DeepSpace00/Awohali/README.md

# ᎠᏬᎭᎵ (Awohali)

Pronounced (Ah-wo-ha-lee)

This project is archived. Current development has migrated to [Codeberg](https://codeberg.org/Fiducial-Systems/Awohali)

An open source hardware GNSS receiver station for measuring tropospheric precipitable water vapor.

A master's thesis project within Embry-Riddle Aeronautical University's Physical Science Department.

⚠️ WARNING This project is currently under development ⚠️

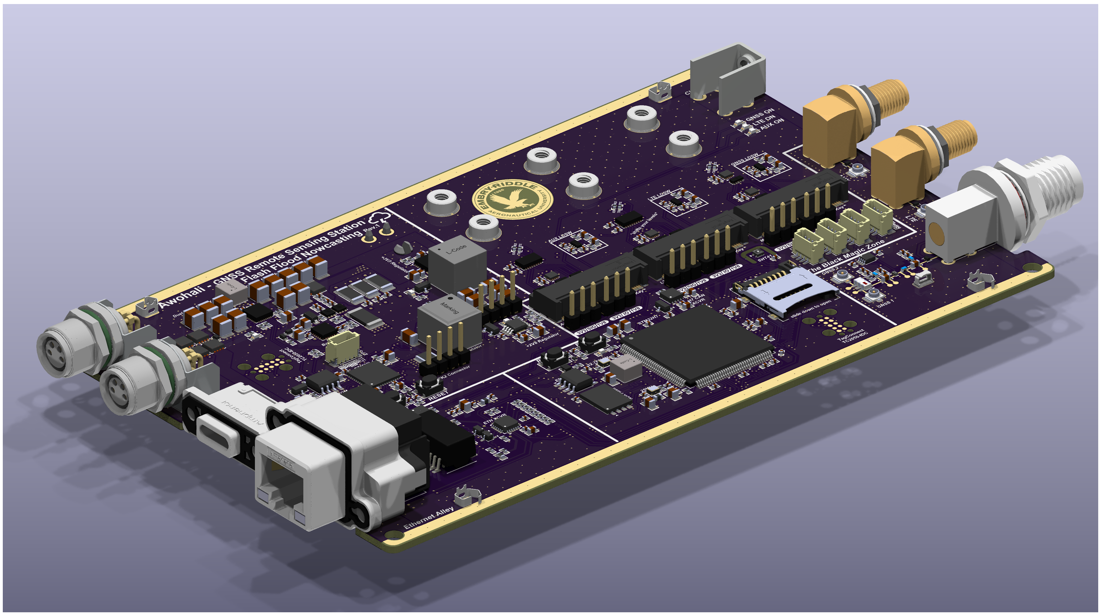
[picture p1: docs/assets/mainBoard_top_iso.png]


## Docs

https://deepspace00.github.io/Awohali/

## Hardware 

Preview with [KiCanvas](https://kicanvas.org/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)

## Licenses

Documentation, firmware, hardware, and software are individually licensed. Terms and conditions apply within their respective folders.

**Documentation -** [Apache License 2.0](docs/LICENSE)

**Firmware/Software -** [The MIT License](firmware/LICENSE)

**Hardware -** [CERN-OHL-P v2 or later](hardware/LICENSE)
