DeepSpace00/Awohali/hardware/mechanical/cables/power-cable/ALTW M Series M8 Product Specification.pdf

# Sensor M8 A/B/D Code

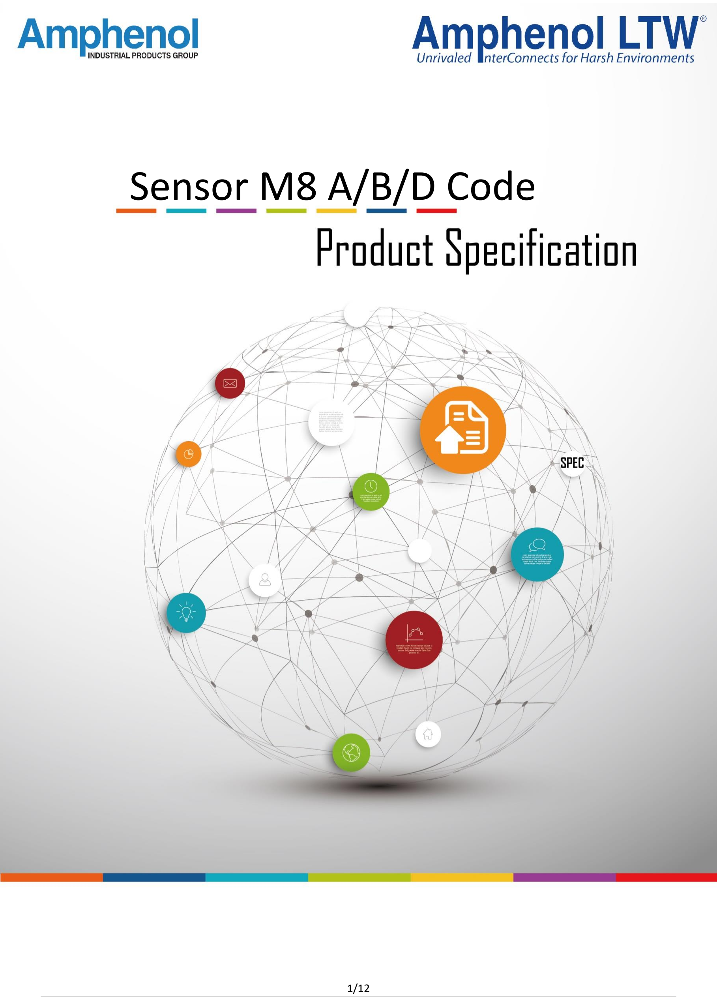
[picture p2: page 1]

### 1. Scope / 概論

A leading professional solutions provider of waterproof connectors (overmolded with cable, receptacle, field installable) in

the industry, Amphenol LTW always fulfills any requirements with high functionality and reliability products; even it is a

very special requirement. And it is highly recommended to be applied to harsh environment.

### Amphenol LTW（ALTW）是防水連接器計設及生產的領導者,主要包含線端,板端及現場組裝式連接器以滿足各種使用

### 求及特殊要求,產品具有高效能及高可靠性,非常適合在各種惡劣的環境條件下提供安裝及使用。

This product specification sheet describes the product application in the markets such as Renewable Energy, Industrial

Automation, LED Lighting, Marine, Broadband Wireless Access, Smart Grid, Heavy Equipment, Medical, Electrical

Vehicle….etc.

### 本規範主要描述了 Amphenol LTW(ALTW)產品的應用要求。 本產品廣泛應用於可再生能源，工業自動化，LED，船舶，

寬帶無線接入，智能電網，建築機械/重型車輛，醫療設備等，電動車行業....

### 2. Applicable Documents / 參考文件

### 2.1 Industry Document / 業界標準

Amphenol LTW（ALTW）設計及生產的產品符合各項世界標準,包括 IEC, EIA, MIL, NMEA….

### 3. Specification / 規格

### 3.1 Material / 材質

Parts / 零件 | Material / 材質
Connector / 連接器 | Thermoplastic / 熱塑性塑膠
Pin / 端子 | Copper Alloy / 銅合金
Nut / 螺帽 | Thermoplastic / 熱塑性塑膠, Metal / 金屬
Clamp Ring / 夾環 | Thermoplastic / 熱塑性塑膠
O-Ring / O 型環 Gasket / 墊圈 Seal / 密封圈 | Rubber / 橡膠
Shield/Shell / 屏蔽 | Metal / 金屬

### 3.2 Rating / 操作評級

Voltage 電壓 | Rated voltage – Rated impulse voltage
Name | CODE | Pin No. | Voltage
M8 | A | 3 | 50V AC / 60V DC
| A | 4 | 50V AC / 60V DC
| D | 4 | 50V AC / 63V DC
| B | 5 | 30V AC/DC
| A | 6 | 30V AC/DC
| A | 8 | 30V AC/DC

Current 電流

Name | CODE | Pin No. | Current Rating
M8 | A | 3 | 3A & 4A
| A | 4 | 3A & 4A
| D | 4 | 3A & 4A
| B | 5 | 3A
| A | 6 | 1.5A
| A | 8 | 1.5A
Operating Temperature 操作溫度 | Overmolded With Cable / Receptacle With Wires : -25°C~85°C (攝氏-25 度~85 度) Receptacle / Field Installable : -40°C~105°C (攝氏-40 度~105 度)
IP 防水等級 | Overmolded With Cable : IP67 (Mated, 1M /30min) / IP68 (Mated, 1M / 24h) Receptacle / Receptacle With Wires : IP67 (Unmated, 1M /30min)/ IP68 (Unmated, 1M /24h) / IP69K (Mated) Field Installable : IP67 (Mated, 1M /30min) / IP68 (Mated, 1M / 24h)

### 4. Test Requirement/測試要求

### 4.1 Appearance/外觀

Item / 項目 | Test Condition / 測試條件 | Requirement / 條件需求
Examination of product 外觀檢查 | IEC 60512, Test 1a Visual inspection No physical damage 檢查外觀是否有損壞 | No defect would impair normal operation 沒有缺陷會影響正常操作

### 4.2 Electrical/電氣

Item / 項目 | Test Condition / 測試條件 | Requirement / 條件需求
Dielectric Withstanding Voltage 耐電壓試驗 | IEC 60512, Test 4a, Method A Standard atmospheric conditions, Mated connectors 標準大氣條件,對接連接器 | See table A-1
Contact Resistance 接觸阻抗 | IEC 60512, Test 2a Standard atmospheric conditions connecting points 標準大氣壓力下測試接觸點 | •10 mΩ max. •10 mΩ 最大
Insulation Resistance 絕緣阻抗 | IEC 60512, Test 3a, Method A Standard atmospheric conditions Test voltage 500 V ± 15 V d.c. 標準大氣壓力下使用 500 V ± 15 V d.c.測試 | •10⁸mΩ min. •10⁸ mΩ 最小
Temperature Rise 溫升試驗 | UL1977 section 16.1, Mated connector carry the maximum rated current (table) continuously for 4 hour and measure the temperature rise of contact.UL1977 第 16.1 節，配合連接器連續輸入最大額定電流（附件）4 小時，測量接觸 溫升。 | •Temperature rise △t is no more than Relative Thermal Index of the insulating material •溫升△t 不大於絕緣材料的相對熱指數
| UL 2238 section 25, Mated connector carry the maximum rated current (table) continuously for 4 hour and measure the temperature rise of contact. 連接器對接後，額定電流(附件)持續輸入 4 小時，測量接觸點溫升。 | •UL : The temperature do not exceed the RTI of insulating material. •CUL : Temperature rise ∆t is no more than 30 ℃ , also for CUL ( CSA C22.2 No. 182.3,Clause 6.5 ) •UL: 溫度不超過絕緣材料的 RTI •CUL: 溫度升高Δt 不超過 30℃

### Table A-1

Voltage proof | kV r.m.s.
No. of ways | Between contacts | Between contacts and metal-housing
Fixed connectors | Free connectors | Fixed connectors | Free connectors
A | 3 | 1.0 | 1.0 | 0.85 | 0.85
A | 4 | 1.0 | 1.0 | 0.85 | 0.85
A | 6 | 0.65 | 0.65 | 0.65 | 0.65
A | 8 | 0.65 | 0.65 | 0.65 | 0.65
B | 5 | 0.65 | 0.65 | 0,65 | 0.65
D | 4 | 0.84 | 0.84 | 0.84 | 0.84

### 4.3 Mechanical/機械

Item / 項目 | Test Condition / 測試條件 | Requirement / 條件需求
Durability 耐久性 | IEC 60512, Test 9a Standard atmospheric conditions, Max. speed of operations = 10 mm/s, Rest:30s,unmated 最大插拔速率10mm/s, 分離狀態下停留30s | • No physical damage • 100 cycles for gold plating • 50 cycles for silver plating • 20 cycles for tin plating • 無物理損害 • 鍍金需至少滿足 100 次插拔 • 鍍銀需至少滿足 50 次插拔 • 鍍錫需至少滿足 20 次插拔
Insertion Force and Withdrawal force Test 插拔力 | IEC 60512, Test 13b Standard atmospheric conditions, Max. speed of operations = 10 mm/s, 標準大氣壓下測試, 最大插拔速度為10mm/s | 成品對插，無對鎖動作 • Total insertion force 3~8Pin: 30N maximum • Total withdrawal force 3~8Pin: 23N maximum • 插入力: 3~8Pin: 30N 最大 • 拔出力: 3~8Pin: 23N 最大
Vibration 震動試驗 | IEC 60512, Test 6d 10~500Hz, and 0.35mm or 50m/s2, sweep cycle: 10 cycle on each of the 3 axes 頻率 : 10~500Hz, 掃描周期: 每軸向做 10 個循環測試，3 個軸向均需測 | • No physical damages • No electrical discontinuity more than 1μ second. • 無物理損害 • 電氣訊斷不超過 1μ second
Mechanical Shock 物理沖擊 | IEC 60512-6-3, test 6c acceleration 500 m/s2 加速度 500m/s2 | •No physical damages •No electrical discontinuity more than 1μ second. •無物理損害 •電氣訊斷不超過 1μ second

### 4.4 Environmental/環境

Item / 項目 | Test Condition / 測試條件 | Requirement / 條件需求

Waterproof Test

防水測試

IEC 60529, IPX5

Test nozzle ∅6.3 mm, Water flow rate 12.5L/min, distance 2.5 m to 3 m,duration

3 minutes.

噴嘴∅6.3mm，水流速 12.5L / min，距離 2.5m 至 3m，持續時間 3 分鐘。

IEC 60529,IPX6

Test nozzle ∅12.5mm, Water flow rate 100L/min, distance 2.5 m to 3 m,duration

3 minutes.

噴嘴∅12.5mm，水流速 100L / min，距離 2.5 m 至 3 m，持續時間 3 分鐘。

IEC 60529, IPX7

Should be immersed in water at depth of at least 1 m for 30 mintues.

浸入深度至少 1 米的水中 30 分鐘。

IEC 60529, IPX8

should be immersed in water at depth of at least 1 m for 24 hours.

浸入深度至少 1 米的水中 24 小時。

IEC 60529, IPX9

Protected against high pressure and temperature water jets

防止高壓高溫的水柱噴射

DIN 40050-9, IPX9K

protection against high pressure/steam jet cleaning

防止高壓/蒸汽噴射清潔

•No physical damages

•Visual inspection inside no water

•Insulation resistance: >100MΩ

•無物理損壞

•目視內部無水侵入

•絕緣電阻：>100MΩ

Rapid change of temperature 溫度變化 | IEC 60512-11d –25 °C to 85 °C, t = 30 min, 5 cycles –25 °C to 85 °C, 時間 30 min, 5 個循環 | •No physical damages •無物理損壞
Salt Spray 鹽水噴霧試驗 | IEC 60068-2-60 5% salt solution for 48 hours 5%鹽水溶液持續 48 小時 | No physical damages and meets sequenced tests. 無物理損壞

### 5. Product Qualification Test Sequence/測試群組及順序

Test or Examination | Test Group
A | B | C | D | E | F | G
Examination of product | Visual Examination | 1,9 | 1,9 | 1,7 | 1,7 | 1,3 | 1,9 | 1,3
Electrical 電氣 | Contact Resistance | 2,6 | 2,6 | | 2,6
| insulation Resistance | 3,7 | 3,7 | 2,6 | | | 3,7
| Dielectric Withstanding Voltage | 4,8 | 4,8 | 3,5 | | | 2,8
| Temperature Rise Test | | | | | 2
Mechanical 機械 | Insertion Force and Withdrawal force Test | | | | 3,5
| Durability | | | | 4
| Vibration Test | 5
| Mechanical Shock | | 5
Environmental 環境 | Rapid change of temperature | | | 4 | | | 5
| Salt Spray | | | | | | | 2
| Waterproof Test | | | | | | 4,6

### 6. Others/其他

### 6.1 Torque/扭力

Panel Nut / 鎖板 (板端) | 5~8 kgf.cm
Mating Nut (Overmolded With Cable/Field Installable) / 對插 (線端/組裝式) | 4~6 kgf.cm
Clamp Ring / 接管 (組裝式) | 3~4 kgf.cm
Sealing Nut / 尾蓋 (組裝式) | 6~8 kgf.cm
Screw of the Screw-in type / 鎖芯線螺絲 (組裝式) | 0.61~0.84 kgf.cm

6.2 Reflow recommended profile for SMT product.

IPC_JEDEC J-STD-020C

Recommended Soldering Profiles

Classification of Reflow Profiles

Profile Feature | Sn – Pb Eutectic Assembly | Lead (Pb)-Free Assembly (e.g. SnAgCu)
Average ramp-up rate (T(Smax.) to TP) | 3 °C/s maximum
Preheat • Temperature minimum (TS(min.)) • Temperature maximum (TS(max.)) • Time (TS(min.) to TS(max.)) (tS) | 100°C 150°C 60 s to 120 s | 150°C 200°C 60 s to 180 s
Time maintained above • Temperature minimum (TL) • Time (TL) | 183°C 60 s to 150 s | 217 60 s to 150 s
Minimum peak temperature (TP(min.)) | 215°C | 235°C
Recommended peak temperature (TP) | 235°C | 250°C
Maximum peak temperature (TP(max.)) | 260°C | 260°C
Time within 5°C of actual peak temperature (tP) | 10 s to 40 s | 20 s to 40 s
Ramp-down rate | 6°C/s maximum | 6°C/s maximum
Time 25°C to peak temperature | 6 min maximum | 8 min maximum

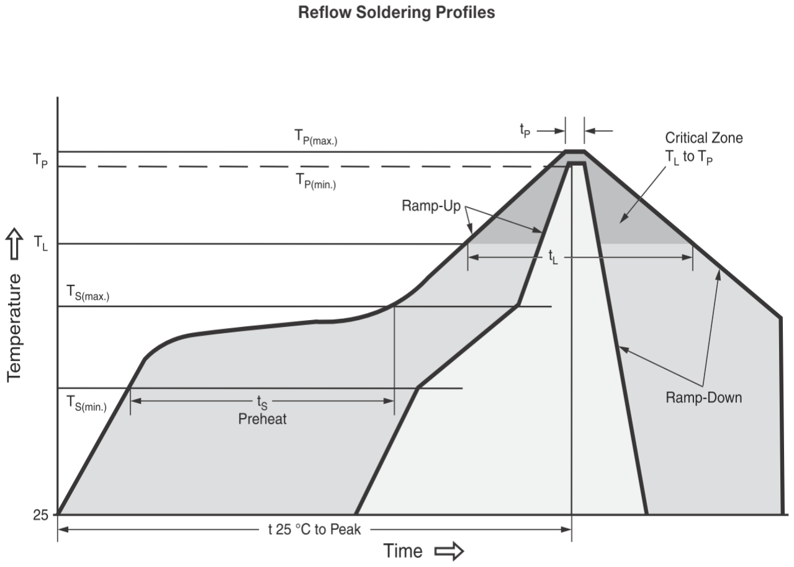
[picture p3: figure]

### 7. Quality Assurance Provisions/品質保證

Unless otherwise specified, in the contract or purchase order, we will be responsible for the quality of the part as it is

delivered to client. We will be responsible for having controlled processes to ensure product is in total compliance with this

specification. Failing lots shall be subject to return or other corrective action.

### 除非在合同或採購訂單中另有規定者外，我們將對交付給客戶的部件質量負責。 我們將負責控制流程，以確保產品

### 完全符合規格。 未通過的批次應退回或採取其他糾正措施。

### Re-qualification Testing : 重新資格測試

If changes significantly affecting form, fit or function are made to the product or manufacturing process, product assurance

shall coordinate requalification testing, consisting of all or part of the original testing sequence as determined by

development/product, quality and reliability engineering.

### 如果對產品或製造過程產生顯著影響的形狀，配合或功能的變化，產品保證應協調重新認證測試，包括由開發/產品，

### 質量和可靠性工程確定的全部或部分的原始測試順序。

Our products perform per the specification and criteria described in this document; any usage outside and/or deviating

from the specification and criteria described in this document, and/or any alteration, modification, transformation, and

application not mentioned in this document must be checked and agreed with ALTW in prior. Failure to check and get our

agreement, ALTW will bear no responsibility for any consequence that might arise. It is strongly advised to always check

with ALTW for any product application not mentioned in this document and/or applications that need clarifications.

### 本公司產品之規格及標準，皆依本說明書之說明。對於任何超出或背離本說明書規格範圍之產品使用，或對說明書

### 為提及的任何修改、變更，變造，應用，皆應取得 ALTW 事前的認可，否則 ALTW 對之不負擔任何責任。若對於本

### 說明書說明規格未有規定的事項，或使用上有疑義者，強烈建議先取得 ALTW 之確認及說明。

### 8. Revision/版本

Document Name | Sensor-M8
Revision | ECN NO. | Description | Date | Sign
A | | Initial Release | 2021/05/14 | Neo Tsai 蔡於潤
B | | Screw of the Screw-in type / 鎖芯線螺絲 (組裝式) change force | 2022/07/21 | Neo Tsai 蔡於潤
C | | Updated IP rate | 2023/03/16 | Yunchen Lai 賴昀辰
D | | Delete Voltage M8 A code 12Pin | 2023/05/24 | Jiahe Lin 林珈禾

### WI0814-05-表單 03A1
