DeepSpace00/Awohali/docs/assets/mainBoard_bottom.png

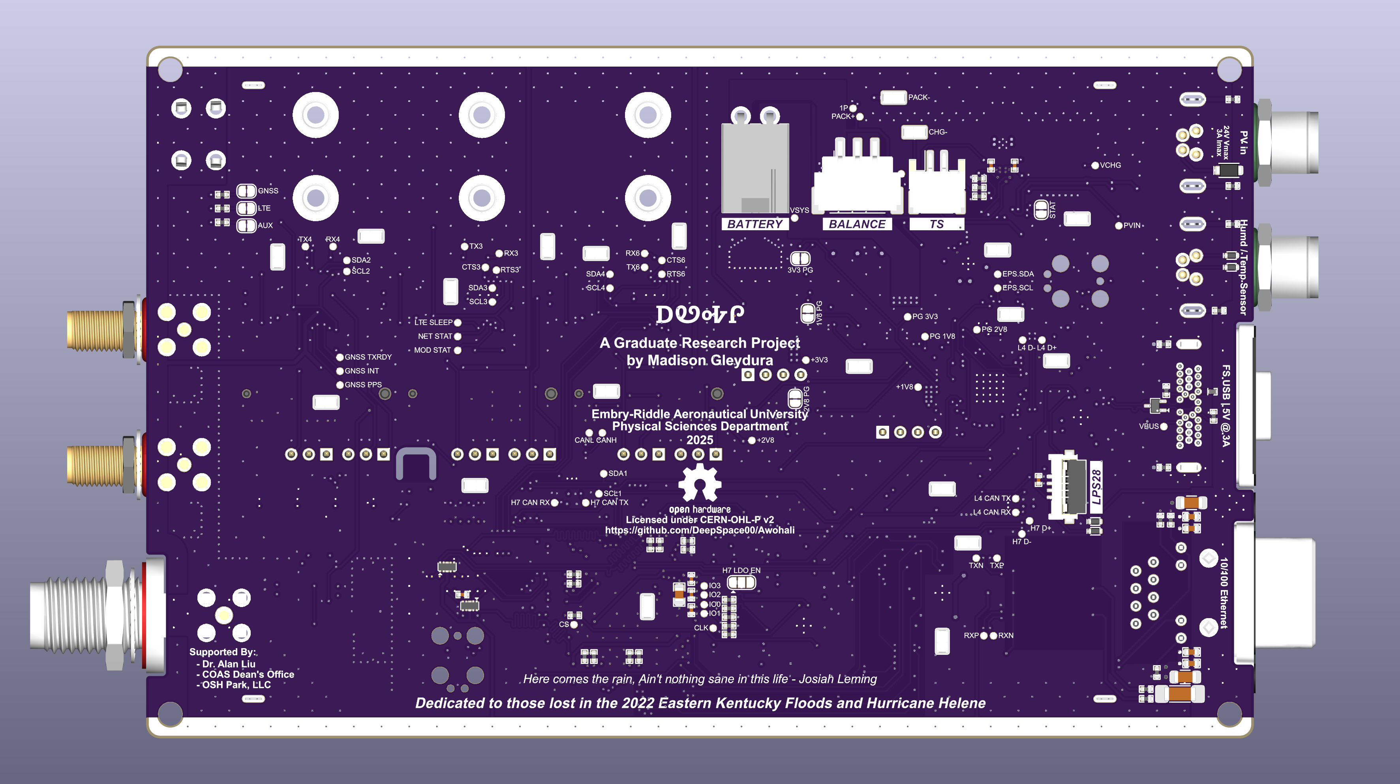
docs/assets/mainBoard_bottom.png
