DeepSpace00/Awohali/docs/assets/mainBoard_bottom_iso.png

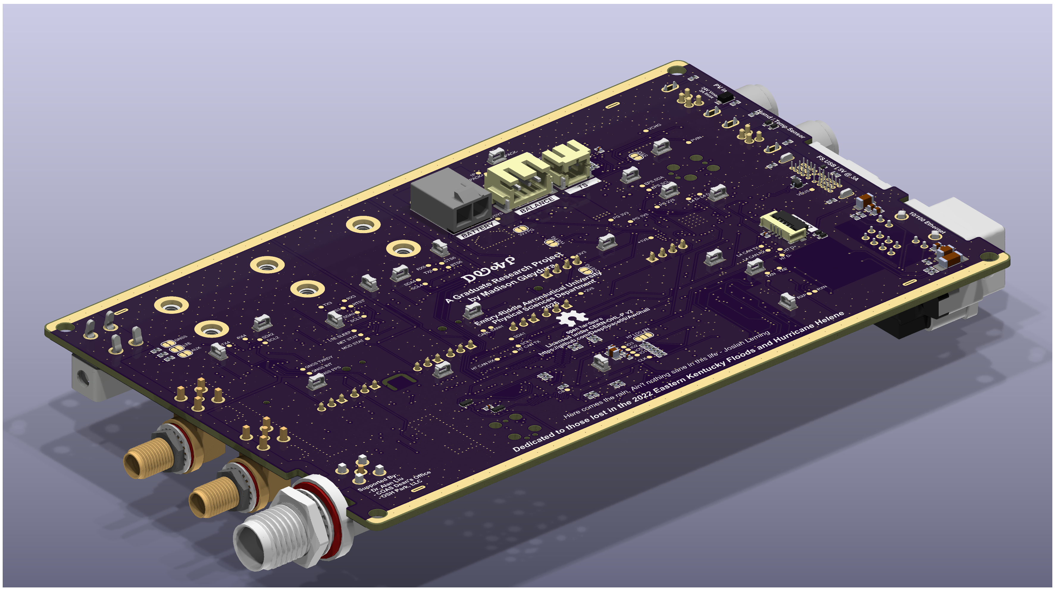
docs/assets/mainBoard_bottom_iso.png
