DeepSpace00/Awohali/docs/assets/mainBoard_top.png

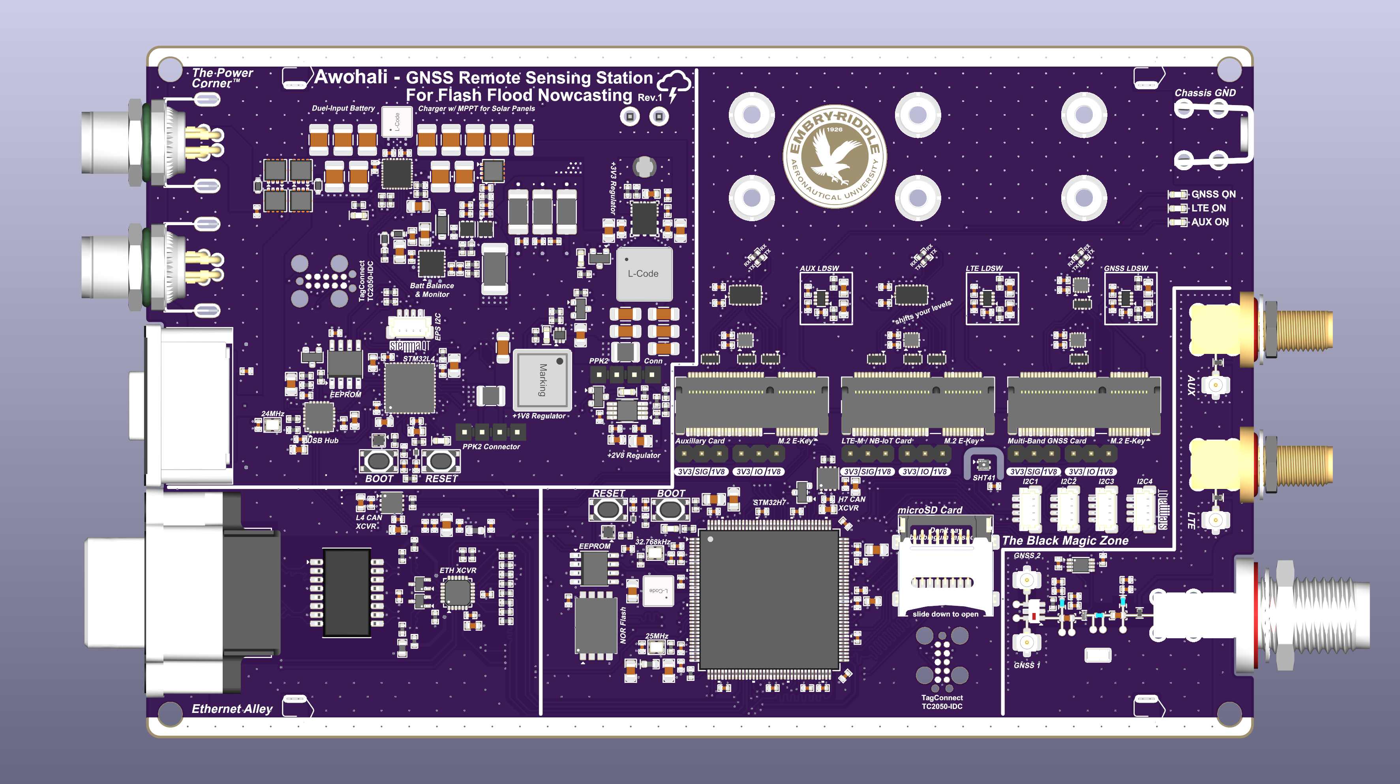
docs/assets/mainBoard_top.png
