DeepSpace00/Awohali/hardware/electronics/mainBoard/manufacturing/assembly/Awohali_Mainboard_BOM_DigiKey.xlsx

Index | Manufacturer Part Number | Manufacturer Name | Attrition % | Requested Quantity 1 | Pack Quantity 1 | Pack Type 1 | Digi-Key Part Number 1 | Unit Price 1 | Extended Price 1 | Minimum Order Quantity 1 | Product Notes
1 | RFPC-TNC01-FN-A | GCT (Gradconn) |  | 1 | 1 | Tray | 2072-RFPC-TNC01-FN-A-ND | 11.53000 | $11.53 | 1
2 | RFPC-SMA14-FN-A | GCT (Gradconn) |  | 2 | 2 | Tray | 2072-RFPC-SMA14-FN-A-ND | 16.10000 | $32.20 | 1
3 | GRT155R71H104KE01D | Murata Electronics |  | 89 | 89 | Cut Tape (CT) | 490-GRT155R71H104KE01DCT-ND | 0.02700 | $2.40 | 1
4 | GRT21BR71C475KE13L | Murata Electronics |  | 4 | 4 | Cut Tape (CT) | 490-GRT21BR71C475KE13LCT-ND | 0.22000 | $0.88 | 1
5 | GCM21BR71A106KE22L | Murata Electronics |  | 7 | 7 | Cut Tape (CT) | 490-10674-1-ND | 0.41000 | $2.87 | 1
6 | GRT188R71E105KE13D | Murata Electronics |  | 22 | 22 | Cut Tape (CT) | 490-GRT188R71E105KE13DCT-ND | 0.06600 | $1.45 | 1
7 | GRT155R71H221KE01D | Murata Electronics |  | 1 | 1 | Cut Tape (CT) | 490-GRT155R71H221KE01DCT-ND | 0.10000 | $0.10 | 1
8 | GRT21BR71E225KE13L | Murata Electronics |  | 6 | 6 | Cut Tape (CT) | 490-GRT21BR71E225KE13LCT-ND | 0.21000 | $1.26 | 1
9 | GRT1555C2A330JA02D | Murata Electronics |  | 2 | 2 | Cut Tape (CT) | 490-GRT1555C2A330JA02DCT-ND | 0.10000 | $0.20 | 1
10 | GRM31CZ72A475KE11L | Murata Electronics |  | 2 | 2 | Cut Tape (CT) | 490-GRM31CZ72A475KE11LCT-ND | 0.75000 | $1.50 | 1
11 | GCJ188R72A104KA01D | Murata Electronics |  | 4 | 4 | Cut Tape (CT) | 490-13420-1-ND | 0.16000 | $0.64 | 1
12 | GRT155R71H223KE01D | Murata Electronics |  | 1 | 1 | Cut Tape (CT) | 490-GRT155R71H223KE01DCT-ND | 0.10000 | $0.10 | 1
13 | GR442QR73D102KW01L | Murata Electronics |  | 1 | 1 | Cut Tape (CT) | 490-8145-1-ND | 0.81000 | $0.81 | 1
14 | GRT155R71H471KE01D | Murata Electronics |  | 1 | 1 | Cut Tape (CT) | 490-GRT155R71H471KE01DCT-ND | 0.10000 | $0.10 | 1
15 | GCM1555C1H101FA16D | Murata Electronics |  | 4 | 4 | Cut Tape (CT) | 490-14349-1-ND | 0.10000 | $0.40 | 1
16 | GCM1555C1H680FA16D | Murata Electronics |  | 1 | 1 | Cut Tape (CT) | 490-16440-1-ND | 0.10000 | $0.10 | 1
17 | GQM1875C2E101GB12D | Murata Electronics |  | 2 | 2 | Cut Tape (CT) | 490-7172-1-ND | 0.57000 | $1.14 | 1
18 | GCM32ER71E106KA57L | Murata Electronics |  | 12 | 12 | Cut Tape (CT) | 490-4798-1-ND | 0.39700 | $4.76 | 1
19 | GRT155R71E473KE01D | Murata Electronics |  | 3 | 3 | Cut Tape (CT) | 490-GRT155R71E473KE01DCT-ND | 0.10000 | $0.30 | 1
20 | GRT155R71C224KE01D | Murata Electronics |  | 3 | 3 | Cut Tape (CT) | 490-GRT155R71C224KE01DCT-ND | 0.10000 | $0.30 | 1
21 | GCM31CR71A226ME02L | Murata Electronics |  | 6 | 6 | Cut Tape (CT) | 490-16383-1-ND | 0.79000 | $4.74 | 1
22 | SZESD9R3.3ST5G | onsemi |  | 2 | 2 | Cut Tape (CT) | SZESD9R3.3ST5GOSCT-ND | 0.62000 | $1.24 | 1
23 | IN-PI15TAT5R5G5B | Inolux |  | 2 | 2 | Cut Tape (CT) | 1830-IN-PI15TAT5R5G5BCT-ND | 0.51000 | $1.02 | 1
24 | LTST-C191KRKT | Lite-On Inc. |  | 5 | 5 | Cut Tape (CT) | 160-1447-1-ND | 0.15000 | $0.75 | 1
25 | D3V3F4U10LP-7 | Diodes Incorporated |  | 2 | 2 | Cut Tape (CT) | D3V3F4U10LP-7DICT-ND | 0.24000 | $0.48 | 1
26 | TPD1E05U06QDPYRQ1 | Texas Instruments |  | 1 | 1 | Cut Tape (CT) | 296-47863-1-ND | 0.33000 | $0.33 | 1
27 | TPD2E2U06QDCKRQ1 | Texas Instruments |  | 3 | 3 | Cut Tape (CT) | 296-44302-1-ND | 0.44000 | $1.32 | 1
28 | LTST-C191KGKT | Lite-On Inc. |  | 4 | 4 | Cut Tape (CT) | 160-1446-1-ND | 0.15000 | $0.60 | 1
29 | PESD4USB3U-TTSX | Nexperia USA Inc. |  | 8 | 8 | Cut Tape (CT) | 1727-PESD4USB3U-TTSXCT-ND | 0.51000 | $4.08 | 1
30 | PTVS4V5D1BLYL | Nexperia USA Inc. |  | 3 | 3 | Cut Tape (CT) | 1727-7415-1-ND | 0.15000 | $0.45 | 1
31 | ESD321DYAR | Texas Instruments |  | 4 | 4 | Cut Tape (CT) | 296-ESD321DYARCT-ND | 0.22000 | $0.88 | 1
32 | PTVS13VS1UR,115 | Nexperia USA Inc. |  | 1 | 1 | Cut Tape (CT) | 1727-5347-1-ND | 0.34000 | $0.34 | 1
33 | BZT52C12T-7 | Diodes Incorporated |  | 2 | 2 | Cut Tape (CT) | BZT52C12T-7DICT-ND | 0.11000 | $0.22 | 1
34 | SDM20U40Q-7 | Diodes Incorporated |  | 2 | 2 | Cut Tape (CT) | 31-SDM20U40Q-7CT-ND | 0.15000 | $0.30 | 1
35 | MMSZ5246B-7-F | Diodes Incorporated |  | 1 | 1 | Cut Tape (CT) | MMSZ5246B-FDICT-ND | 0.11000 | $0.11 | 1
36 | 7793 | Keystone Electronics |  | 1 | 1 | Bulk | 36-7793-ND | 0.66000 | $0.66 | 1
37 | S1761-46R | Harwin Inc. |  | 4 | 4 | Cut Tape (CT) | 952-2152-1-ND | 0.40000 | $1.60 | 1
38 | BM04B-SRSS-TB | JST Sales America Inc. |  | 5 | 5 | Cut Tape (CT) | 455-BM04B-SRSS-TBCT-ND | 0.52000 | $2.60 | 1
39 | MEM2067-02-180-00-A | GCT |  | 1 | 1 | Cut Tape (CT) | 2073-MEM2067-02-180-00-ACT-ND | 1.06000 | $1.06 | 1
40 | MRJ5381M1 | Amphenol ICC (Commercial Products) |  | 1 | 1 | Box | MRJ5381M1-ND | 14.91000 | $14.91 | 1
41 | PRPC003SAAN-RC | Sullins Connector Solutions |  | 6 | 6 | Bag | S1011EC-03-ND | 0.32000 | $1.92 | 1
42 | MDT420E01001 | Amphenol ICC (FCI) |  | 3 | 3 | Cut Tape (CT) | MDT420E01001CT-ND | 2.09000 | $6.27 | 1
43 | 123A-NUT-42 | ATTEND Technology |  | 6 | 6 | Cut Tape (CT) | 4827-123A-NUT-42CT-ND | 0.51000 | $3.06 | 1
44 | CONMHF1-SMD-T | TE Connectivity Linx |  | 4 | 4 | Cut Tape (CT) | 343-CONMHF1-SMD-TCT-ND | 0.23000 | $0.92 | 1
45 | M8S-04PFFR-SF8001 | Amphenol LTW |  | 2 | 2 | Bulk | 1754-1451-ND | 15.28000 | $30.56 | 1
46 | 2005280040 | Molex |  | 1 | 1 | Cut Tape (CT) | WM20760CT-ND | 0.49000 | $0.49 | 1
47 | S2B-PH-SM4-TB | JST Sales America Inc. |  | 1 | 1 | Cut Tape (CT) | 455-S2B-PH-SM4-TBCT-ND | 0.48000 | $0.48 | 1
48 | S3B-XH-SM4-TB | JST Sales America Inc. |  | 1 | 1 | Cut Tape (CT) | 455-S3B-XH-SM4-TBCT-ND | 0.61000 | $0.61 | 1
49 | 1726480102 | Molex |  | 1 | 1 | Tray | 1726480102-ND | 0.76000 | $0.76 | 1
50 | PHT-104-01-L-S | Samtec Inc. |  | 2 | 2 | Bulk | PHT-104-01-L-S-ND | 1.29000 | $2.58 | 1
51 | MFBA3V1608K-601-R | Eaton - Electronics Division |  | 2 | 2 | Cut Tape (CT) | 283-MFBA3V1608K-601-RCT-ND | 0.10000 | $0.20 | 1
52 | 74439324022 | Würth Elektronik |  | 2 | 2 | Cut Tape (CT) | 732-74439324022CT-ND | 1.62000 | $3.24 | 1
53 | LQW15AN82NG0ZD | Murata Electronics |  | 2 | 2 | Cut Tape (CT) | 490-LQW15AN82NG0ZDCT-ND | 0.19000 | $0.38 | 1
54 | LQW15AN11NG0ZD | Murata Electronics |  | 1 | 1 | Cut Tape (CT) | 490-LQW15AN11NG0ZDCT-ND | 0.19000 | $0.19 | 1
55 | 74439387100 | Würth Elektronik |  | 1 | 1 | Cut Tape (CT) | 732-74439387100CT-ND | 2.34000 | $2.34 | 1
56 | 74439358010 | Würth Elektronik |  | 1 | 1 | Cut Tape (CT) | 732-7273-1-ND | 4.22000 | $4.22 | 1
57 | BSS138-7-F | Diodes Incorporated |  | 5 | 5 | Cut Tape (CT) | BSS138-FDICT-ND | 0.16000 | $0.80 | 1
58 | CSD17581Q3A | Texas Instruments |  | 5 | 5 | Cut Tape (CT) | 296-47754-1-ND | 0.95000 | $4.75 | 1
59 | BUK6D72-30EX | Nexperia USA Inc. |  | 2 | 2 | Cut Tape (CT) | 1727-8677-1-ND | 0.45000 | $0.90 | 1
60 | CRCW04024K70FKED | Vishay Dale |  | 10 | 10 | Cut Tape (CT) | 541-4.70KLCT-ND | 0.03000 | $0.30 | 1
61 | CRCW040210K0FKED | Vishay Dale |  | 19 | 19 | Cut Tape (CT) | 541-10.0KLCT-ND | 0.03000 | $0.57 | 1
62 | CRCW04020000Z0ED | Vishay Dale |  | 16 | 16 | Cut Tape (CT) | 541-0.0JCT-ND | 0.01600 | $0.26 | 1
63 | CRCW0402100RJNED | Vishay Dale |  | 7 | 7 | Cut Tape (CT) | 541-100JCT-ND | 0.10000 | $0.70 | 1
64 | CRCW0402412RFKED | Vishay Dale |  | 1 | 1 | Cut Tape (CT) | 541-412LCT-ND | 0.10000 | $0.10 | 1
65 | CRCW040247R0FKED | Vishay Dale |  | 1 | 1 | Cut Tape (CT) | 541-47.0LCT-ND | 0.10000 | $0.10 | 1
66 | CRCW040222R0FKED | Vishay Dale |  | 3 | 3 | Cut Tape (CT) | 541-22.0LCT-ND | 0.10000 | $0.30 | 1
67 | CRCW0402100KFKED | Vishay Dale |  | 7 | 7 | Cut Tape (CT) | 541-100KLCT-ND | 0.10000 | $0.70 | 1
68 | CRCW04025K10FKED | Vishay Dale |  | 5 | 5 | Cut Tape (CT) | 541-5.10KLCT-ND | 0.10000 | $0.50 | 1
69 | CRCW040212K0FKED | Vishay Dale |  | 1 | 1 | Cut Tape (CT) | 541-12.0KLCT-ND | 0.10000 | $0.10 | 1
70 | CRCW040249R9FKED | Vishay Dale |  | 4 | 4 | Cut Tape (CT) | 541-49.9LCT-ND | 0.10000 | $0.40 | 1
71 | CRCW060310R0FKEA | Vishay Dale |  | 1 | 1 | Cut Tape (CT) | 541-10.0HCT-ND | 0.10000 | $0.10 | 1
72 | CRCW040275R0FKED | Vishay Dale |  | 2 | 2 | Cut Tape (CT) | 541-75.0LCT-ND | 0.10000 | $0.20 | 1
73 | CRCW040233R0FKED | Vishay Dale |  | 4 | 4 | Cut Tape (CT) | 541-33.0LCT-ND | 0.10000 | $0.40 | 1
74 | CRCW040212K1FKED | Vishay Dale |  | 1 | 1 | Cut Tape (CT) | 541-12.1KLCT-ND | 0.10000 | $0.10 | 1
75 | CRCW0402270RFKED | Vishay Dale |  | 2 | 2 | Cut Tape (CT) | 541-270LCT-ND | 0.10000 | $0.20 | 1
76 | CRCW0402120RFKED | Vishay Dale |  | 2 | 2 | Cut Tape (CT) | 541-120LCT-ND | 0.10000 | $0.20 | 1
77 | CRCW0402150RFKED | Vishay Dale |  | 6 | 6 | Cut Tape (CT) | 541-150LCT-ND | 0.10000 | $0.60 | 1
78 | FC0402E50R0BST1 | Vishay Dale Thin Film |  | 1 | 1 | Cut Tape (CT) | FC0402-50BWCT-ND | 1.89000 | $1.89 | 1
79 | CRCW0402294RFKED | Vishay Dale |  | 1 | 1 | Cut Tape (CT) | 541-294LCT-ND | 0.10000 | $0.10 | 1
80 | CRCW04028K20FKED | Vishay Dale |  | 1 | 1 | Cut Tape (CT) | 541-8.20KLCT-ND | 0.10000 | $0.10 | 1
81 | CRCW04026K04FKED | Vishay Dale |  | 1 | 1 | Cut Tape (CT) | 541-6.04KLCT-ND | 0.10000 | $0.10 | 1
82 | CRCW040247K0FKED | Vishay Dale |  | 1 | 1 | Cut Tape (CT) | 541-47.0KLCT-ND | 0.10000 | $0.10 | 1
83 | CRCW040229K4FKED | Vishay Dale |  | 1 | 1 | Cut Tape (CT) | 541-29.4KLCT-ND | 0.10000 | $0.10 | 1
84 | CRCW04022K20FKED | Vishay Dale |  | 1 | 1 | Cut Tape (CT) | 541-2.20KLCT-ND | 0.10000 | $0.10 | 1
85 | CRCW201010R0FKEF | Vishay Dale |  | 3 | 3 | Cut Tape (CT) | 541-10.0ACCT-ND | 0.23000 | $0.69 | 1
86 | WSL2512R0400FEA18 | Vishay Dale |  | 1 | 1 | Cut Tape (CT) | WSLH-.04CT-ND | 1.69000 | $1.69 | 1
87 | CRCW040210M0FKED | Vishay Dale |  | 1 | 1 | Cut Tape (CT) | 541-10.0MLCT-ND | 0.10000 | $0.10 | 1
88 | CRCW12100000Z0EA | Vishay Dale |  | 2 | 2 | Cut Tape (CT) | 541-0.0VCT-ND | 0.13000 | $0.26 | 1
89 | CRCW040251K1FKED | Vishay Dale |  | 1 | 1 | Cut Tape (CT) | 541-51.1KLCT-ND | 0.10000 | $0.10 | 1
90 | CRCW0402200KFKED | Vishay Dale |  | 1 | 1 | Cut Tape (CT) | 541-200KLCT-ND | 0.10000 | $0.10 | 1
91 | CRCW0402499KFKED | Vishay Dale |  | 1 | 1 | Cut Tape (CT) | 541-499KLCT-ND | 0.10000 | $0.10 | 1
92 | CRCW0402220KFKED | Vishay Dale |  | 1 | 1 | Cut Tape (CT) | 541-220KLCT-ND | 0.10000 | $0.10 | 1
93 | CRCW040230K0FKED | Vishay Dale |  | 2 | 2 | Cut Tape (CT) | 541-30.0KLCT-ND | 0.10000 | $0.20 | 1
94 | PTS810SJM250SMTR LFS | C&K |  | 4 | 4 | Cut Tape (CT) | CKN10502CT-ND | 0.51000 | $2.04 | 1
95 | RCWCTE | KOA Speer Electronics, Inc. |  | 22 | 22 | Cut Tape (CT) | 2019-RCWCTECT-ND | 0.10900 | $2.40 | 1
96 | STM32H745ZIT3 | STMicroelectronics |  | 1 | 1 | Tray | 497-STM32H745ZIT3-ND | 19.91000 | $19.91 | 1
97 | M24512-DRMN8TP/K | STMicroelectronics |  | 2 | 2 | Cut Tape (CT) | 497-15341-1-ND | 0.79000 | $1.58 | 1
98 | W25N512GVEIG | Winbond Electronics |  | 1 | 1 | Tube | 256-W25N512GVEIG-ND | 2.29000 | $2.29 | 1
99 | USB2422-I/MJ | Microchip Technology |  | 1 | 1 | Tray | USB2422-I/MJ-ND | 1.84000 | $1.84 | 1
100 | PT61018PEL | Bourns Inc. |  | 1 | 1 | Cut Tape (CT) | PT61018PELCT-ND | 1.26000 | $1.26 | 1
101 | LAN8742AI-CZ-TR | Microchip Technology |  | 1 | 1 | Cut Tape (CT) | LAN8742AI-CZ-CT-ND | 1.89000 | $1.89 | 1
102 | TPS22996HQDYCRQ1 | Texas Instruments |  | 3 | 3 | Cut Tape (CT) | 296-TPS22996HQDYCRQ1CT-ND | 0.49000 | $1.47 | 1
103 | TXS0104VQRUTRQ1 | Texas Instruments |  | 4 | 4 | Cut Tape (CT) | 296-TXS0104VQRUTRQ1CT-ND | 0.96000 | $3.84 | 1
104 | TXS0108EQWRKSRQ1 | Texas Instruments |  | 2 | 2 | Cut Tape (CT) | 296-TXS0108EQWRKSRQ1CT-ND | 1.52000 | $3.04 | 1
105 | BGA525N6E6327XTSA1 | Infineon Technologies |  | 1 | 1 | Cut Tape (CT) | 448-BGA525N6E6327XTSA1CT-ND | 0.53000 | $0.53 | 1
106 | QCN-19D+ | Mini-Circuits |  | 1 | 1 | Cut Tape (CT) | 3157-QCN-19D+CT-ND | 7.95000 | $7.95 | 1
107 | TXS0102QDCURQ1 | Texas Instruments |  | 1 | 1 | Cut Tape (CT) | 296-37938-1-ND | 0.89000 | $0.89 | 1
108 | SHT41A-AD1B-R3 | Sensirion AG |  | 1 | 1 | Cut Tape (CT) | 1649-SHT41A-AD1B-R3CT-ND | 3.13000 | $3.13 | 1
109 | STM32L433CCU6 | STMicroelectronics |  | 1 | 1 | Tray | 497-16580-ND | 4.26000 | $4.26 | 1
110 | BQ25798RQMR | Texas Instruments |  | 1 | 1 | Cut Tape (CT) | 296-BQ25798RQMRCT-ND | 5.02000 | $5.02 | 1
111 | BQ76905RGRR | Texas Instruments |  | 1 | 1 | Cut Tape (CT) | 296-BQ76905RGRRCT-ND | 1.72000 | $1.72 | 1
112 | LM61480Q3RPHRQ1 | Texas Instruments |  | 1 | 1 | Cut Tape (CT) | 296-LM61480Q3RPHRQ1CT-ND | 5.89000 | $5.89 | 1
113 | TPS62A01DRLR | Texas Instruments |  | 1 | 1 | Cut Tape (CT) | 296-TPS62A01DRLRCT-ND | 0.16000 | $0.16 | 1
114 | TPS7A1601AQDGNRQ1 | Texas Instruments |  | 1 | 1 | Cut Tape (CT) | 296-TPS7A1601AQDGNRQ1CT-ND | 3.25000 | $3.25 | 1
115 | ECS-2016MVQ-250-CN-TR | ECS Inc. |  | 1 | 1 | Cut Tape (CT) | 50-ECS-2016MVQ-250-CN-CT-ND | 1.67000 | $1.67 | 1
116 | ECS-327ATQ2016MV-BS-TR | ECS Inc. |  | 1 | 1 | Cut Tape (CT) | 50-ECS-327ATQ2016MV-BS-TRCT-ND | 1.47000 | $1.47 | 1
117 | ECS-2016MVQ-240-BS-TR | ECS Inc. |  | 1 | 1 | Cut Tape (CT) | 50-ECS-2016MVQ-240-BS-TRCT-ND | 1.69000 | $1.69 | 1
118 | T9602-3-D-1 | Amphenol Advanced Sensors (Telaire) |  | 1 | 1 | Bulk | 235-1377-ND | 48.25000 | $48.25 | 1
