DeepSpace00/Awohali/hardware/mechanical/cables/power-cable/8AP-02AMMM-SL7AXX-STP.stp

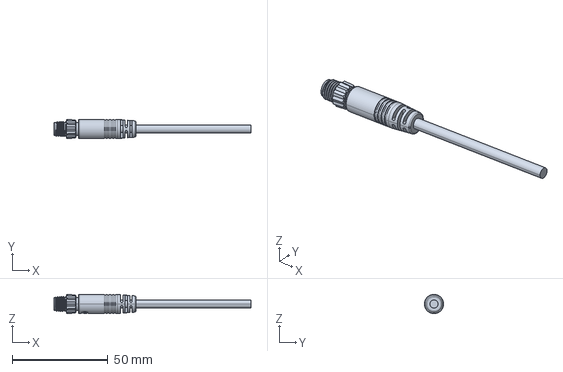
[picture p7: CAD file, 2025-02-05]
hardware/mechanical/cables/power-cable/8AP-02AMMM-SL7AXX-STP.stp
102.7 x 10.0 x 10.0 mm
