DeepSpace00/Awohali/hardware/mechanical/cables/sensor-cable/8P-04AMMM-SL7AXX-STP.stp

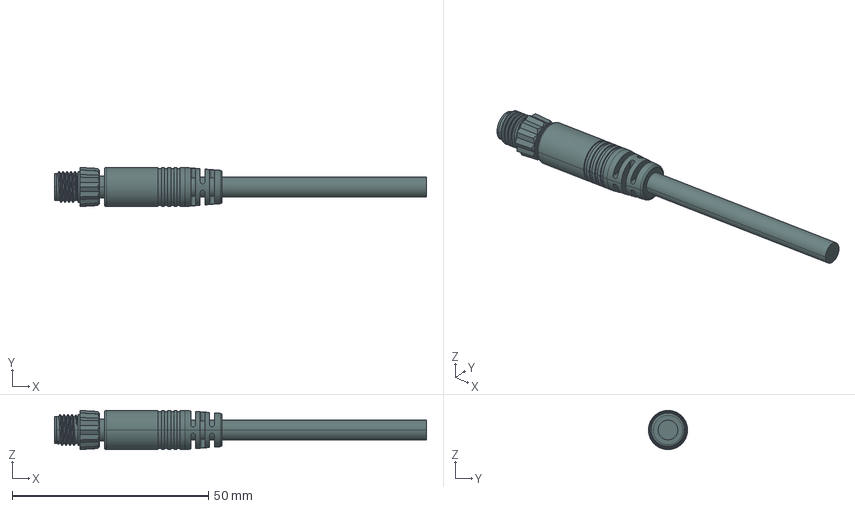
[picture p8: CAD file, 2025-02-05]
hardware/mechanical/cables/sensor-cable/8P-04AMMM-SL7AXX-STP.stp
94.7 x 10.0 x 10.0 mm
MSBR-8
MSBR-7
MSBR-6
MSBR-5
MSBR-4
MSBR-3
MSBR-2
MSBR-1
