DeepSpace00/Awohali/hardware/mechanical/enclosure/endCapHoodClamp-Body.3mf

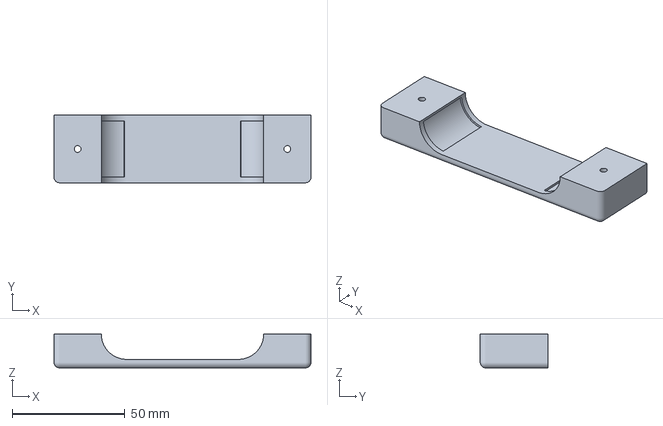
[picture p9: CAD file, 2025-11-13]
hardware/mechanical/enclosure/endCapHoodClamp-Body.3mf
114.0 x 30.0 x 15.0 mm
