DeepSpace00/Awohali/hardware/mechanical/full_integration/backPanel.step

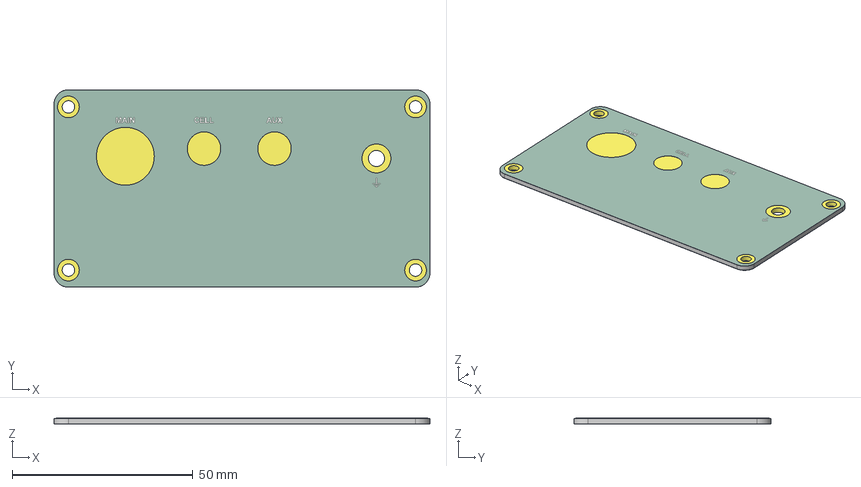
[picture p10: CAD file, 2025-11-13]
hardware/mechanical/full_integration/backPanel.step
104.0 x 54.6 x 1.64 mm
backPanel_copper
backPanel_silkscreen
backPanel_soldermask
backPanel_PCB
