DeepSpace00/Awohali/hardware/mechanical/lps28Mount/LPS28_breakoutBoard_Mount.FCStd

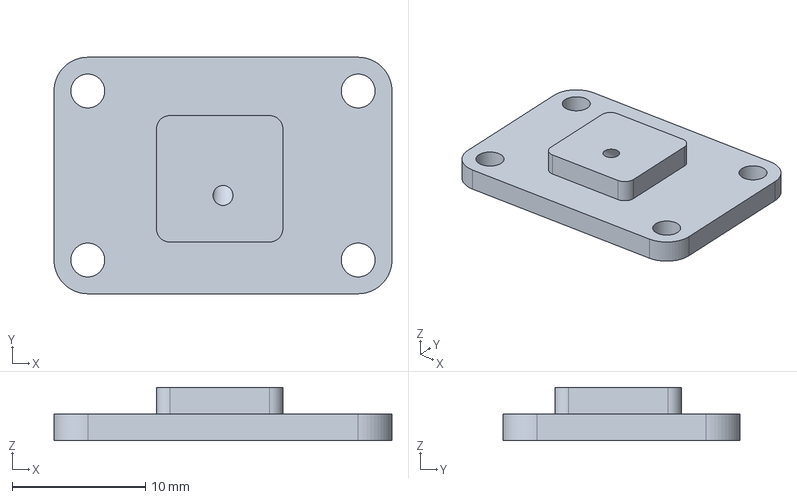
[picture p11: CAD file, 2025-11-21]
hardware/mechanical/lps28Mount/LPS28_breakoutBoard_Mount.FCStd
25.4 x 17.8 x 4.00 mm
