DeepSpace00/Awohali/hardware/mechanical/tripod/post_bushing.FCStd

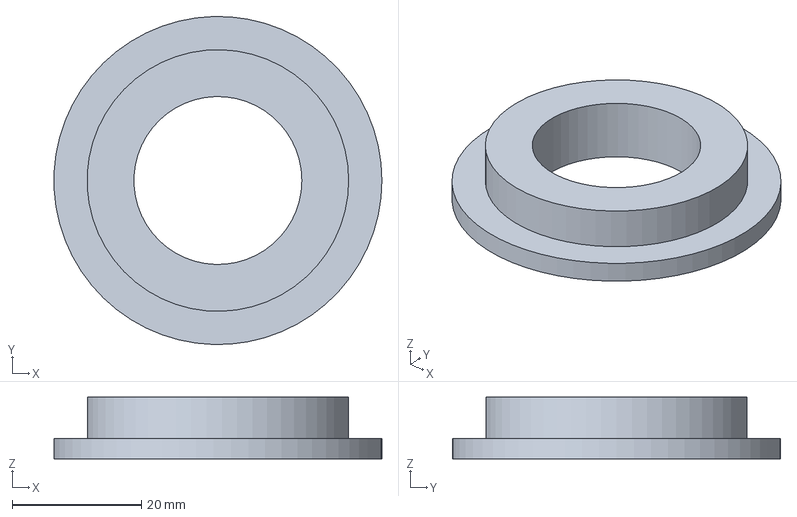
[picture p12: CAD file, 2025-11-13]
hardware/mechanical/tripod/post_bushing.FCStd
50.8 x 50.8 x 9.53 mm
