DeepSpace00/Awohali/hardware/mechanical/battery/battery.FCStd

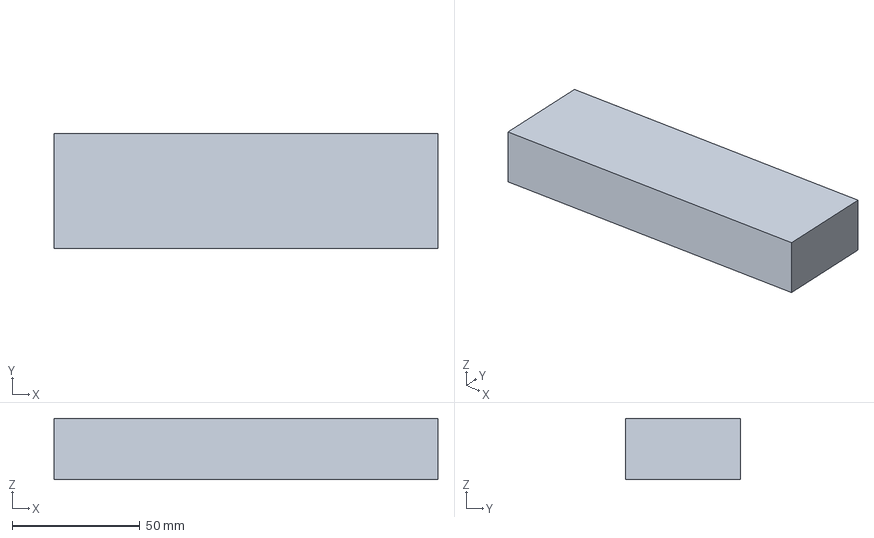
[picture p13: CAD file, 2025-04-21]
hardware/mechanical/battery/battery.FCStd
150.0 x 45.0 x 24.0 mm
