DeepSpace00/Awohali/hardware/mechanical/enclosure/lteAntennaMount.FCStd

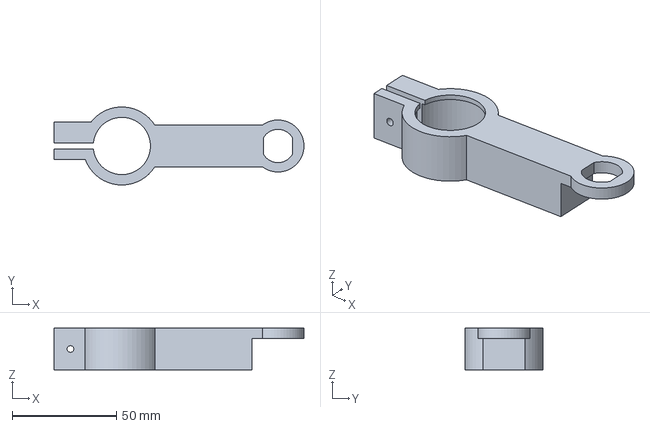
[picture p14: CAD file, 2025-11-13]
hardware/mechanical/enclosure/lteAntennaMount.FCStd
120.1 x 37.5 x 20.0 mm
