DeepSpace00/Awohali/hardware/mechanical/full_integration/frontPanel.step

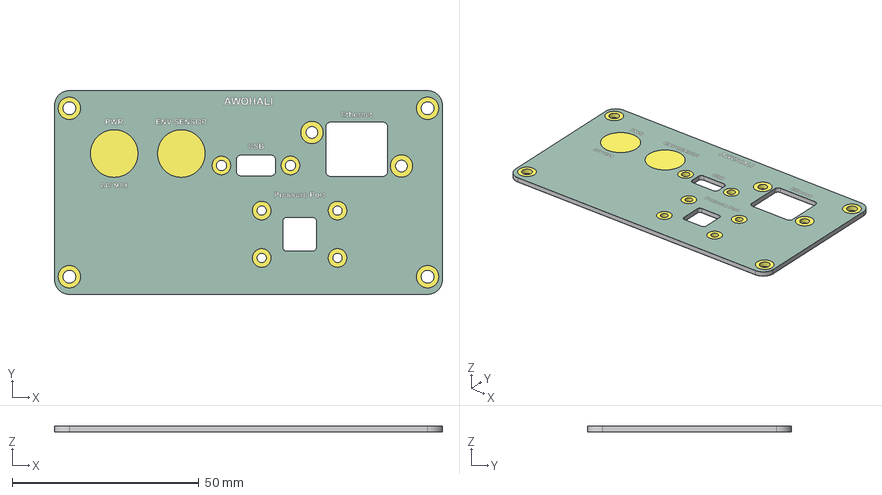
[picture p15: CAD file, 2025-11-13]
hardware/mechanical/full_integration/frontPanel.step
104.0 x 54.6 x 1.64 mm
frontPanel_copper
frontPanel_silkscreen
frontPanel_soldermask
frontPanel_PCB
