DeepSpace00/Awohali/hardware/mechanical/enclosure/Awohali_End_Caps.3mf

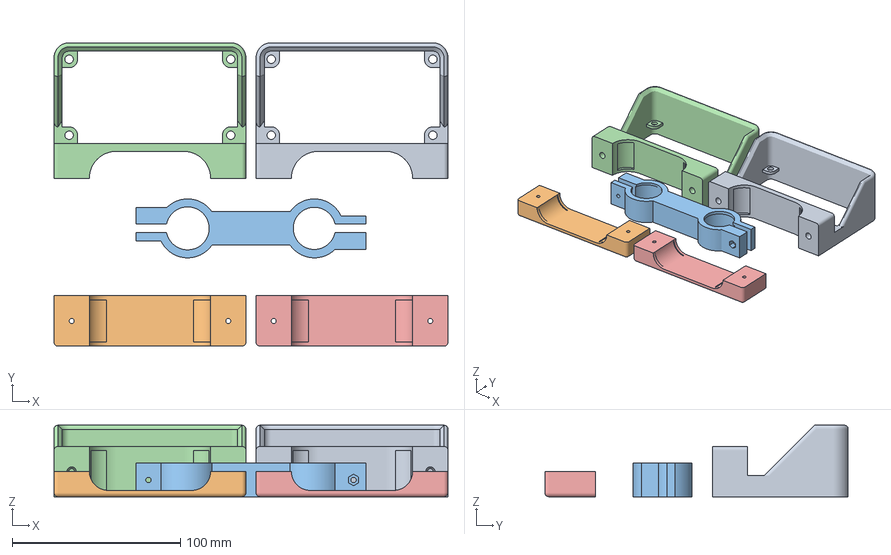
[picture p16: CAD file, 2025-11-13]
hardware/mechanical/enclosure/Awohali_End_Caps.3mf
234.0 x 180.2 x 42.5 mm
endCapHood-Body x 2
endCapHoodClamp-Body x 2
lteAntennaMount-Body
