DeepSpace00/Awohali/hardware/mechanical/full_integration/lps28dfwBreakoutBoard.step

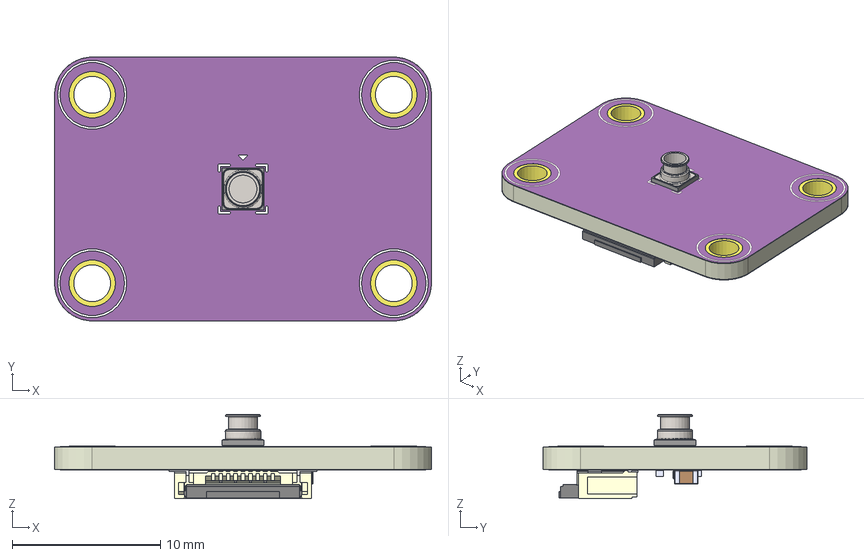
[picture p17: CAD file, 2025-11-13]
hardware/mechanical/full_integration/lps28dfwBreakoutBoard.step
25.4 x 17.8 x 5.67 mm
LPS28DFW
CRCW0402 x 3
GRT188R71E105KE13D
GRT155R71H104KE01D
lps28dfwBreakoutBoard_copper
lps28dfwBreakoutBoard_silkscreen
lps28dfwBreakoutBoard_soldermask
lps28dfwBreakoutBoard_PCB
