DeepSpace00/Awohali/hardware/mechanical/lps28Mount/lps28_breakoutBoard.FCStd

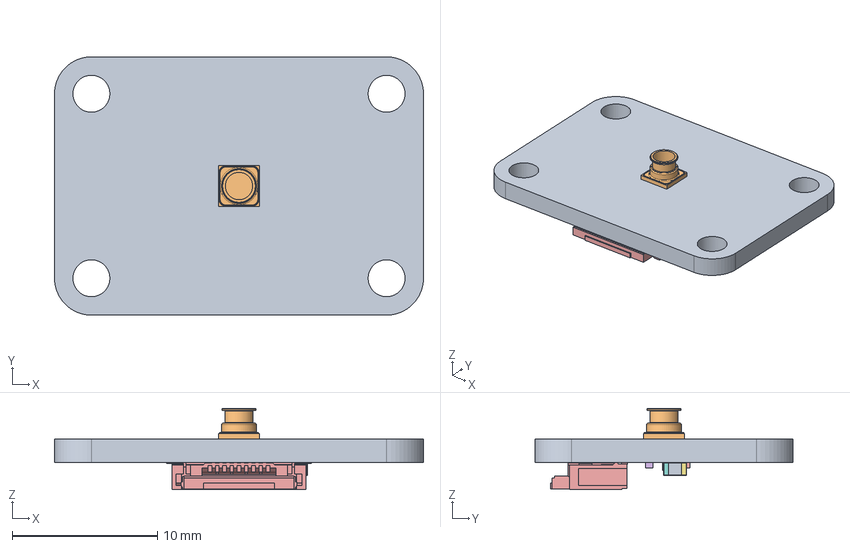
[picture p18: CAD file, 2025-05-14]
hardware/mechanical/lps28Mount/lps28_breakoutBoard.FCStd
25.4 x 17.8 x 5.60 mm
Pcb_1557
U1_LPS28DFW_293fee886f45
CRCW04020000Z0ED x 3
CRCW04020000Z0ED001 x 3
CRCW04020000Z0ED002 x 3
CRCW04020000Z0ED003 x 3
GRM_Auto_Q3_1.6_0.8_0.9_0.35
GRM_Auto_Q3_1.6_0.8_0.9_0.036
GRM_Auto_Q3_1.6_0.8_0.9_0.037
UVK105CH0R9BW-F
UVK105CH0R9BW-F001
UVK105CH0R9BW-F002
J1_2005280040_f94c95c36937
