DeepSpace00/Awohali/hardware/mechanical/enclosure/endCapHood-Body.3mf

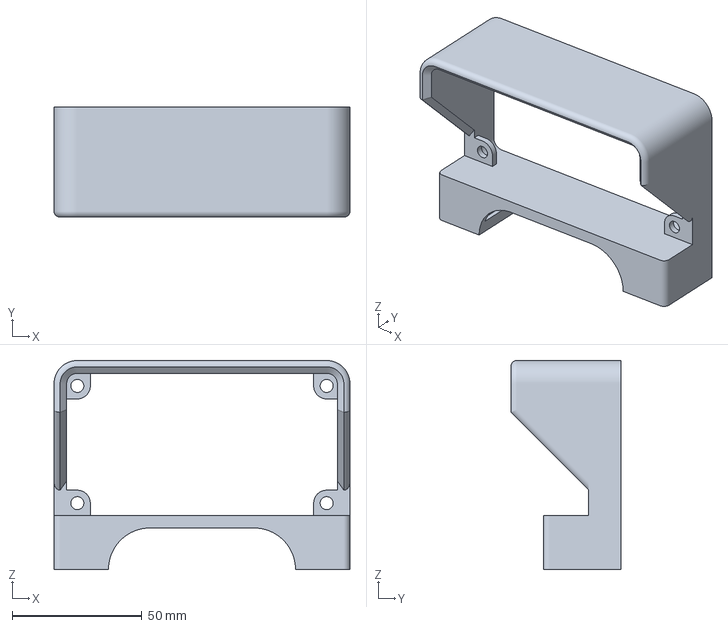
[picture p19: CAD file, 2025-11-13]
hardware/mechanical/enclosure/endCapHood-Body.3mf
114.0 x 42.5 x 80.5 mm
