DeepSpace00/Awohali/hardware/mechanical/full_integration/enclosure.FCStd

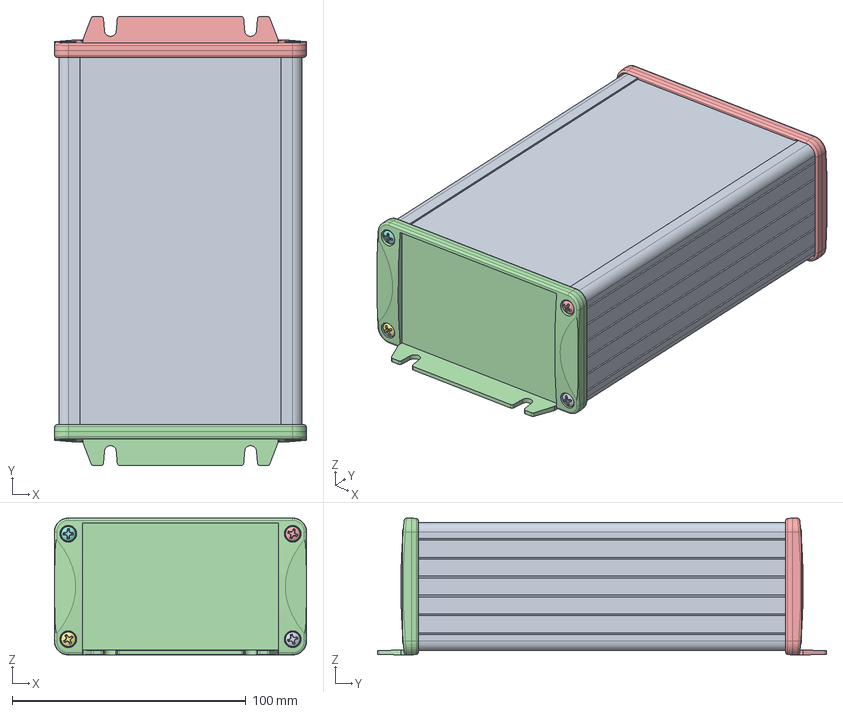
[picture p20: CAD file, 2025-05-14]
hardware/mechanical/full_integration/enclosure.FCStd
108.0 x 192.1 x 58.6 mm
160mm N Extrusion
Gasket
Gasket001
N End PNLFL
N End PNLFL001
O-ring
O-ring001
O-ring002
O-ring003
O-ring004
O-ring005
O-ring006
O-ring007
6-32 PH x .5 Screw
6-32 PH x .5 Screw001
6-32 PH x .5 Screw002
6-32 PH x .5 Screw003
6-32 PH x .5 Screw004
6-32 PH x .5 Screw005
6-32 PH x .5 Screw006
6-32 PH x .5 Screw007
