DeepSpace00/Awohali/hardware/mechanical/enclosure/endCapHood.FCStd

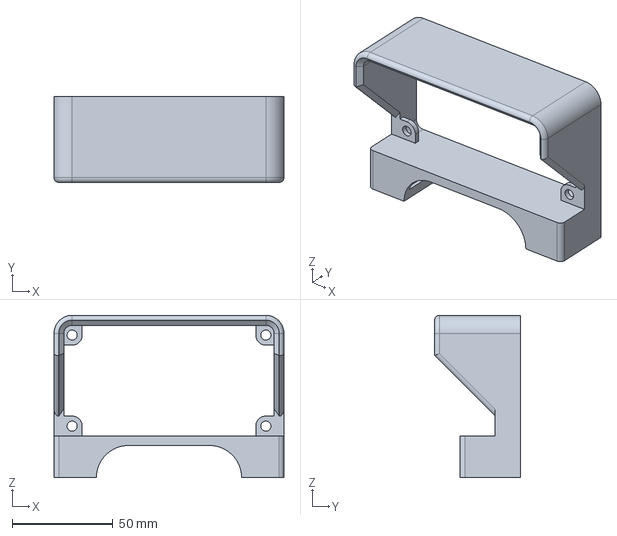
[picture p21: CAD file, 2025-07-21]
hardware/mechanical/enclosure/endCapHood.FCStd
114.0 x 42.5 x 80.5 mm
