DeepSpace00/Awohali/hardware/mechanical/enclosure/tripodFootCover.FCStd

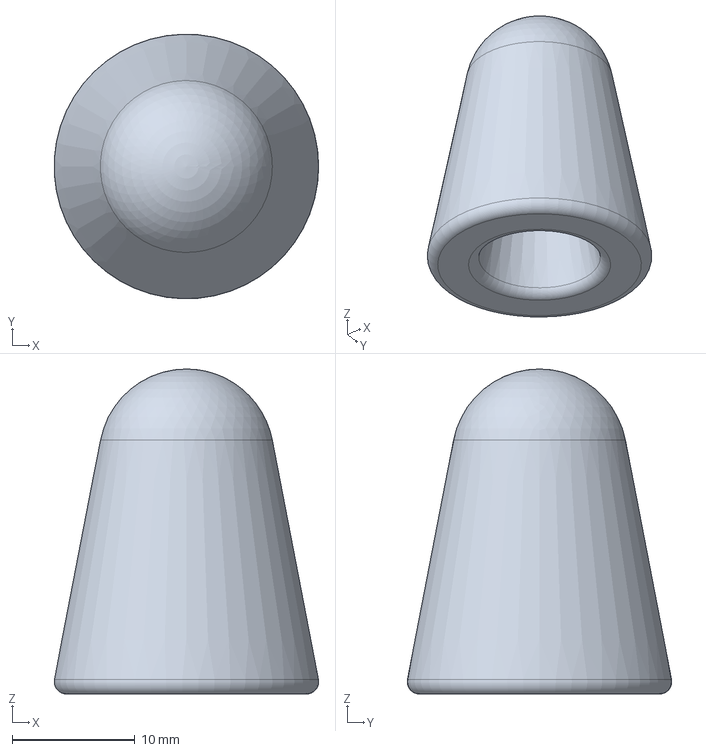
[picture p22: CAD file, 2025-05-31]
hardware/mechanical/enclosure/tripodFootCover.FCStd
21.6 x 21.6 x 26.5 mm
