DeepSpace00/Awohali/hardware/mechanical/enclosure/7793.STEP

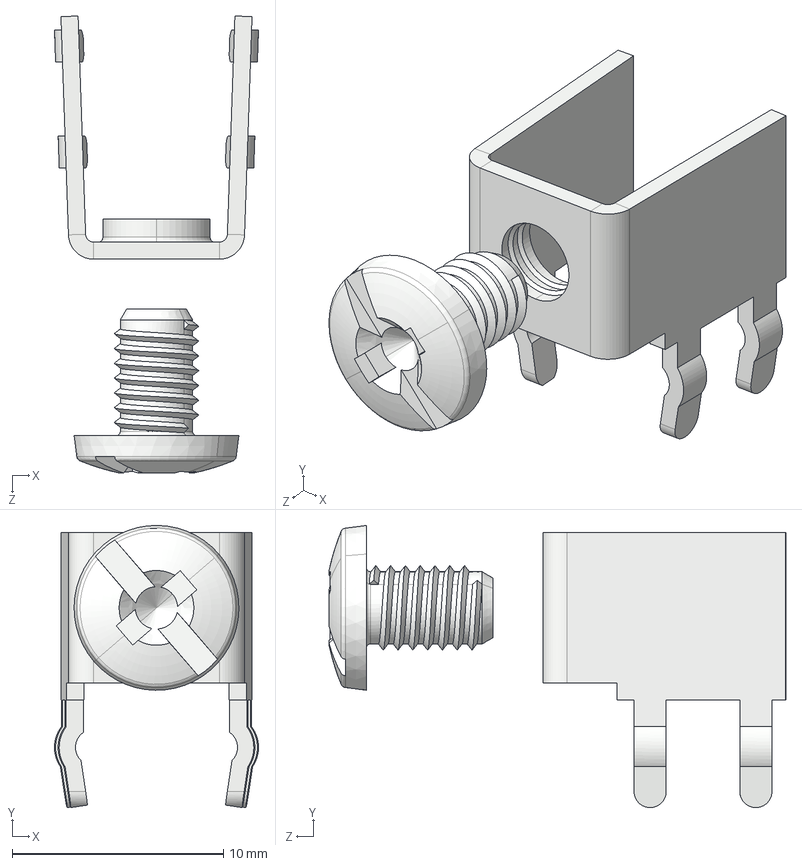
[picture p23: CAD file, 2025-05-14]
hardware/mechanical/enclosure/7793.STEP
9.66 x 13.3 x 21.6 mm
