DeepSpace00/Awohali/(list of files, cad)

Other CAD files:
hardware/mechanical/lps28Mount/LPS28_assembly.FCStd
hardware/mechanical/enclosure/endCapHoodClamp.FCStd
hardware/mechanical/enclosure/1457N1602.STEP
hardware/mechanical/enclosure/endCapHood.3mf
hardware/mechanical/enclosure/endCapHoodClamp.3mf
hardware/mechanical/enclosure/lteAntennaMount.3mf
hardware/mechanical/enclosure/tripodFootCover.3mf
hardware/mechanical/full_integration/backPanel.FCStd
hardware/mechanical/full_integration/frontPanel.FCStd
hardware/mechanical/lps28Mount/LPS28_breakoutBoard_Mount.3mf
hardware/mechanical/lps28Mount/LPS28_breakoutBoard_Mount.stl
hardware/mechanical/tripod/post_bushing.3mf
hardware/mechanical/tripod/post_bushing.stl
