DeepSpace00/Awohali/docs/firmware/firmware_setup.rst

.. _firmware_setup:

Firmware Setup

- Open the venv

- cd firmware 

- west build -b arduino_portenta_h7/stm32h747xx/m7 zephyr/samples/hello_world/

- west flash
