DeepSpace00/Awohali/firmware/tests/stm32l433/CLion_note.md

Copy ```-DCMAKE_TOOLCHAIN_FILE=./cmake/gcc-arm-none-eabi.cmake``` to CMake profile options field.
