DeepSpace00/Awohali/(threads)

Thread 12 (2025-09-22):

GNSS receiver sleep states

DeepSpace00, 2025-09-22:
Modify GNSS datalogging code to allow the receiver to go into hot or cold standby states to save power when not recording data. Make sure GNSS re-fixes before recording new data (via PPS pin).

Thread 4 (2025-09-22):

Compare EVM schematics to Awohali schematics to see why the BQ25798 won't charge

DeepSpace00, 2025-09-22:
The BQ25798 on the mainboard thinks it is charging the battery, but no current is flowing. Compare schematics to see if anything is different. Also, V_SYS bypass from VIN does not have any current, so the voltage tanks. Initial testing with the EVM indicates that VIN should be able to bypass the battery and support V_SYS. If can get working, testing will become much easier and will not require tethering to bench power supply.
