DeepSpace00/Awohali/hardware/mechanical/enclosure/Hammond-Manufacturing-1457N1602.pdf

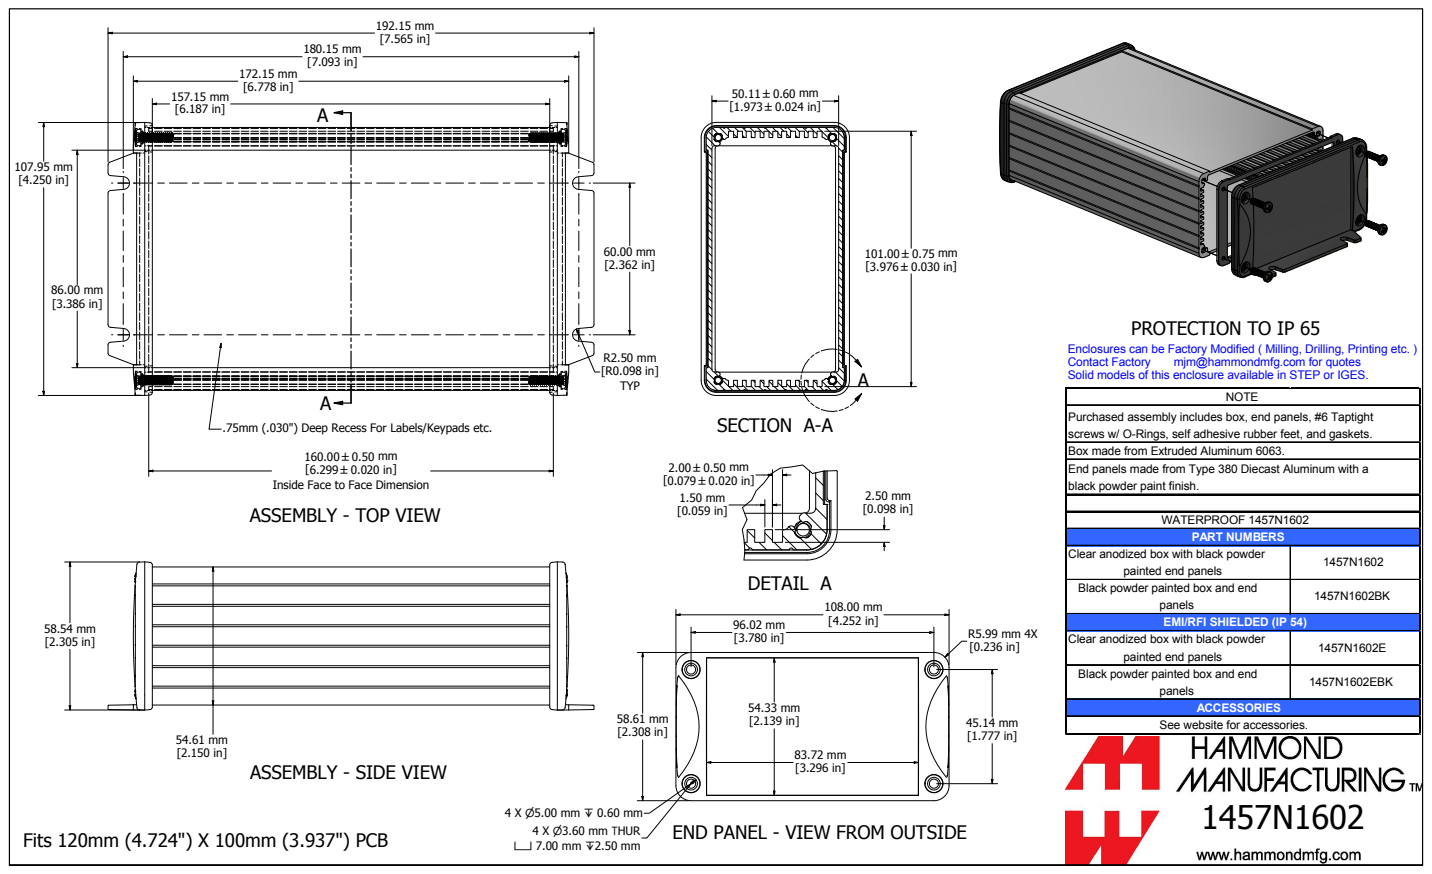
[picture p24: page 1]
WATERPROOF 1457N1602; PART NUMBERS; SECTION A-A; DETAIL A; Contact Factory; mjm@hammondmfg.com for quotes; Fits 120mm (4.724") X 100mm (3.937") PCB

PROTECTION TO IP 65

Enclosures can be Factory Modified ( Milling, Drilling, Printing etc. )
Solid models of this enclosure available in STEP or IGES.

Purchased assembly includes box, end panels, #6 Taptight
screws w/ O-Rings, self adhesive rubber feet, and gaskets.
Box made from Extruded Aluminum 6063.
End panels made from Type 380 Diecast Aluminum with a
black powder paint finish.

.75mm (.030") Deep Recess For Labels/Keypads etc.

Inside Face to Face Dimension
ASSEMBLY - TOP VIEW

Clear anodized box with black powder painted end panels | 1457N1602

Black powder painted box and end panels | 1457N1602BK

EMI/RFI SHIELDED (IP 54)

Clear anodized box with black powder painted end panels | 1457N1602E

Black powder painted box and end panels | 1457N1602EBK

See website for accessories.

ASSEMBLY - SIDE VIEW

END PANEL - VIEW FROM OUTSIDE
