DeepSpace00/Awohali/hardware/mechanical/cables/lte-cable/Amphenol-095-902-505-XXX.pdf

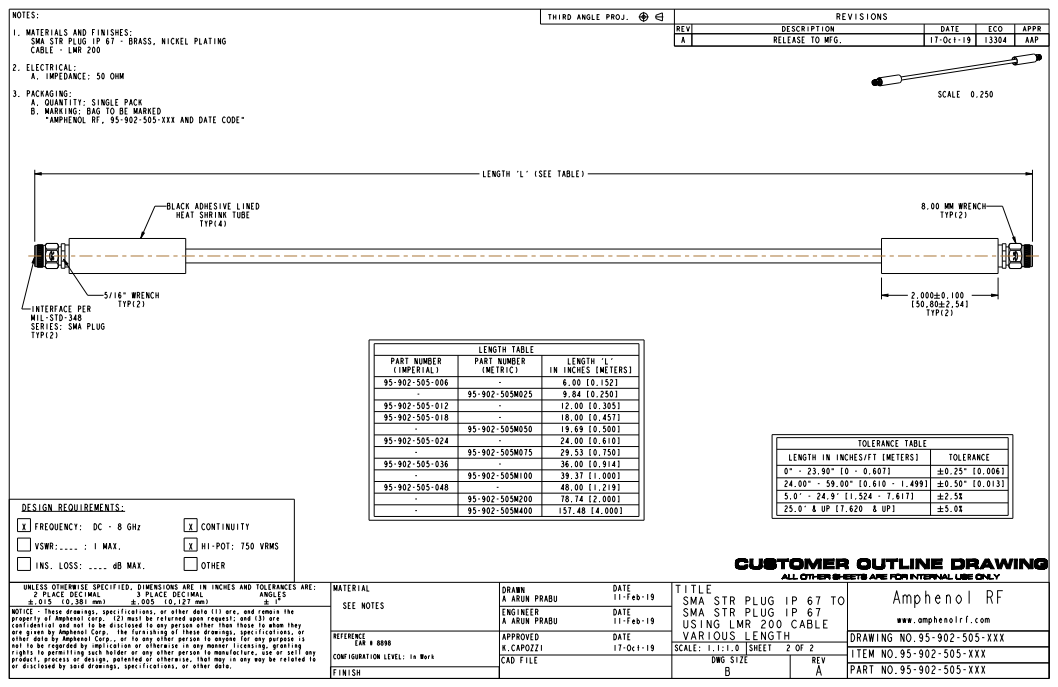
[picture p26: page 1]
REV; DESCRIPTION; DATE; REVISIONS; ECO; APPR; CAD FILE; DWG SIZE; UNLESS OTHERWISE SPECIFIED, DIMENSIO NS ARE IN; INCHES AND TOLERANCES ARE:; 2 PLACE DECIMAL; 3 PLACE DECIMAL; ANGLES; LENGTH; 'L' (SEE TABLE); TYP(2); INS. LOSS: ____ dB MAX.; OTHER; VSWR:____ : 1; MAX.; X HI-POT: 750 VRMS; X FREQUENCY: DC - 8 GHz; X CONTINUITY; DESIGN REQUIREMENTS:; RELEASE TO MFG.; 17-Oct-19 13304; AAP; NOTICE; - These drawings, specifications, or other data; are, and remain the; property of Amphenol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

NOTES:
1. MATERIALS AND FINISHES:
SMA STR PLUG IP 67 - BRASS, NICKEL PLATING
CABLE - LMR 200
2. ELECTRICAL:
A. IMPEDANCE: 50 OHM
3. PACKAGING:
A. QUANTITY: SINGLE PACK
B. MARKING: BAG TO BE MARKED
"AMPHENOL RF, 95-902-505-XXX AND DATE CODE"

THIRD ANGLE PROJ.

BLACK ADHESIVE LINED
HEAT SHRINK TUBE
TYP(4)

INTERFACE PER
MIL-STD-348
SERIES: SMA PLUG
TYP(2)

LENGTH 'L'
IN INCHES [METERS]

CUSTOMER OUTLINE DRAWING

ALL OTHER SHEETS ARE FOR INTERNAL USE ONLY

TITLE
SMA STR PLUG IP 67 TO
SMA STR PLUG IP 67
USING LMR 200 CABLE

www.amphenolrf.com
DRAWING NO. 95-902-505-XXX
ITEM NO.95-902-505-XXX
PART NO.95-902-505-XXX

REFERENCE
EAR # 8898
CONFIGURATION LEVEL: In Work
FINISH
