DeepSpace00/Awohali/hardware/mechanical/cables/power-cable/Amphenol-8AP-02AMMM-SL7A01.pdf

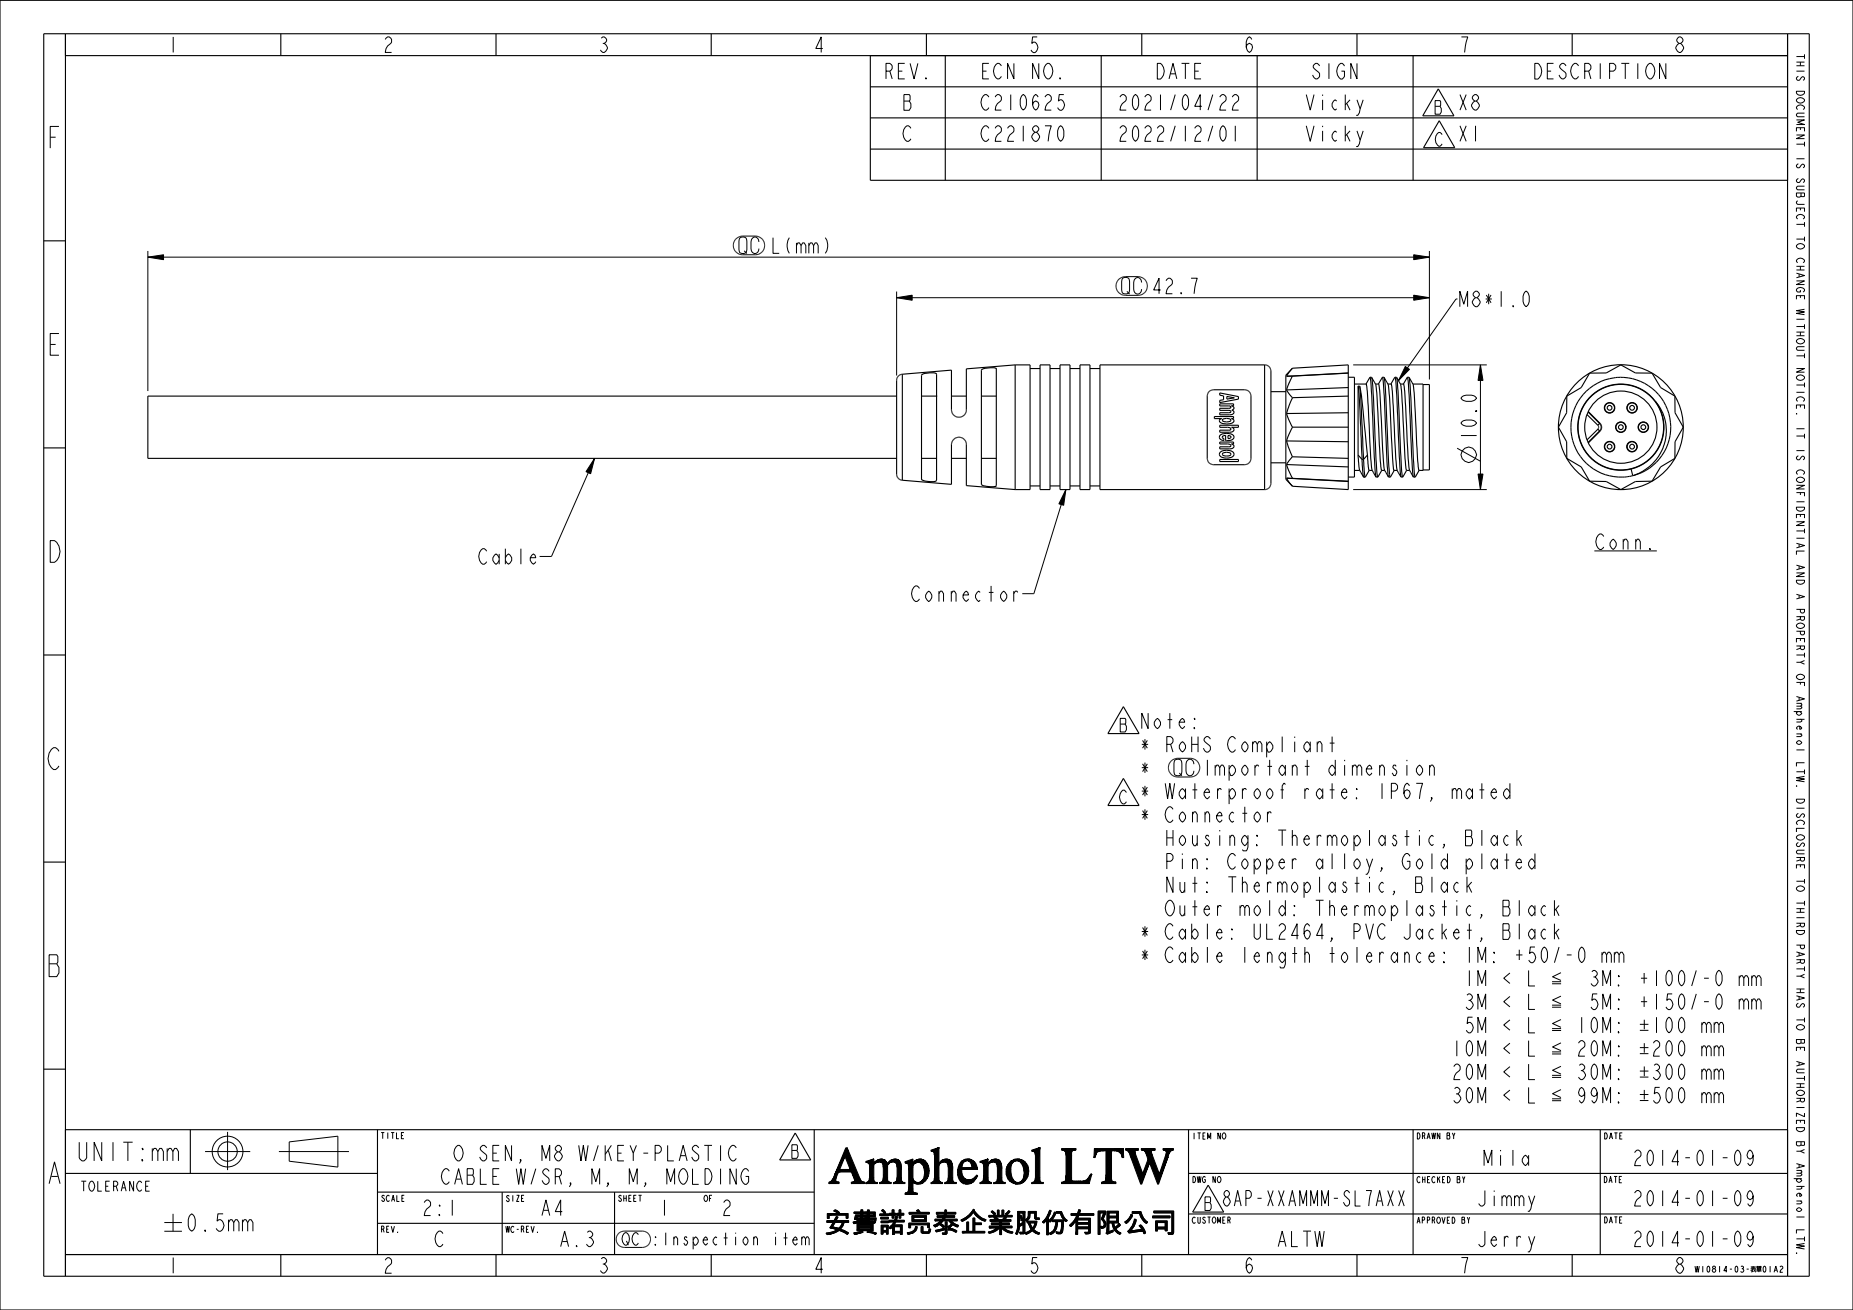
[picture p27: page 1]

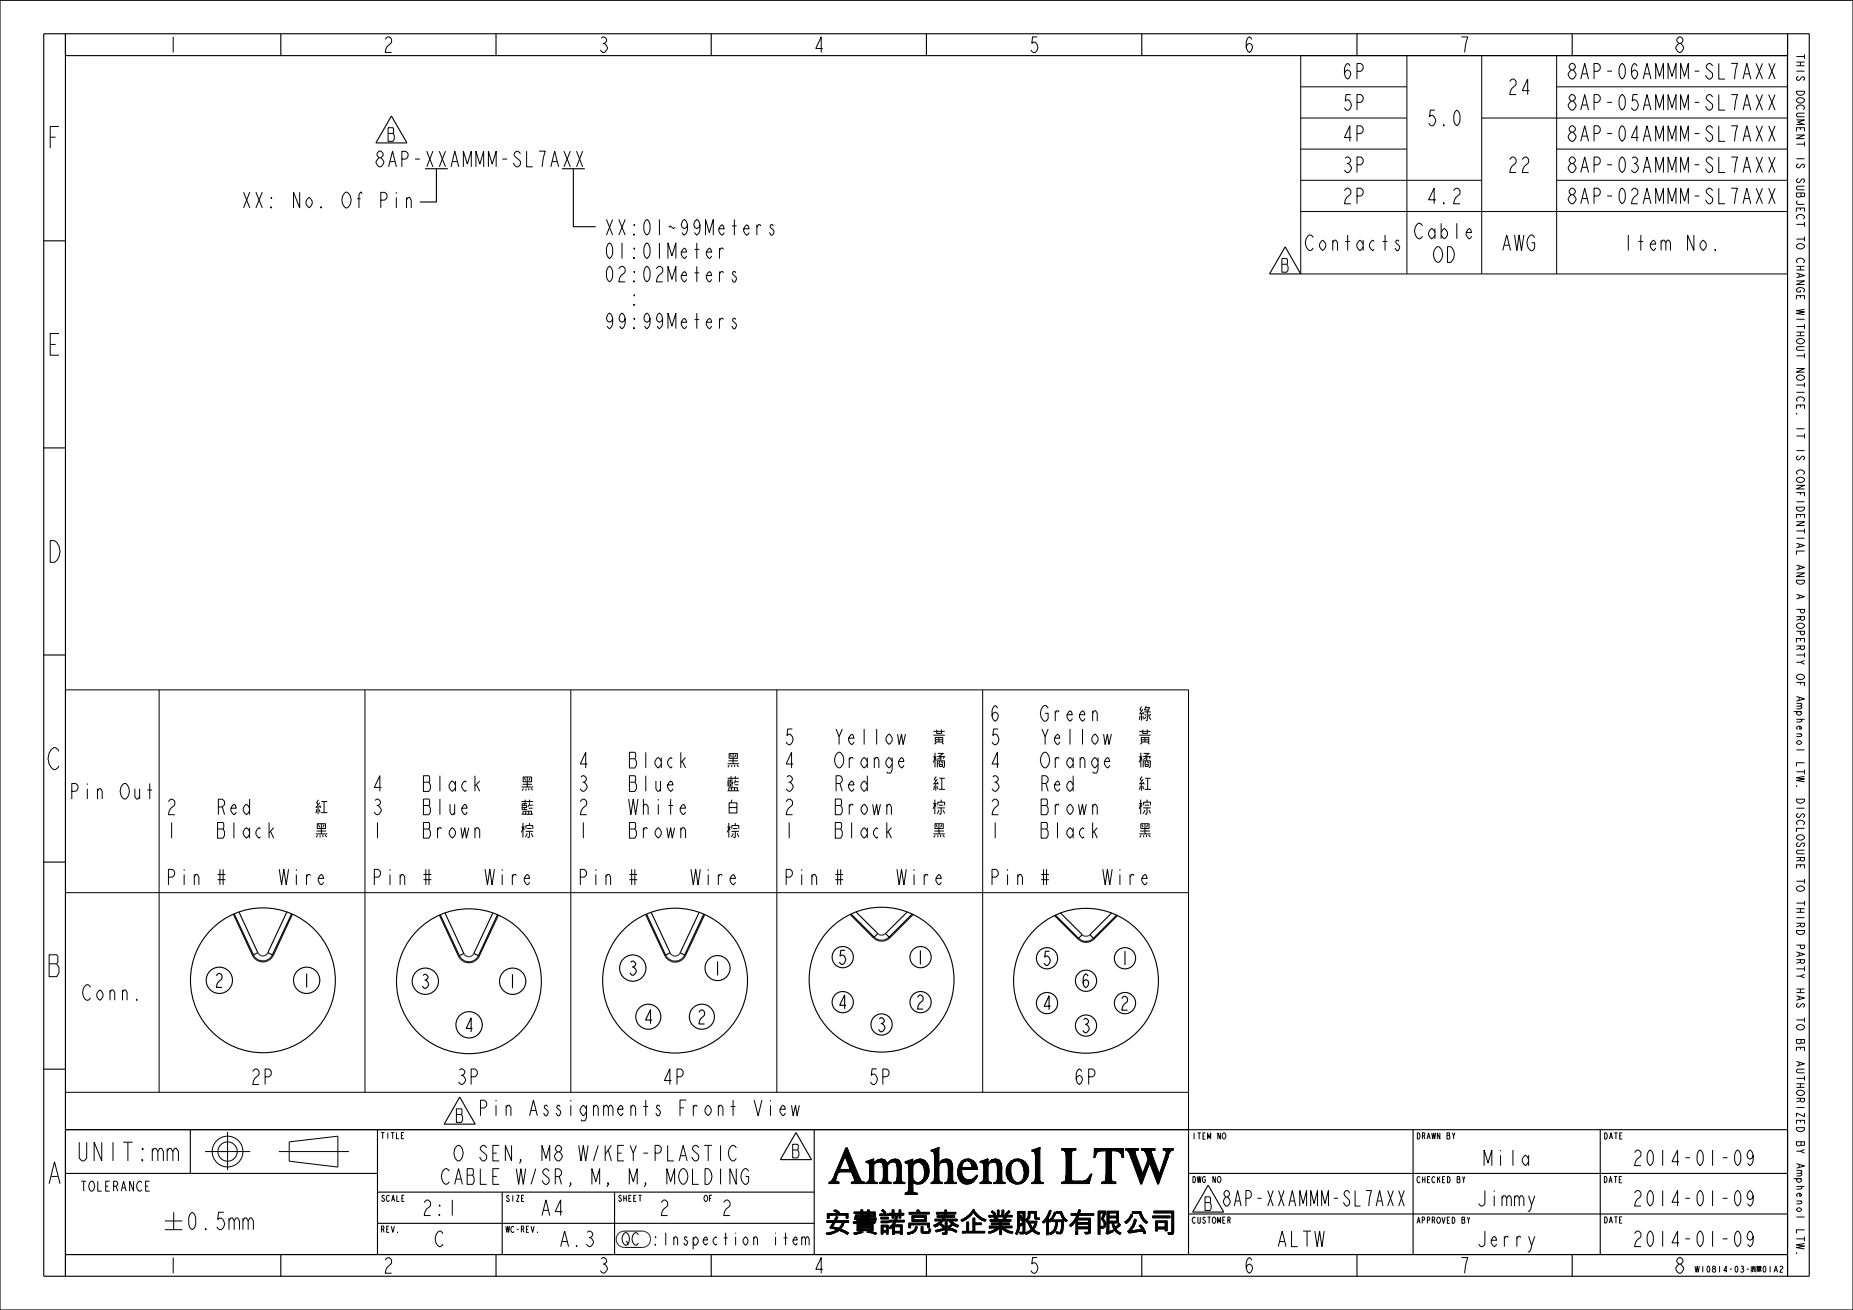
[picture p28: page 2]
