DeepSpace00/Awohali/hardware/mechanical/cables/sensor-cable/Amphenol-8P-04AMMM-SL7A01.pdf

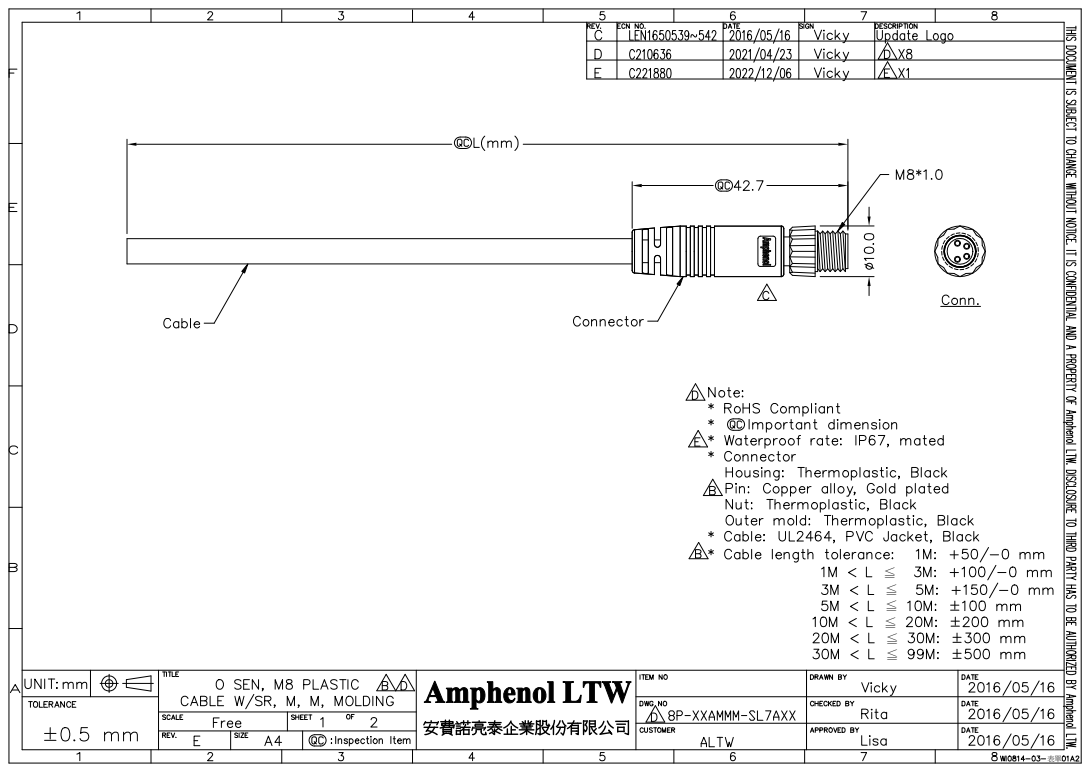
[picture p29: page 1]

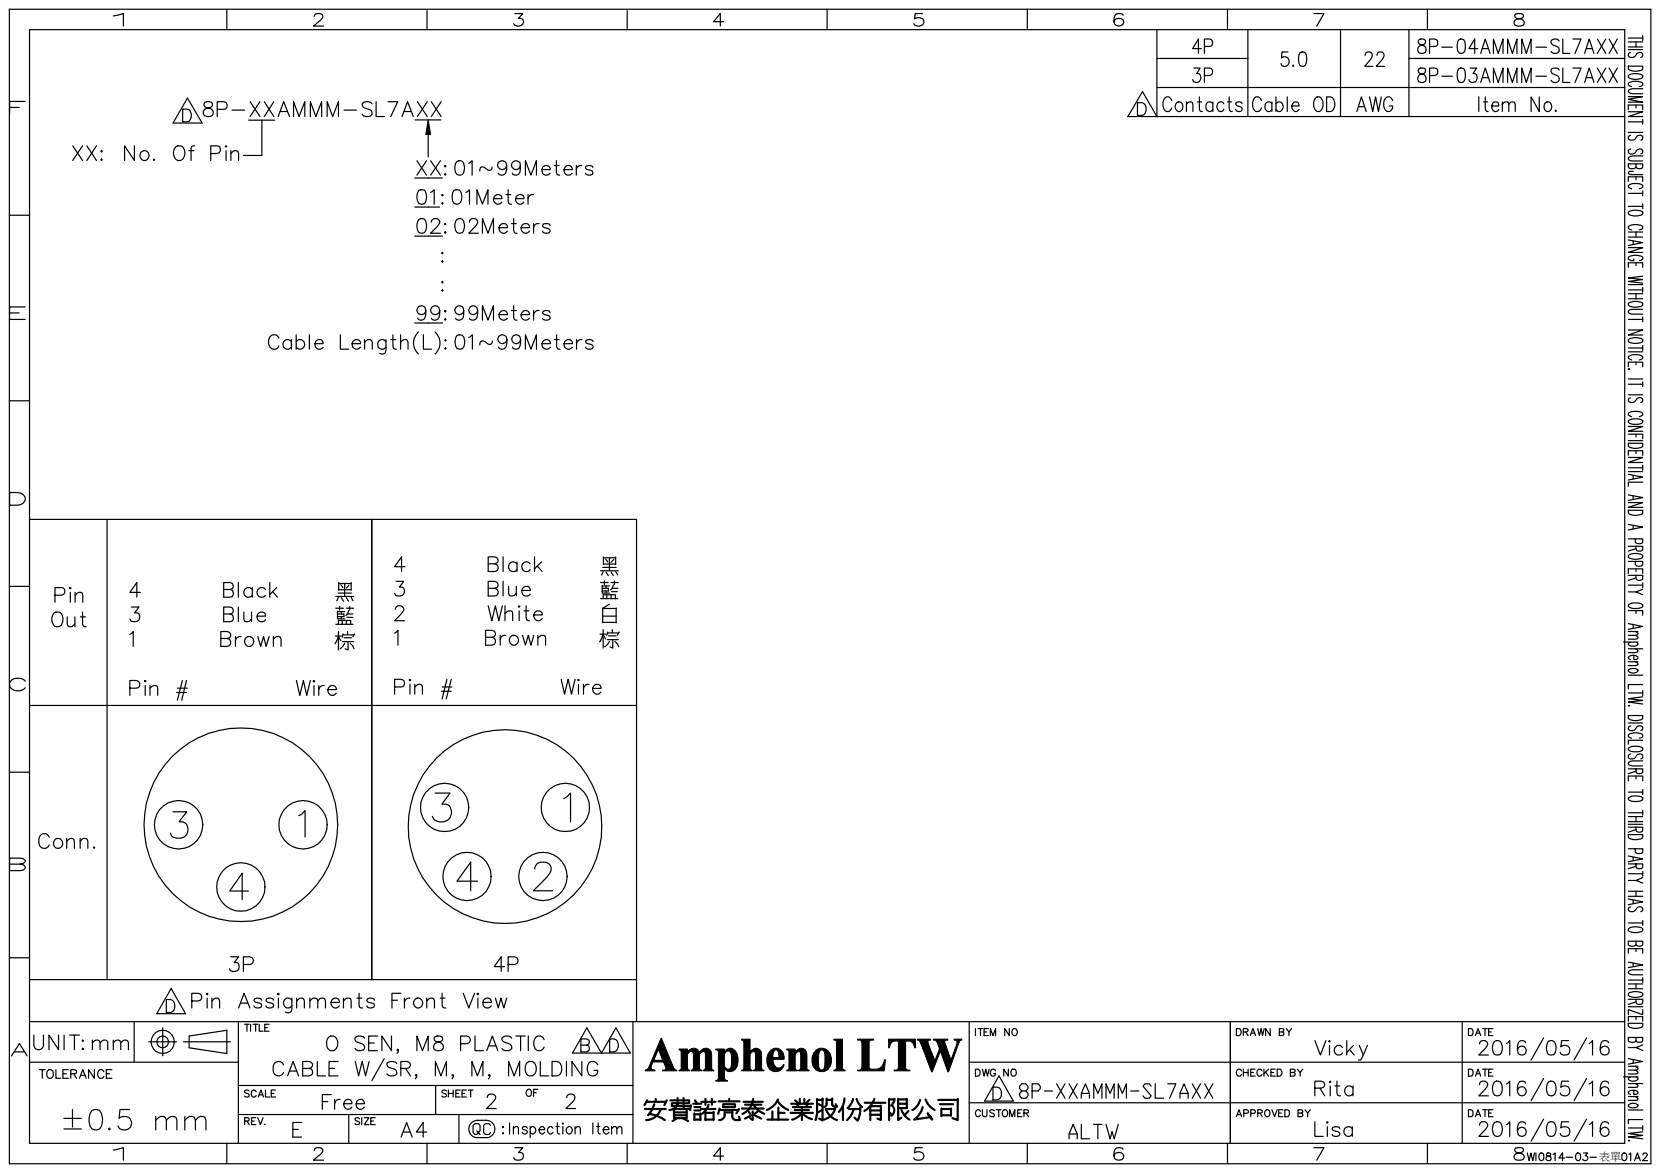
[picture p30: page 2]
