DeepSpace00/Awohali/hardware/mechanical/cables/sensor-cable/Amphenol-M8AS-02PFFR-SF8001.pdf

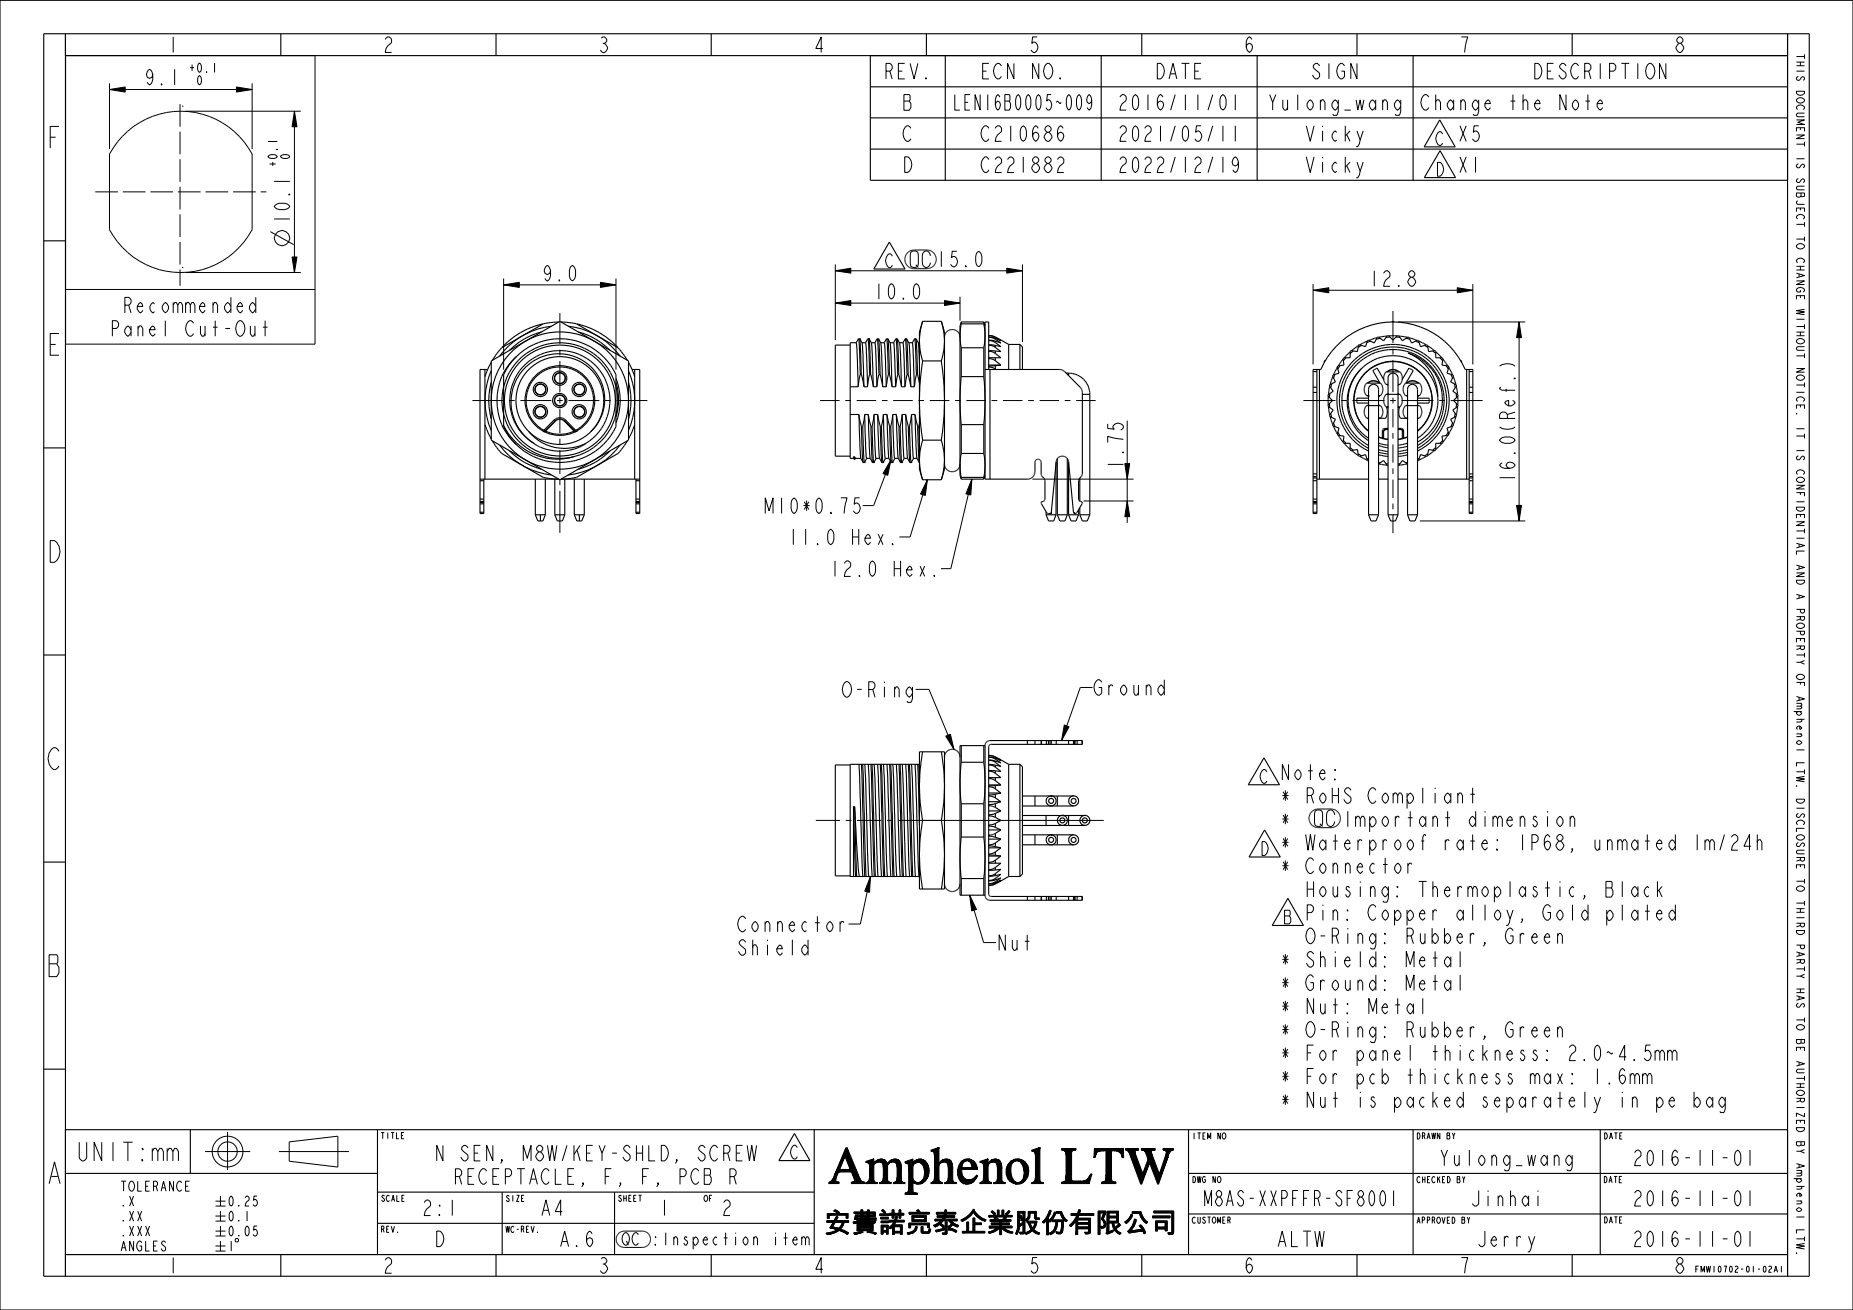
[picture p31: page 1]

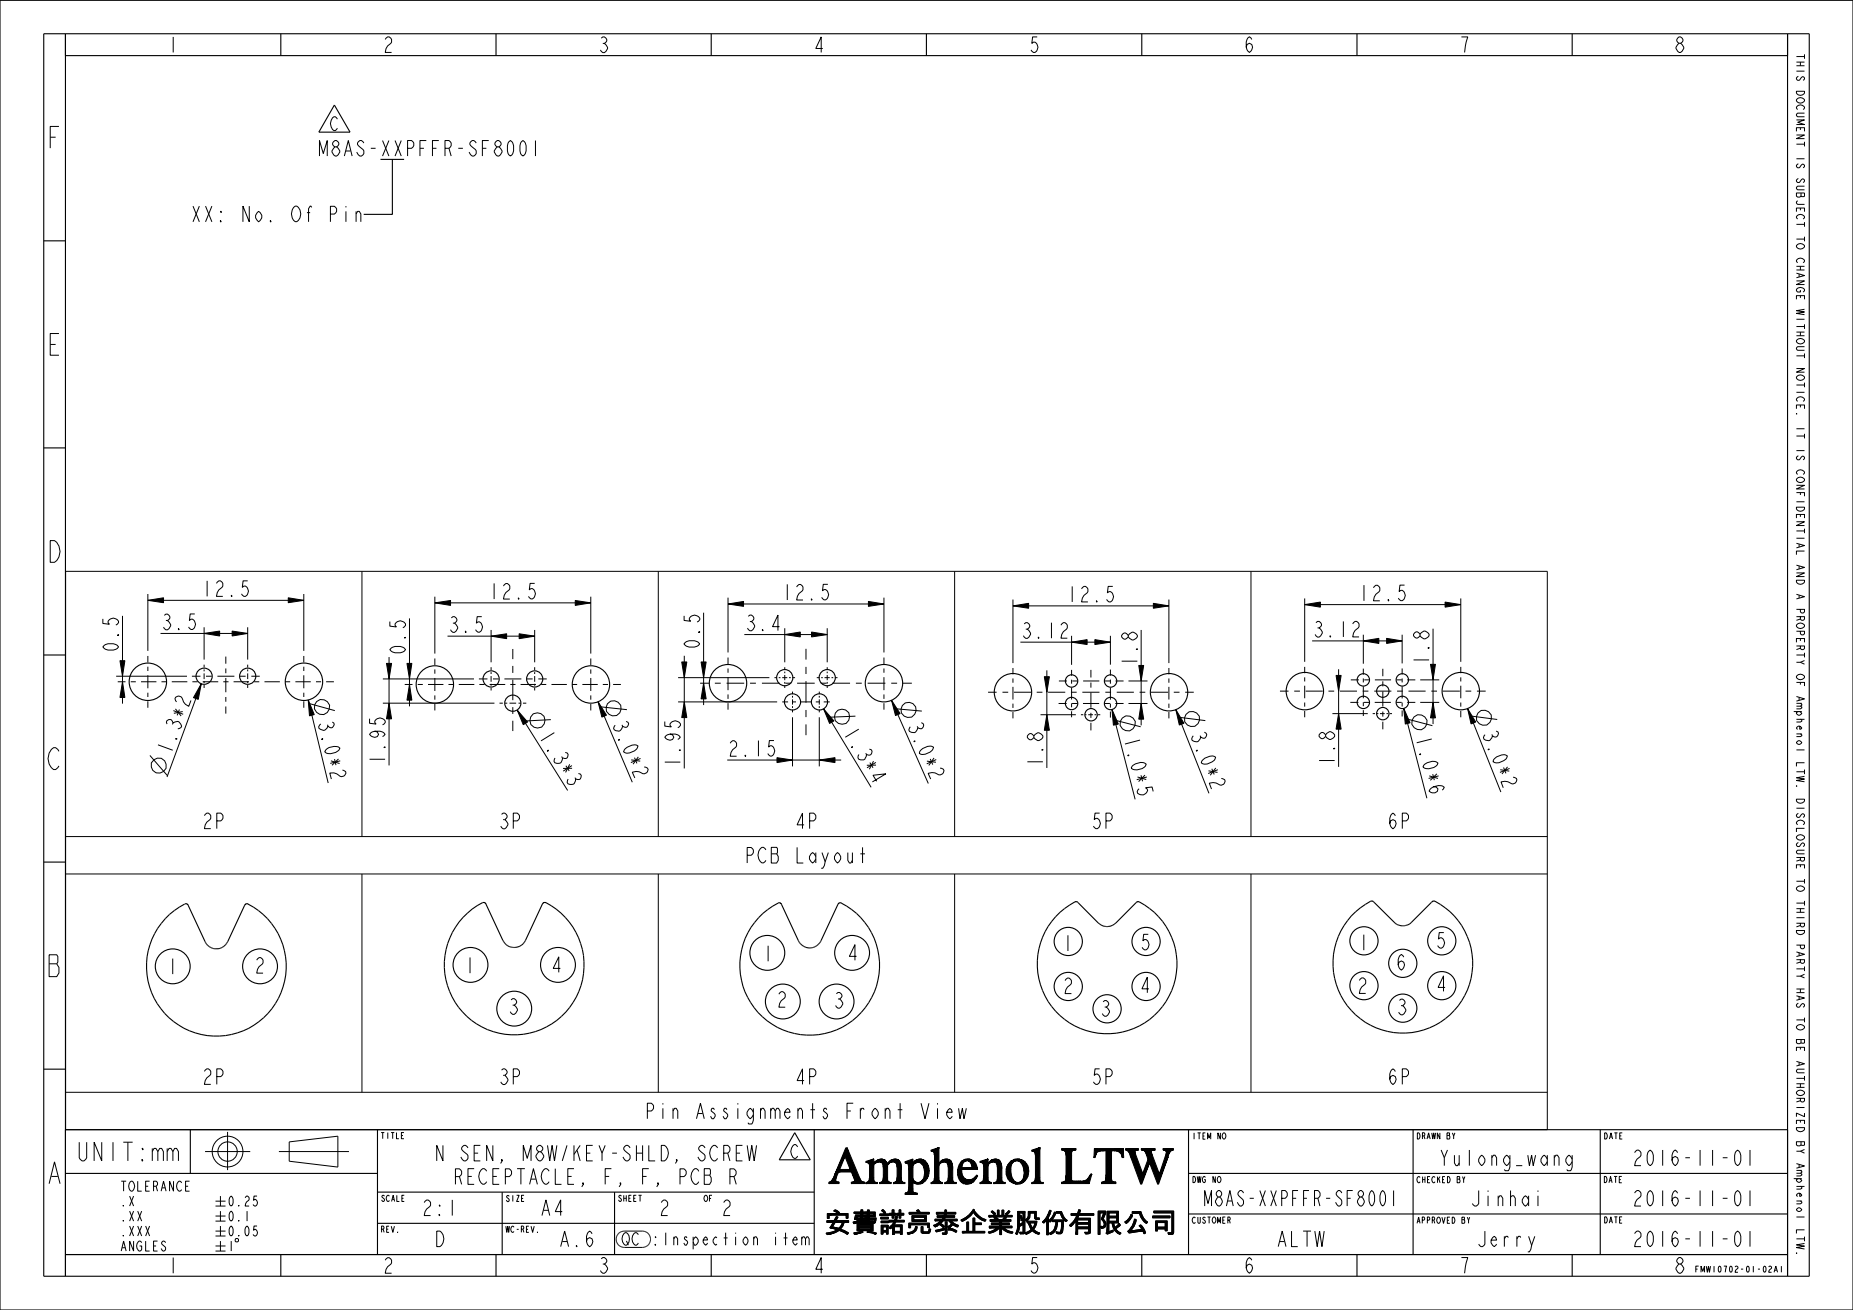
[picture p32: page 2]
