DeepSpace00/Awohali/hardware/electronics/lps28dfwBreakoutBoard/lps28dfwBreakoutBoard.kicad_pcb

## KiCad design hardware/electronics/lps28dfwBreakoutBoard/lps28dfwBreakoutBoard.kicad_pcb (2025-05-22)

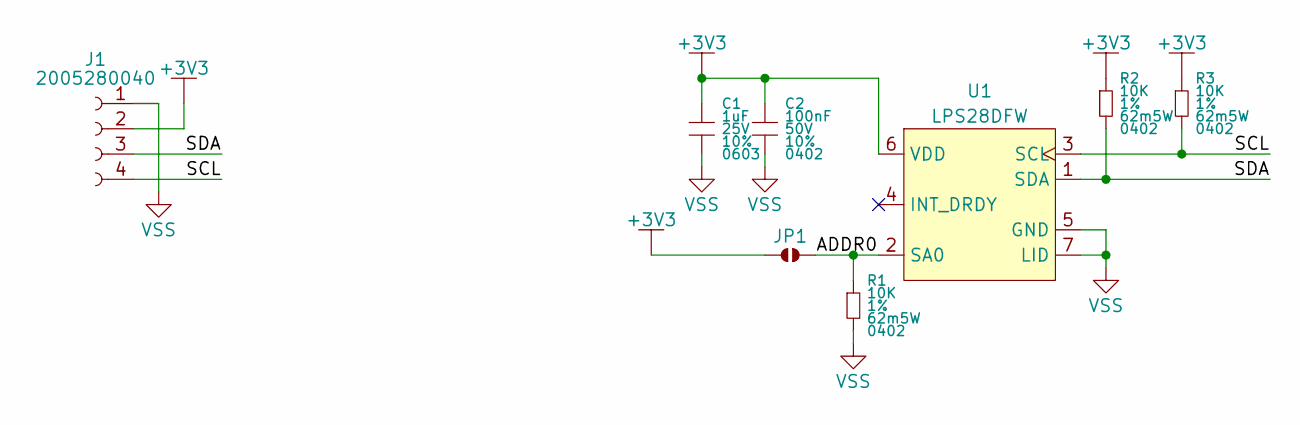
[picture p33: schematic lps28dfwBreakoutBoard.kicad_sch, LPS28DFW Breakout Board]

Parts:
C1: 1uF; GRT0603; Tolerance 10%; Voltage Rating 25V; MPN GRT188R71E105KE13D
C2: 100nF; GCM0402; Tolerance 10%; Voltage Rating 50V; MPN GRT155R71H104KE01D
J1: 2005280040; MPN 2005280040
JP1: SolderJumper-2_P1.3mm_Open_TrianglePad1.0x1.5mm
R1, R2, R3: 10K; CRCW0402; Tolerance 1%; Power Rating 62m5W; MPN CRCW040210K0FKED
U1: LPS28DFW; CCLGA7_LPS28DFWTR; MPN LPS28DFWTR

Connections:
+3V3: C1.1, C2.1, J1.2, JP1.1, R2.1, R3.1, U1.6 (VDD)
/ADDR0: JP1.2, R1.1, U1.2 (SA0)
/SCL: J1.4, R3.2, U1.3 (SCL)
/SDA: J1.3, R2.2, U1.1 (SDA)
VSS: C1.2, C2.2, J1.1, R1.2, U1.5 (GND), U1.7 (LID)

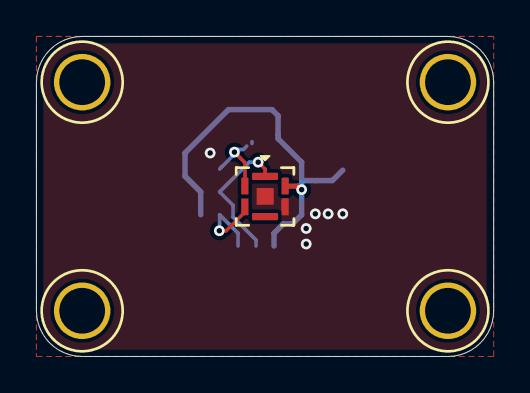
[picture p34: board lps28dfwBreakoutBoard.kicad_pcb from above]

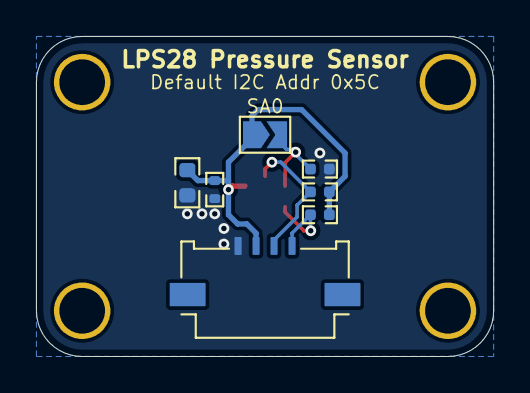
[picture p35: board lps28dfwBreakoutBoard.kicad_pcb from below]

Board: 2 copper layers, 25.4 x 17.8 mm, 8 parts (7 on the bottom side), 5 nets.
