DeepSpace00/Awohali/hardware/electronics/mainBoard/mainBoard.kicad_pcb

## KiCad design hardware/electronics/mainBoard/mainBoard.kicad_pcb (2025-03-31)

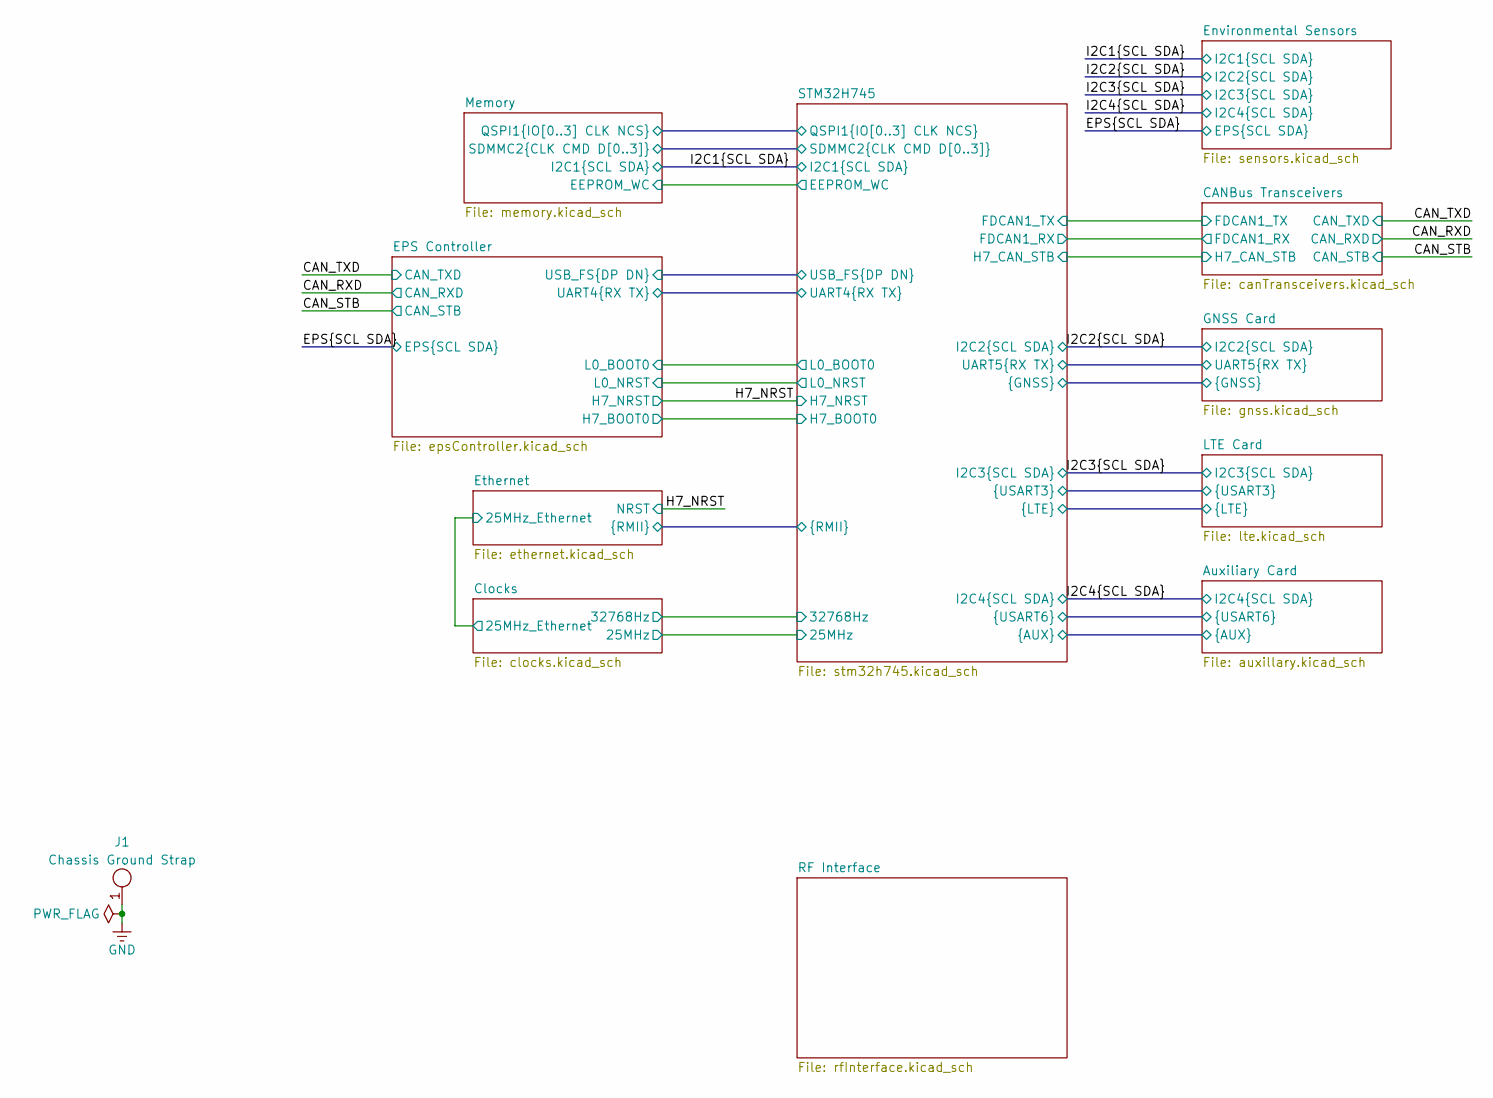
[picture p36: schematic mainBoard.kicad_sch, System Diagram]

Parts:
J1: Chassis Ground Strap; M4.5-MH; MPN L-1011-3

Connections:
GND: J1.1; also elsewhere on the board

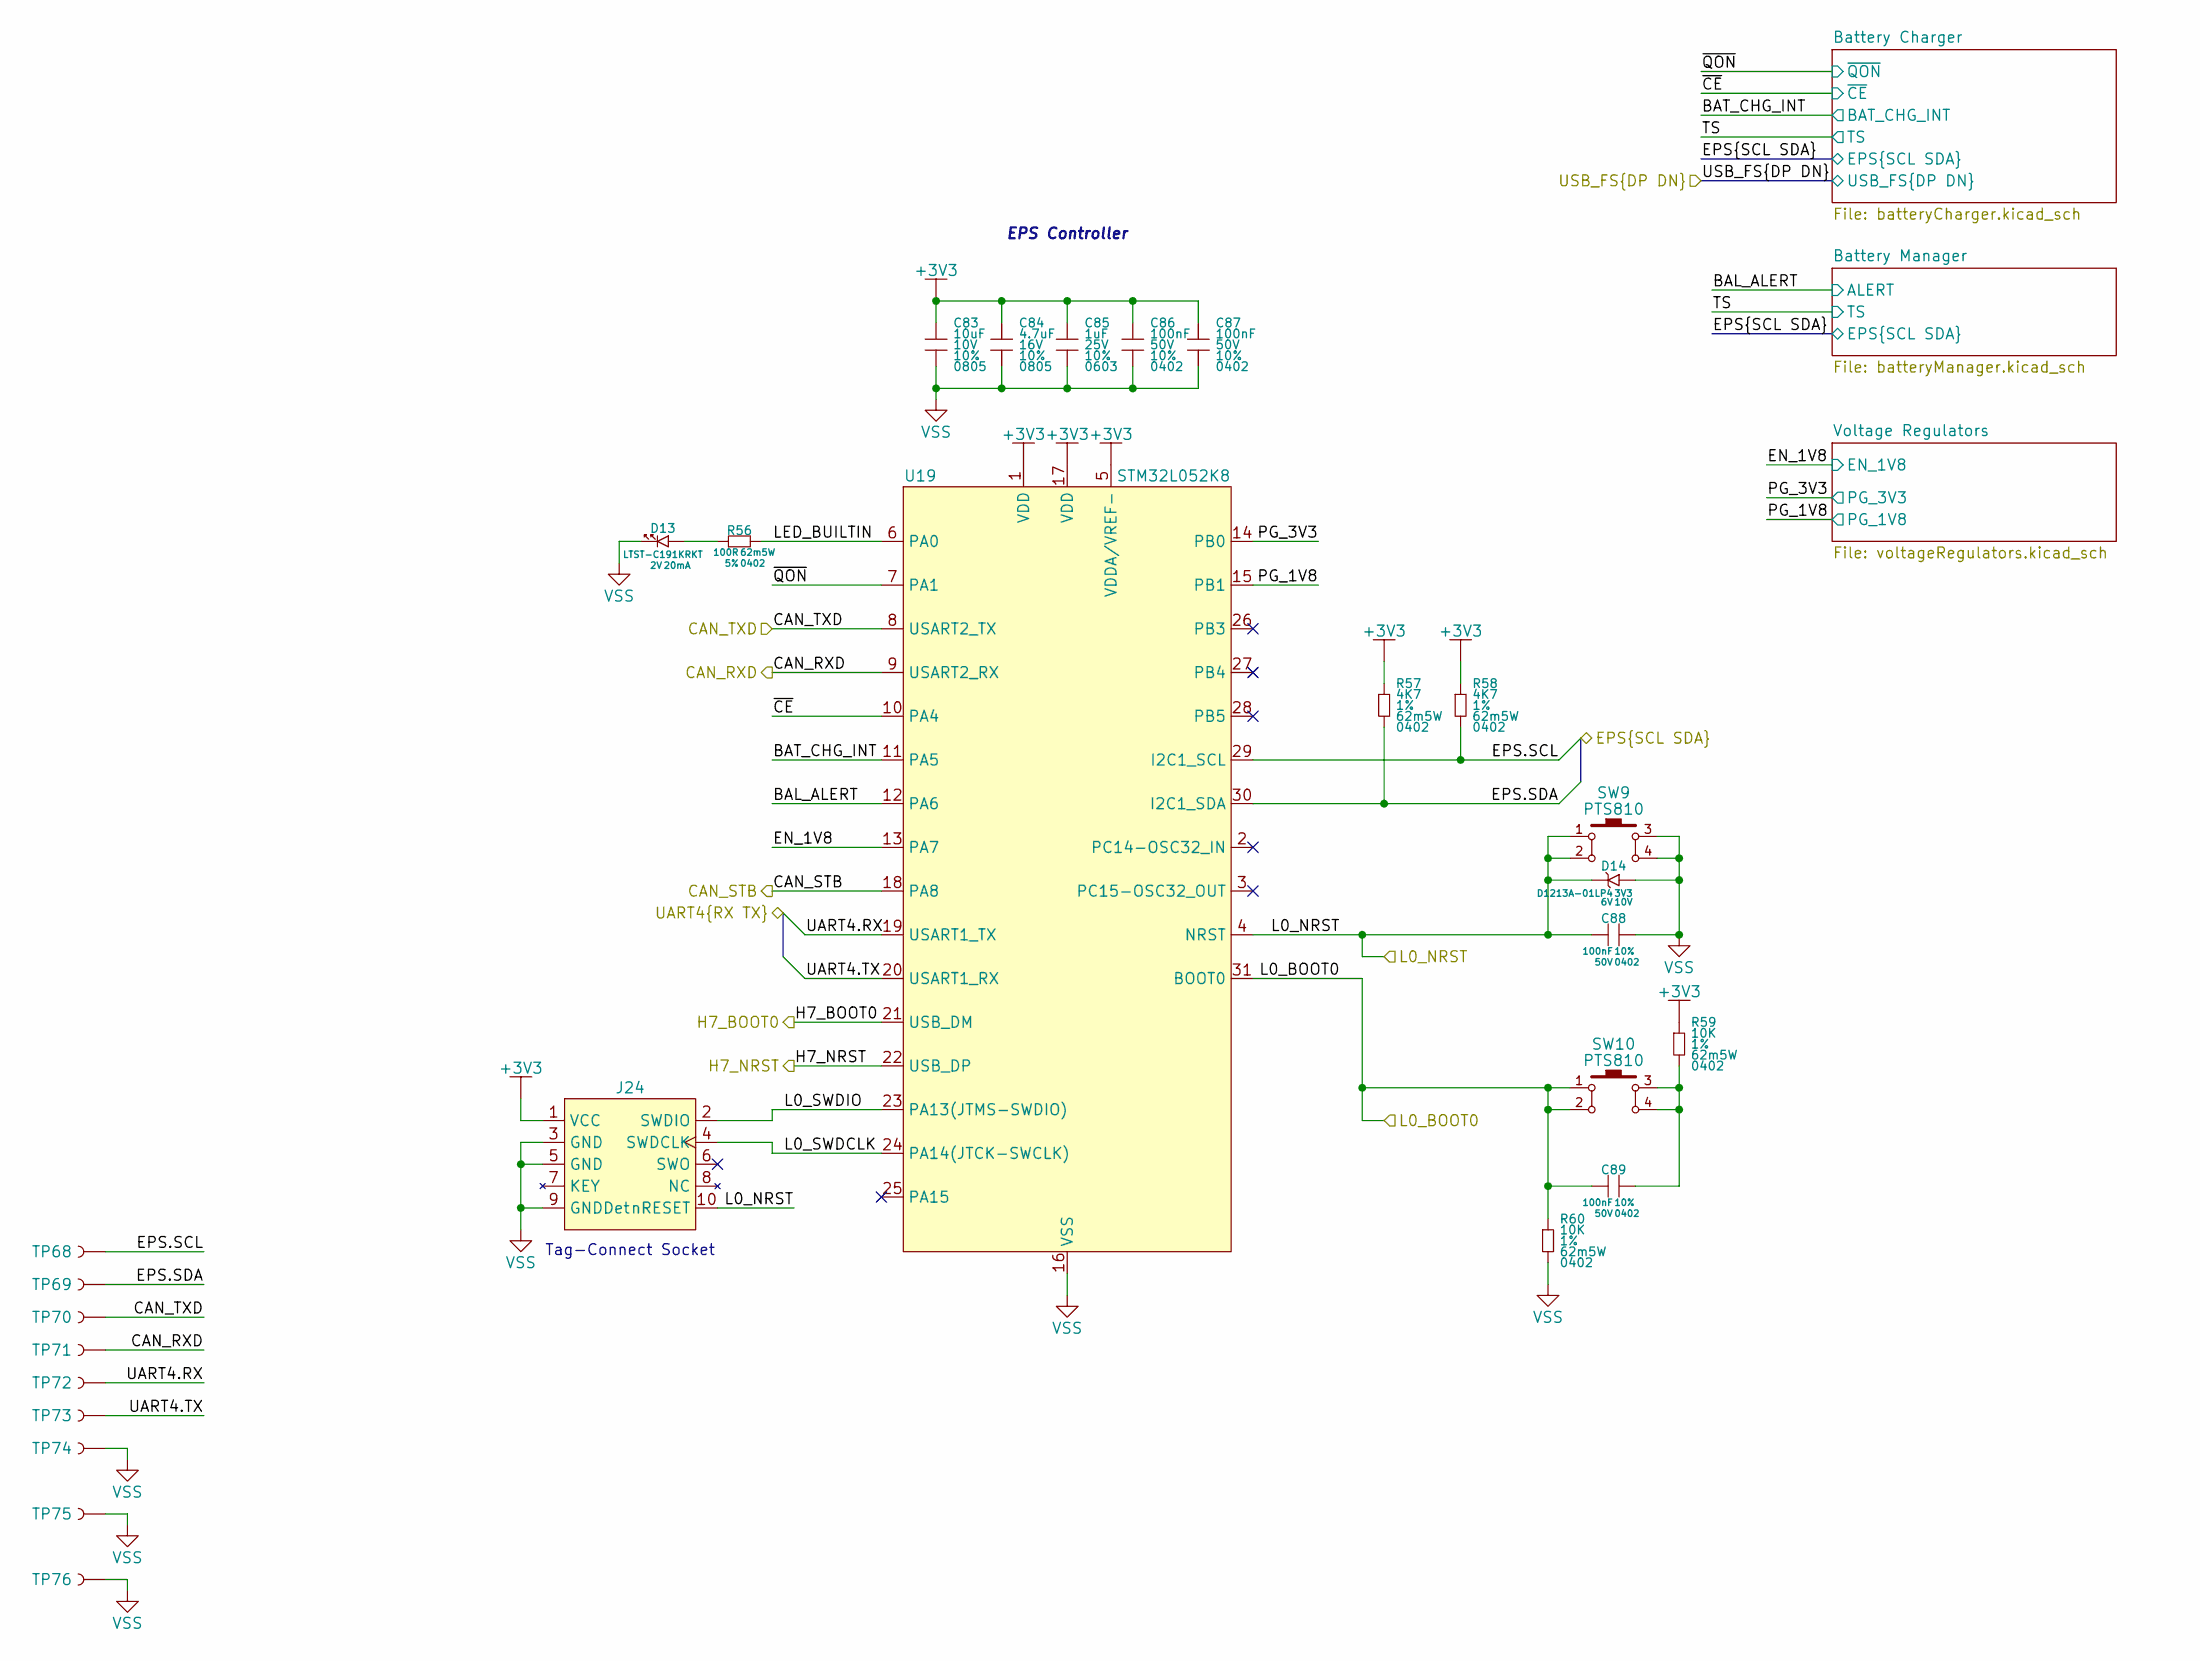
[picture p37: schematic epsController.kicad_sch, EPS Controller]

Parts:
C83: 10uF; GCM0805; Tolerance 10%; Voltage Rating 10V; MPN GCM21BR71A106KE22L
C84: 4.7uF; GCM0805; Tolerance 10%; Voltage Rating 16V; MPN GRT21BR71C475KE13L
C85: 1uF; GRT0603; Tolerance 10%; Voltage Rating 25V; MPN GRT188R71E105KE13D
C86, C87: 100nF; GCM0402; Tolerance 10%; Voltage Rating 50V; MPN GRT155R71H104KE01D
C88, C89: 100nF; GCM0402; Voltage Rating 50V; Tolerance 10%; MPN GRT155R71H104KE01D
D13: LTST-C191KRKT; LTST-0603; Forward Voltage 2V; MPN LTST-C191KRKT
D14: D1213A-01LP4; XDFN2P65_100X60X50L50X25L; Voltage - Reverse Stabd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 3V3; Voltage - Breakdown 6V; MPN D1213A-01LP4-7B
J24: TC2050-FP; MPN N/A
R56: 100R; CRCW0402; Tolerance 5%; Power Rating 62m5W; MPN CRCW0402100RJNED
R57, R58: 4K7; CRCW0402; Tolerance 1%; Power Rating 62m5W; MPN CRCW04024K70FKED
R59, R60: 10K; CRCW0402; Tolerance 1%; Power Rating 62m5W; MPN CRCW040210K0FKED
SW9, SW10: PTS810; MPN PTS810SJM250SMTR LFS
TP68, TP69, TP70, TP71, TP72, TP73: TP_2mm; MPN N/A
TP74, TP75, TP76: RCWCTE; TP_RCW; MPN RCWCTE
U19: STM32L052K8; UFQFPN32; MPN STM32L052K6U6TR

Connections:
+3V3: C83.1, C84.1, C85.1, C86.1, C87.1, J24.1 (VCC), R57.1, R58.1, R59.1, U19.1 (VDD), U19.5 (VDDA/VREF-), U19.17 (VDD); also elsewhere on the board
/CAN_RXD: TP71.1, U19.9 (USART2_RX); also elsewhere on the board
/CAN_STB: U19.18 (PA8); also elsewhere on the board
/CAN_TXD: TP70.1, U19.8 (USART2_TX); also elsewhere on the board
/EPS Controller/BAL_ALERT: U19.12 (PA6); also elsewhere on the board
/EPS Controller/BAT_CHG_INT: U19.11 (PA5); also elsewhere on the board
/EPS Controller/EN_1V8: U19.13 (PA7); also elsewhere on the board
/EPS Controller/H7_BOOT0: U19.21 (USB_DM); also elsewhere on the board
/EPS Controller/L0_BOOT0: C89.1, R60.1, SW10.1, SW10.2, U19.31 (BOOT0); also elsewhere on the board
/EPS Controller/L0_NRST: C88.1, D14.1, J24.10 (nRESET), SW9.1, SW9.2, U19.4 (NRST); also elsewhere on the board
/EPS Controller/L0_SWDCLK: J24.4 (SWDCLK), U19.24 (PA14(JTCK-SWCLK))
/EPS Controller/L0_SWDIO: J24.2 (SWDIO), U19.23 (PA13(JTMS-SWDIO))
/EPS Controller/LED_BUILTIN: R56.2, U19.6 (PA0)
/EPS Controller/PG_1V8: U19.15 (PB1); also elsewhere on the board
/EPS Controller/PG_3V3: U19.14 (PB0); also elsewhere on the board
/EPS Controller/UART4.RX: TP72.1, U19.19 (USART1_TX); also elsewhere on the board
/EPS Controller/UART4.TX: TP73.1, U19.20 (USART1_RX); also elsewhere on the board
/EPS Controller/~CE: U19.10 (PA4); also elsewhere on the board
/EPS Controller/~QON: U19.7 (PA1); also elsewhere on the board
/EPS.SCL: R58.2, TP68.1, U19.29 (I2C1_SCL); also elsewhere on the board
/EPS.SDA: R57.2, TP69.1, U19.30 (I2C1_SDA); also elsewhere on the board
/H7_NRST: U19.22 (USB_DP); also elsewhere on the board
unnamed: C89.2, R59.2, SW10.3, SW10.4
unnamed: D13.1, R56.1
VSS: C83.2, C84.2, C85.2, C86.2, C87.2, C88.2, D13.2, D14.2, J24.3 (GND), J24.5 (GND), J24.9 (GNDDet), R60.2, SW9.3, SW9.4, TP74.1, TP75.1, TP76.1, U19.16 (VSS), U19.32 (VSS), U19.33 (VSS); also elsewhere on the board

Notes on the sheet:
Tag-Connect Socket
EPS Controller

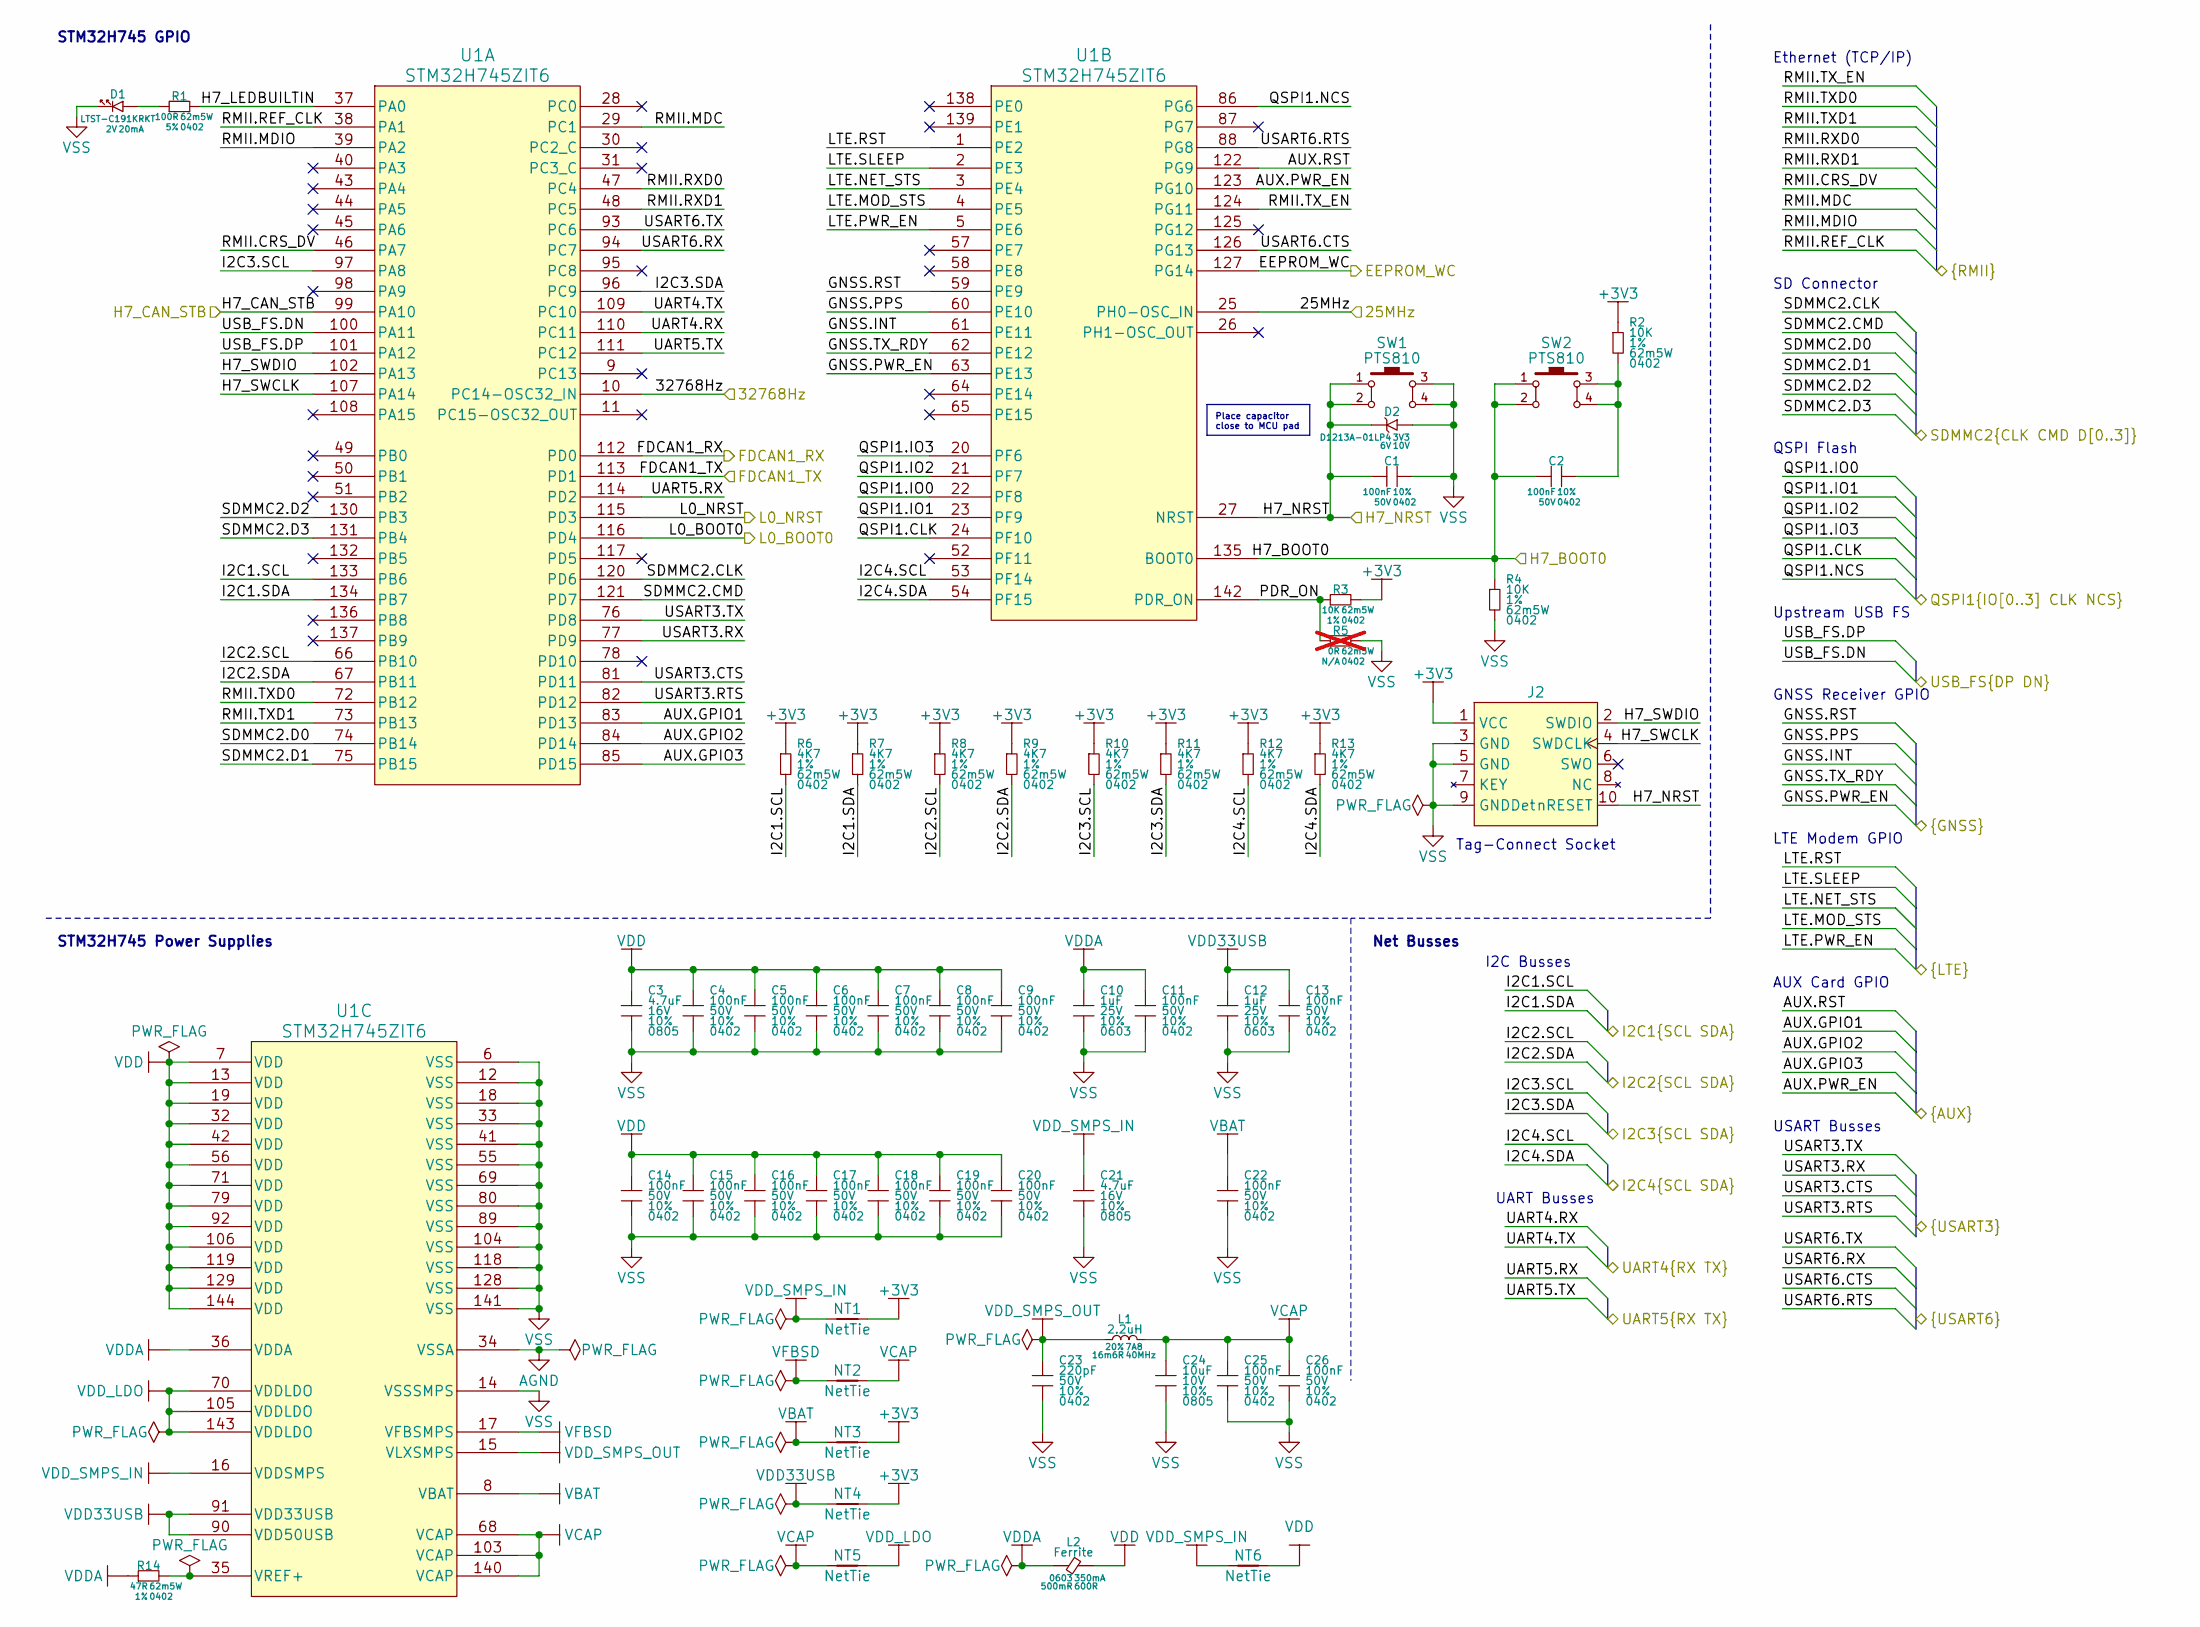
[picture p38: schematic stm32h745.kicad_sch, STM32H745 I/Os]

Parts:
C1, C2, C4, C5, C6, C7, C8, C9, C11, C13, C14, C15, C16, C17, C18, C19, C20, C22, C25, C26: 100nF; GCM0402; Tolerance 10%; Voltage Rating 50V; MPN GRT155R71H104KE01D
C3, C21: 4.7uF; GCM0805; Tolerance 10%; Voltage Rating 16V; MPN GRT21BR71C475KE13L
C10, C12: 1uF; GRT0603; Tolerance 10%; Voltage Rating 25V; MPN GRT188R71E105KE13D
C23: 220pF; GCM0402; Tolerance 10%; Voltage Rating 50V; MPN GRT155R71H221KE01D
C24: 10uF; GCM0805; Tolerance 10%; Voltage Rating 10V; MPN GCM21BR71A106KE22L
D1: LTST-C191KRKT; LTST-0603; Forward Voltage 2V; MPN LTST-C191KRKT
D2: D1213A-01LP4; XDFN2P65_100X60X50L50X25L; Voltage - Reverse Stabd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 3V3; Voltage - Breakdown 6V; MPN D1213A-01LP4-7B
J2: TC2050-FP; MPN N/A
L1: 2.2uH; WE-XHMI-4030; Tolerance 20%; Current Rating 7A8; MPN 74439324022
L2: Ferrite; L_0603; Current Rating 350mA; MPN MFBA3V1608K-601-R
NT1, NT2, NT3, NT4, NT5, NT6: NetTie; NetTie-2_SMD_Pad2.0mm
R1: 100R; CRCW0402; Tolerance 5%; Power Rating 62m5W; MPN CRCW0402100RJNED
R2, R3, R4: 10K; CRCW0402; Tolerance 1%; Power Rating 62m5W; MPN CRCW040210K0FKED
R5: 0R; CRCW0402; Tolerance N/A; Power Rating 62m5W; MPN CRCW04020000Z0ED; not fitted
R6, R7, R8, R9, R10, R11, R12, R13: 4K7; CRCW0402; Tolerance 1%; Power Rating 62m5W; MPN CRCW04024K70FKED
R14: 47R; CRCW0402; Tolerance 1%; Power Rating 62m5W; MPN CRCW040247R0FKED
SW1, SW2: PTS810; MPN PTS810SJM250SMTR LFS
U1: STM32H745ZIT6; LQFP-144; MPN STM32H745ZIT6

Connections:
+3V3: J2.1 (VCC), NT1.2, NT3.2, NT4.2, R2.1, R3.2, R6.1, R7.1, R8.1, R9.1, R10.1, R11.1, R12.1, R13.1; also elsewhere on the board
/Auxiliary Card/AUX.GPIO1: U1.83 (PD13); also elsewhere on the board
/Auxiliary Card/AUX.GPIO2: U1.84 (PD14); also elsewhere on the board
/Auxiliary Card/AUX.GPIO3: U1.85 (PD15); also elsewhere on the board
/Auxiliary Card/AUX.PWR_EN: U1.123 (PG10); also elsewhere on the board
/Auxiliary Card/AUX.RST: U1.122 (PG9); also elsewhere on the board
/Auxiliary Card/USART6.CTS: U1.126 (PG13); also elsewhere on the board
/Auxiliary Card/USART6.RTS: U1.88 (PG8); also elsewhere on the board
/Auxiliary Card/USART6.RX: U1.94 (PC7); also elsewhere on the board
/Auxiliary Card/USART6.TX: U1.93 (PC6); also elsewhere on the board
/CANBus Transceivers/FDCAN1_RX: U1.112 (PD0); also elsewhere on the board
/CANBus Transceivers/FDCAN1_TX: U1.113 (PD1); also elsewhere on the board
/CANBus Transceivers/H7_CAN_STB: U1.99 (PA10); also elsewhere on the board
/EPS Controller/H7_BOOT0: C2.1, R4.1, SW2.1, SW2.2, U1.135 (BOOT0); also elsewhere on the board
/EPS Controller/L0_BOOT0: U1.116 (PD4); also elsewhere on the board
/EPS Controller/L0_NRST: U1.115 (PD3); also elsewhere on the board
/EPS Controller/UART4.RX: U1.110 (PC11); also elsewhere on the board
/EPS Controller/UART4.TX: U1.109 (PC10); also elsewhere on the board
/EPS Controller/USB_FS.DN: U1.100 (PA11); also elsewhere on the board
/EPS Controller/USB_FS.DP: U1.101 (PA12); also elsewhere on the board
/Ethernet/RMII.CRS_DV: U1.46 (PA7); also elsewhere on the board
/Ethernet/RMII.MDC: U1.29 (PC1); also elsewhere on the board
/Ethernet/RMII.MDIO: U1.39 (PA2); also elsewhere on the board
/Ethernet/RMII.REF_CLK: U1.38 (PA1); also elsewhere on the board
/Ethernet/RMII.RXD0: U1.47 (PC4); also elsewhere on the board
/Ethernet/RMII.RXD1: U1.48 (PC5); also elsewhere on the board
/Ethernet/RMII.TXD0: U1.72 (PB12); also elsewhere on the board
/Ethernet/RMII.TXD1: U1.73 (PB13); also elsewhere on the board
/Ethernet/RMII.TX_EN: U1.124 (PG11); also elsewhere on the board
/GNSS Card/GNSS.INT: U1.61 (PE11); also elsewhere on the board
/GNSS Card/GNSS.PPS: U1.60 (PE10); also elsewhere on the board
/GNSS Card/GNSS.PWR_EN: U1.63 (PE13); also elsewhere on the board
/GNSS Card/GNSS.RST: U1.59 (PE9); also elsewhere on the board
/GNSS Card/GNSS.TX_RDY: U1.62 (PE12); also elsewhere on the board
/GNSS Card/UART5.RX: U1.114 (PD2); also elsewhere on the board
/GNSS Card/UART5.TX: U1.111 (PC12); also elsewhere on the board
/H7_NRST: C1.1, D2.1, J2.10 (nRESET), SW1.1, SW1.2, U1.27 (NRST); also elsewhere on the board
/I2C1.SCL: R6.2, U1.133 (PB6); also elsewhere on the board
/I2C1.SDA: R7.2, U1.134 (PB7); also elsewhere on the board
/I2C2.SCL: R8.2, U1.66 (PB10); also elsewhere on the board
/I2C2.SDA: R9.2, U1.67 (PB11); also elsewhere on the board
/I2C3.SCL: R10.2, U1.97 (PA8); also elsewhere on the board
/I2C3.SDA: R11.2, U1.96 (PC9); also elsewhere on the board
/I2C4.SCL: R12.2, U1.53 (PF14); also elsewhere on the board
/I2C4.SDA: R13.2, U1.54 (PF15); also elsewhere on the board
/LTE Card/LTE.MOD_STS: U1.4 (PE5); also elsewhere on the board
/LTE Card/LTE.NET_STS: U1.3 (PE4); also elsewhere on the board
/LTE Card/LTE.PWR_EN: U1.5 (PE6); also elsewhere on the board
/LTE Card/LTE.RST: U1.1 (PE2); also elsewhere on the board
/LTE Card/LTE.SLEEP: U1.2 (PE3); also elsewhere on the board
/LTE Card/USART3.CTS: U1.81 (PD11); also elsewhere on the board
/LTE Card/USART3.RTS: U1.82 (PD12); also elsewhere on the board
/LTE Card/USART3.RX: U1.77 (PD9); also elsewhere on the board
/LTE Card/USART3.TX: U1.76 (PD8); also elsewhere on the board
/Memory/EEPROM_WC: U1.127 (PG14); also elsewhere on the board
/Memory/QSPI1.CLK: U1.24 (PF10); also elsewhere on the board
/Memory/QSPI1.IO0: U1.22 (PF8); also elsewhere on the board
/Memory/QSPI1.IO1: U1.23 (PF9); also elsewhere on the board
/Memory/QSPI1.IO2: U1.21 (PF7); also elsewhere on the board
/Memory/QSPI1.IO3: U1.20 (PF6); also elsewhere on the board
/Memory/QSPI1.NCS: U1.86 (PG6); also elsewhere on the board
/Memory/SDMMC2.CLK: U1.120 (PD6); also elsewhere on the board
/Memory/SDMMC2.CMD: U1.121 (PD7); also elsewhere on the board
/Memory/SDMMC2.D0: U1.74 (PB14); also elsewhere on the board
/Memory/SDMMC2.D1: U1.75 (PB15); also elsewhere on the board
/Memory/SDMMC2.D2: U1.130 (PB3); also elsewhere on the board
/Memory/SDMMC2.D3: U1.131 (PB4); also elsewhere on the board
/STM32H745/25MHz: U1.25 (PH0-OSC_IN); also elsewhere on the board
/STM32H745/32768Hz: U1.10 (PC14-OSC32_IN); also elsewhere on the board
/STM32H745/H7_LEDBUILTIN: R1.2, U1.37 (PA0)
/STM32H745/H7_SWCLK: J2.4 (SWDCLK), U1.107 (PA14)
/STM32H745/H7_SWDIO: J2.2 (SWDIO), U1.102 (PA13)
/STM32H745/PDR_ON: R3.1, R5.1, U1.142 (PDR_ON)
AGND: U1.34 (VSSA); also elsewhere on the board
unnamed: C2.2, R2.2, SW2.3, SW2.4
unnamed: D1.1, R1.1
unnamed: R14.2, U1.35 (VREF+)
VBAT: C22.1, NT3.1, U1.8 (VBAT)
VCAP: C24.1, C25.1, C26.1, L1.2, NT2.2, NT5.1, U1.68 (VCAP), U1.103 (VCAP), U1.140 (VCAP)
VDD: C3.1, C4.1, C5.1, C6.1, C7.1, C8.1, C9.1, C14.1, C15.1, C16.1, C17.1, C18.1, C19.1, C20.1, L2.2, NT6.2, U1.7 (VDD), U1.13 (VDD), U1.19 (VDD), U1.32 (VDD), U1.42 (VDD), U1.56 (VDD), U1.71 (VDD), U1.79 (VDD), U1.92 (VDD), U1.106 (VDD), U1.119 (VDD), U1.129 (VDD), U1.144 (VDD)
VDD33USB: C12.1, C13.1, NT4.1, U1.90 (VDD50USB), U1.91 (VDD33USB)
VDDA: C10.1, C11.1, L2.1, R14.1, U1.36 (VDDA)
VDD_LDO: NT5.2, U1.70 (VDDLDO), U1.105 (VDDLDO), U1.143 (VDDLDO)
VDD_SMPS_IN: C21.1, NT1.1, NT6.1, U1.16 (VDDSMPS)
VDD_SMPS_OUT: C23.1, L1.1, U1.15 (VLXSMPS)
VFBSD: NT2.1, U1.17 (VFBSMPS)
VSS: C1.2, C3.2, C4.2, C5.2, C6.2, C7.2, C8.2, C9.2, C10.2, C11.2, C12.2, C13.2, C14.2, C15.2, C16.2, C17.2, C18.2, C19.2, C20.2, C21.2, C22.2, C23.2, C24.2, C25.2, C26.2, D1.2, D2.2, J2.3 (GND), J2.5 (GND), J2.9 (GNDDet), R4.2, R5.2, SW1.3, SW1.4, U1.6 (VSS), U1.12 (VSS), U1.14 (VSSSMPS), U1.18 (VSS), U1.33 (VSS), U1.41 (VSS), U1.55 (VSS), U1.69 (VSS), U1.80 (VSS), U1.89 (VSS), U1.104 (VSS), U1.118 (VSS), U1.128 (VSS), U1.141 (VSS); also elsewhere on the board

Notes on the sheet:
I2C Busses
USART Busses
UART Busses
GNSS Receiver GPIO
Ethernet (TCP/IP)
Tag-Connect Socket
QSPI Flash
SD Connector
AUX Card GPIO
Net Busses
STM32H745 GPIO
STM32H745 Power Supplies
Upstream USB FS
LTE Modem GPIO
Place capacitor close to MCU pad

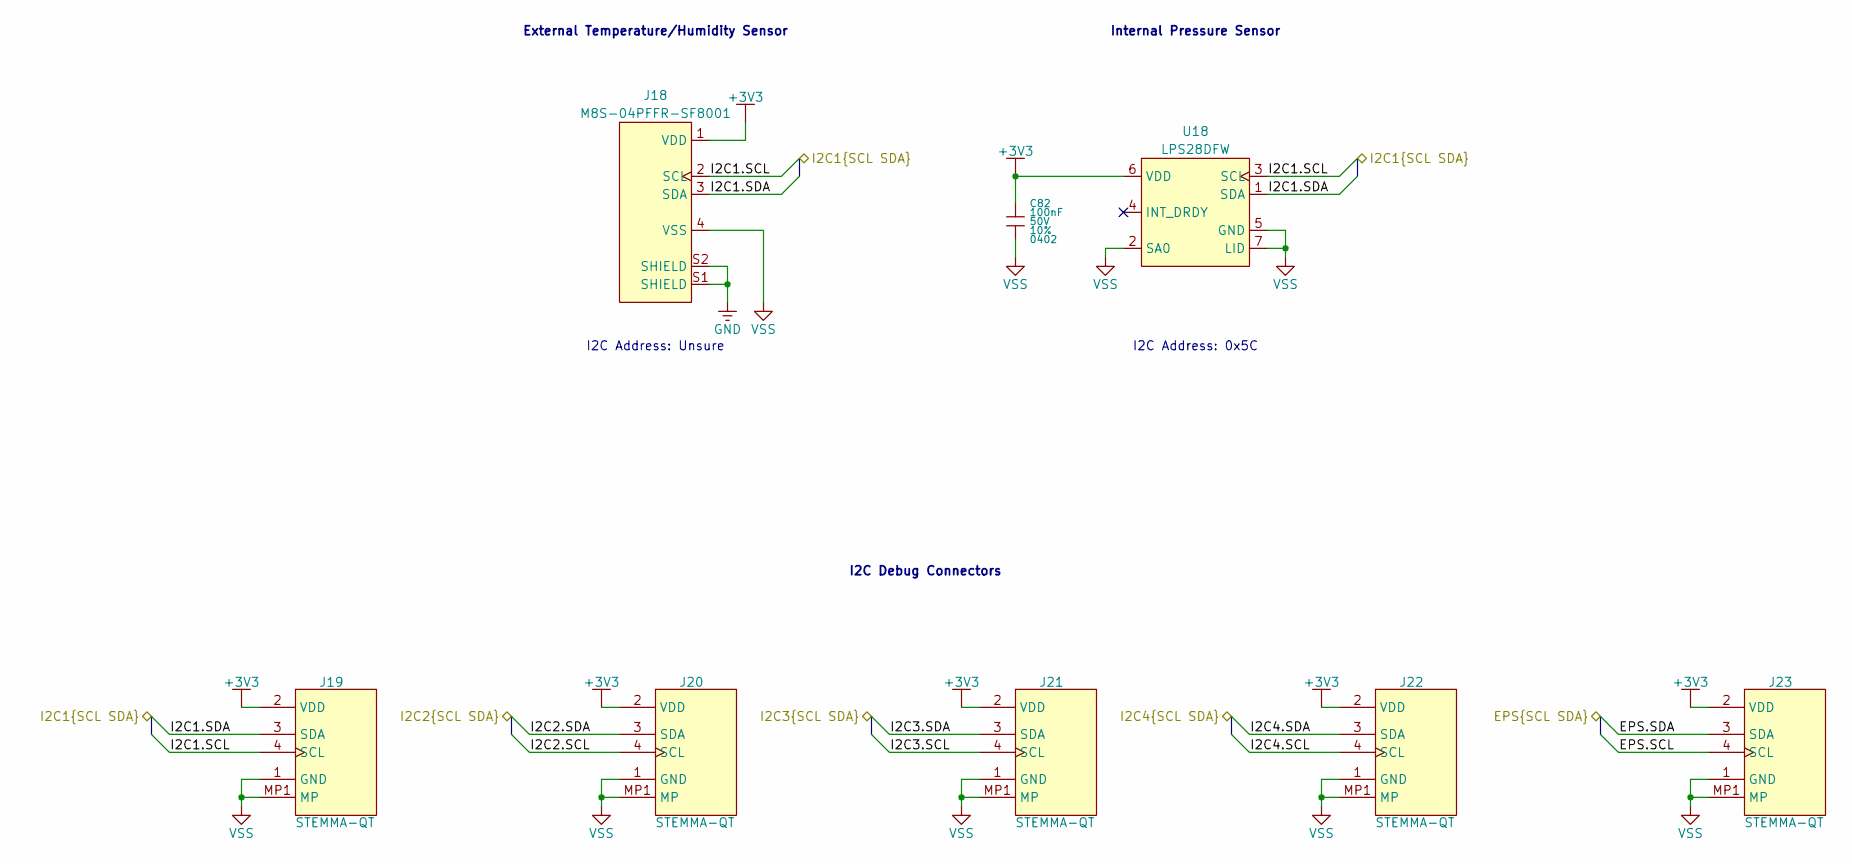
[picture p39: schematic sensors.kicad_sch, Environmental Sensors]

Parts:
C82: 100nF; GCM0402; Tolerance 10%; Voltage Rating 50V; MPN GRT155R71H104KE01D
J18: M8S-04PFFR-SF8001; MPN M8S-04PFFR-SF8001
J19, J20, J21, J22, J23: STEMMA-QT; JST_SH_BM04B-SRSS-TB; MPN BM04B-SRSS-TB
U18: LPS28DFW; CCLGA7_LPS28DFWTR; MPN LPS28DFWTR

Connections:
+3V3: C82.1, J18.1 (VDD), J19.2 (VDD), J20.2 (VDD), J21.2 (VDD), J22.2 (VDD), J23.2 (VDD), U18.6 (VDD); also elsewhere on the board
/EPS.SCL: J23.4 (SCL); also elsewhere on the board
/EPS.SDA: J23.3 (SDA); also elsewhere on the board
/I2C1.SCL: J18.2 (SCL), J19.4 (SCL), U18.3 (SCL); also elsewhere on the board
/I2C1.SDA: J18.3 (SDA), J19.3 (SDA), U18.1 (SDA); also elsewhere on the board
/I2C2.SCL: J20.4 (SCL); also elsewhere on the board
/I2C2.SDA: J20.3 (SDA); also elsewhere on the board
/I2C3.SCL: J21.4 (SCL); also elsewhere on the board
/I2C3.SDA: J21.3 (SDA); also elsewhere on the board
/I2C4.SCL: J22.4 (SCL); also elsewhere on the board
/I2C4.SDA: J22.3 (SDA); also elsewhere on the board
GND: J18.S1 (SHIELD), J18.S2 (SHIELD); also elsewhere on the board
VSS: C82.2, J18.4 (VSS), J19.1 (GND), J19.MP1 (MP), J19.MP2 (MP), J20.1 (GND), J20.MP1 (MP), J20.MP2 (MP), J21.1 (GND), J21.MP1 (MP), J21.MP2 (MP), J22.1 (GND), J22.MP1 (MP), J22.MP2 (MP), J23.1 (GND), J23.MP1 (MP), J23.MP2 (MP), U18.2 (SA0), U18.5 (GND), U18.7 (LID); also elsewhere on the board

Notes on the sheet:
I2C Address: Unsure
I2C Address: 0x5C
Internal Pressure Sensor
I2C Debug Connectors
External Temperature/Humidity Sensor
