DeepSpace00/Awohali/hardware/electronics/mainBoard/mainBoard.kicad_pcb

## KiCad design hardware/electronics/mainBoard/mainBoard.kicad_pcb (continued)

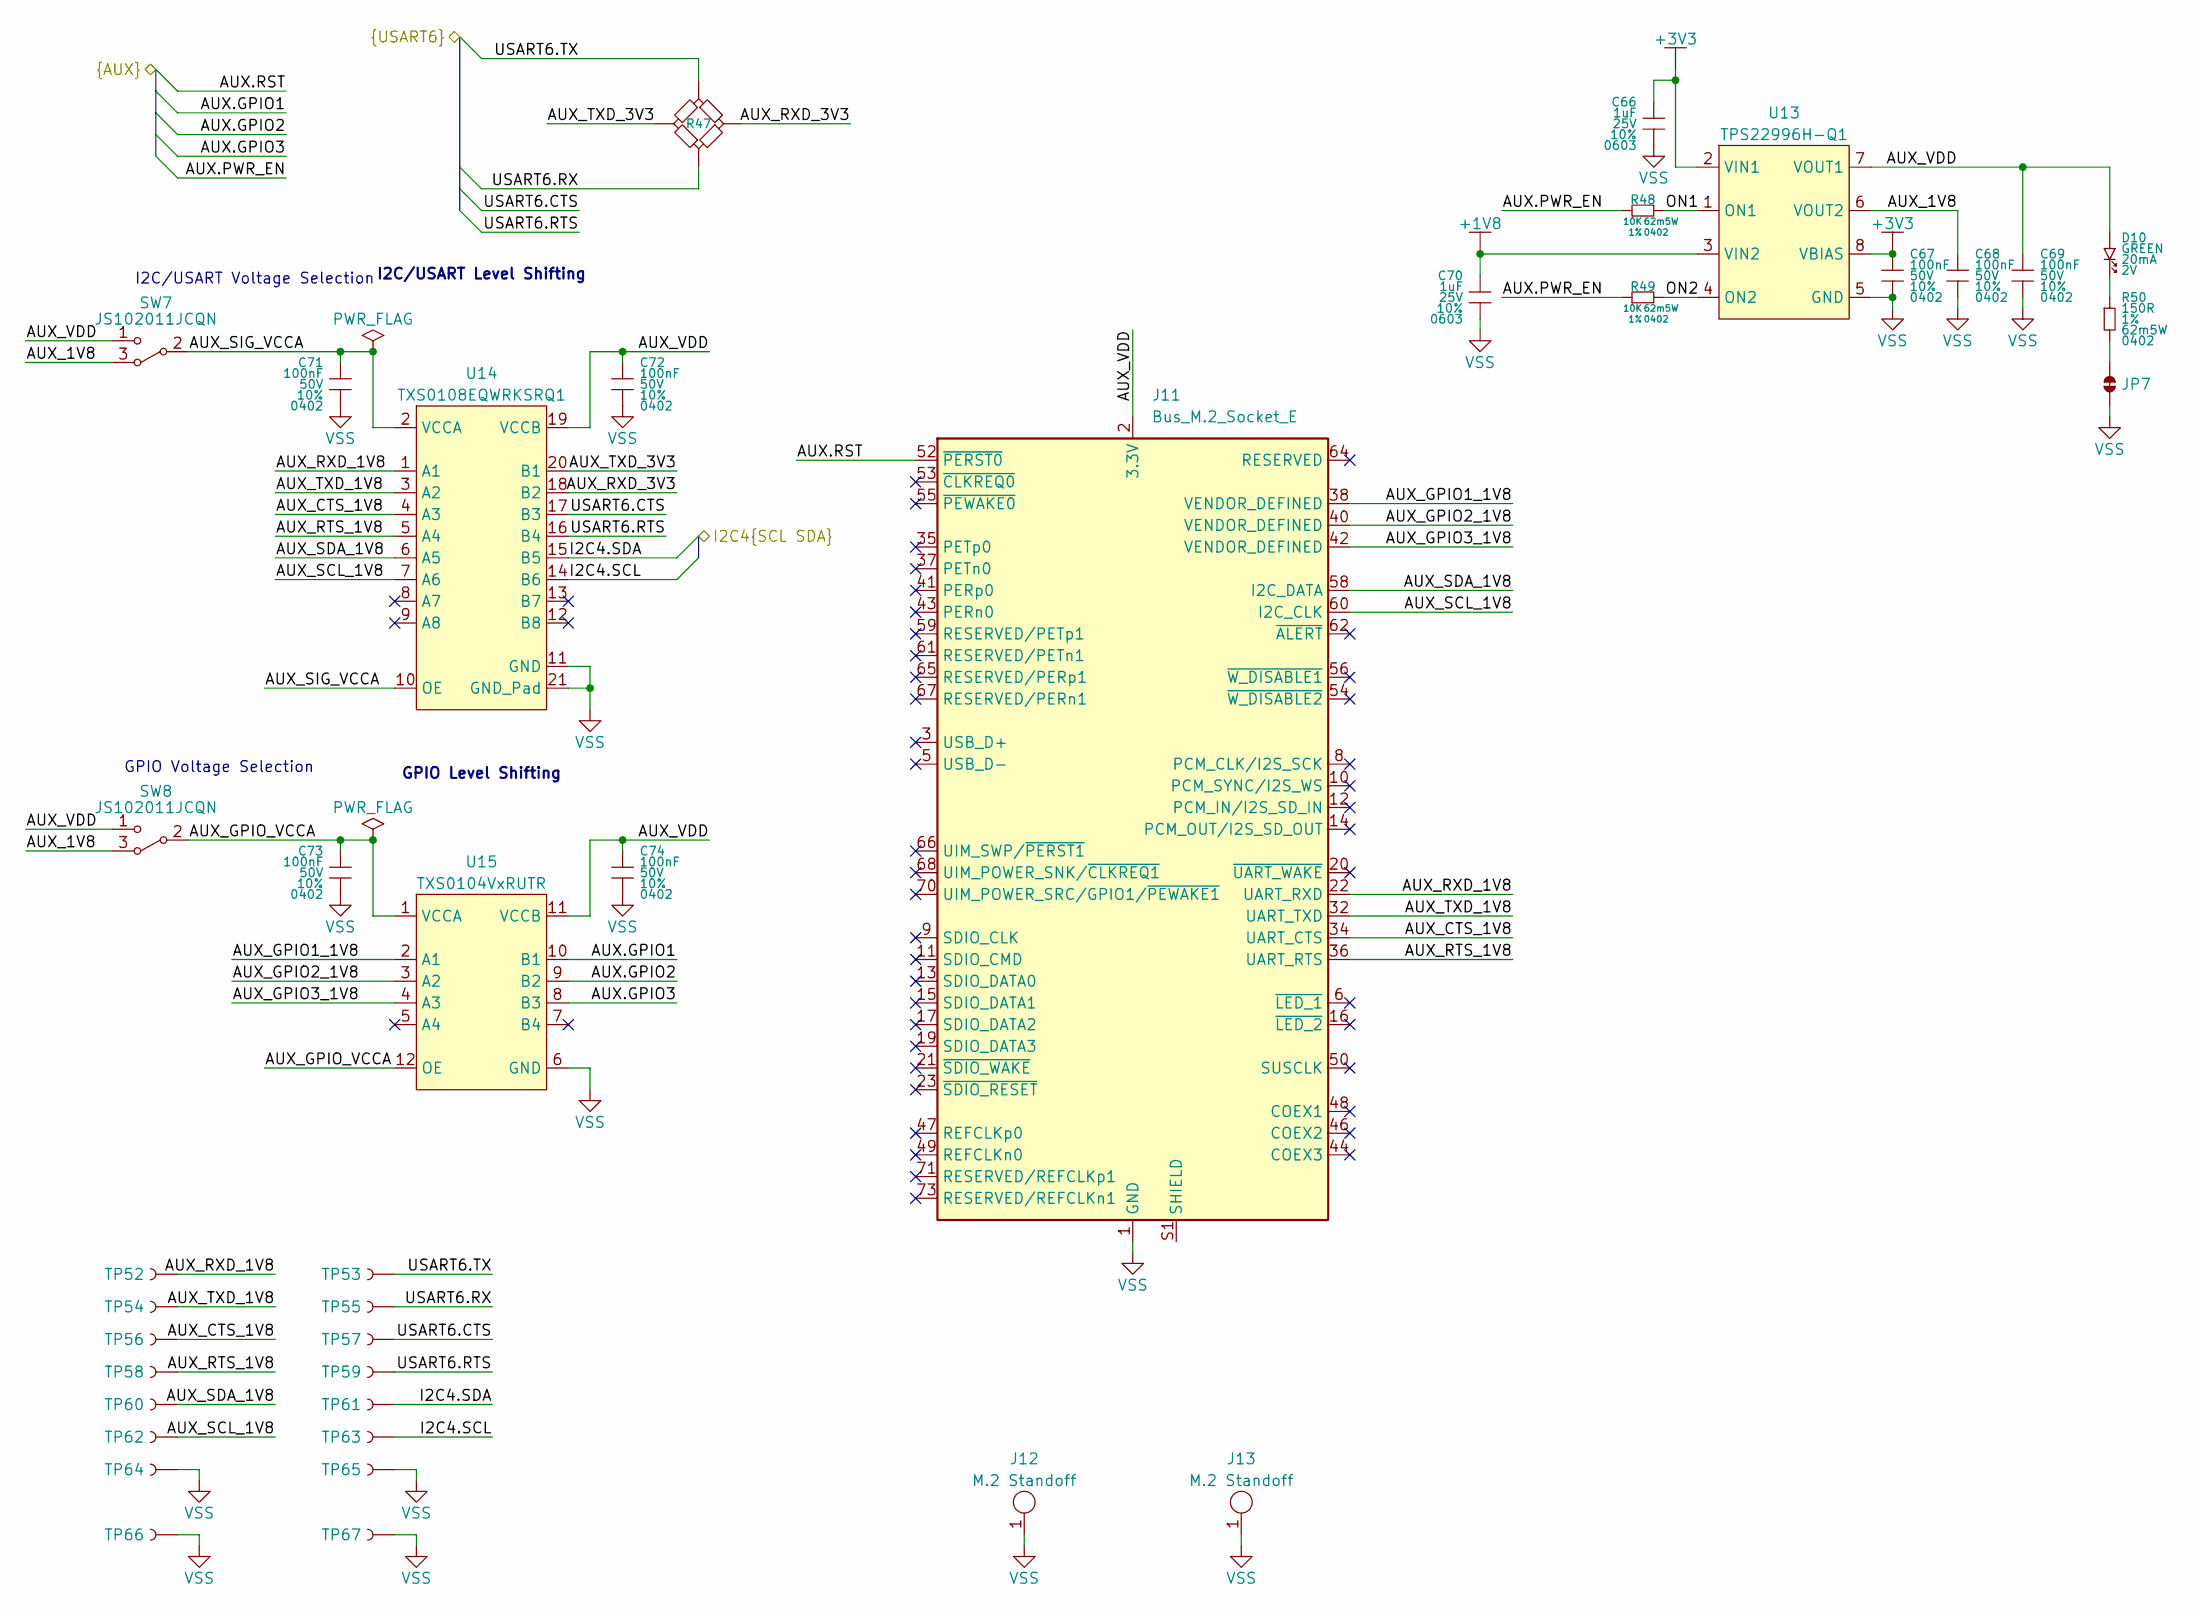
[picture p40: schematic auxillary.kicad_sch, Auxillary M.2 Card]

Parts:
C66, C70: 1uF; GRT0603; Tolerance 10%; Voltage Rating 25V; MPN GRT188R71E105KE13D
C67, C68, C69, C71, C72, C73, C74: 100nF; GCM0402; Tolerance 10%; Voltage Rating 50V; MPN GRT155R71H104KE01D
D10: LTST-C191KGKT; LTST-0603; Forward Voltage 2V; MPN LTST-C191KGKT
J11: Bus_M.2_Socket_E; MDT420E01001; MPN MDT420E01001
J12, J13: M.2 Standoff; MountingHole_3.5mm_Pad_Via; MPN 123A-NUT-42
JP7: SolderJumper-2_P1.3mm_Bridged_RoundedPad1.0x1.5mm
R47: CRCW0402_QUAD_UART
R48, R49: 10K; CRCW0402; Tolerance 1%; Power Rating 62m5W; MPN CRCW040210K0FKED
R50: 150R; CRCW0402; Tolerance 1%; Power Rating 62m5W; MPN CRCW0402150RFKED
SW7, SW8: JS102011JCQN; MPN C&K
TP52, TP53, TP54, TP55, TP56, TP57, TP58, TP59, TP60, TP61, TP62, TP63: TP_2mm; MPN N/A
TP64, TP65, TP66, TP67: RCWCTE; TP_RCW; MPN RCWCTE
U13: TPS22996H-Q1; SOT583; MPN TPS22996HQDYCRQ1
U14: TXS0108EQWRKSRQ1; QFN50P450X250X100-20; MPN TXS0108EQWRKSRQ1
U15: TXS0104VxRUTR; QFN40P170X200X55-12; MPN TXS0104VQRUTRQ1

Connections:
+1V8: C70.1, U13.3 (VIN2); also elsewhere on the board
+3V3: C66.1, C67.1, U13.2 (VIN1), U13.8 (VBIAS); also elsewhere on the board
/Auxiliary Card/AUX.GPIO1: U15.10 (B1); also elsewhere on the board
/Auxiliary Card/AUX.GPIO2: U15.9 (B2); also elsewhere on the board
/Auxiliary Card/AUX.GPIO3: U15.8 (B3); also elsewhere on the board
/Auxiliary Card/AUX.PWR_EN: R48.1, R49.1; also elsewhere on the board
/Auxiliary Card/AUX.RST: J11.52 (~PERST0); also elsewhere on the board
/Auxiliary Card/AUX_1V8: C68.1, SW7.3, SW8.3, U13.6 (VOUT2)
/Auxiliary Card/AUX_CTS_1V8: J11.34 (UART_CTS), TP56.1, U14.4 (A3)
/Auxiliary Card/AUX_GPIO1_1V8: J11.38 (VENDOR_DEFINED), U15.2 (A1)
/Auxiliary Card/AUX_GPIO2_1V8: J11.40 (VENDOR_DEFINED), U15.3 (A2)
/Auxiliary Card/AUX_GPIO3_1V8: J11.42 (VENDOR_DEFINED), U15.4 (A3)
/Auxiliary Card/AUX_GPIO_VCCA: C73.1, SW8.2, U15.1 (VCCA), U15.12 (OE)
/Auxiliary Card/AUX_RTS_1V8: J11.36 (UART_RTS), TP58.1, U14.5 (A4)
/Auxiliary Card/AUX_RXD_1V8: J11.22 (UART_RXD), TP52.1, U14.1 (A1)
/Auxiliary Card/AUX_RXD_3V3: R47.2, U14.18 (B2)
/Auxiliary Card/AUX_SCL_1V8: J11.60 (I2C_CLK), TP62.1, U14.7 (A6)
/Auxiliary Card/AUX_SDA_1V8: J11.58 (I2C_DATA), TP60.1, U14.6 (A5)
/Auxiliary Card/AUX_SIG_VCCA: C71.1, SW7.2, U14.2 (VCCA), U14.10 (OE)
/Auxiliary Card/AUX_TXD_1V8: J11.32 (UART_TXD), TP54.1, U14.3 (A2)
/Auxiliary Card/AUX_TXD_3V3: R47.4, U14.20 (B1)
/Auxiliary Card/AUX_VDD: C69.1, C72.1, C74.1, D10.1, J11.2 (3.3V), J11.4 (3.3V), J11.72 (3.3V), J11.74 (3.3V), SW7.1, SW8.1, U13.7 (VOUT1), U14.19 (VCCB), U15.11 (VCCB)
/Auxiliary Card/ON1: R48.2, U13.1 (ON1)
/Auxiliary Card/ON2: R49.2, U13.4 (ON2)
/Auxiliary Card/USART6.CTS: TP57.1, U14.17 (B3); also elsewhere on the board
/Auxiliary Card/USART6.RTS: TP59.1, U14.16 (B4); also elsewhere on the board
/Auxiliary Card/USART6.RX: R47.3, TP55.1; also elsewhere on the board
/Auxiliary Card/USART6.TX: R47.1, TP53.1; also elsewhere on the board
/I2C4.SCL: TP63.1, U14.14 (B6); also elsewhere on the board
/I2C4.SDA: TP61.1, U14.15 (B5); also elsewhere on the board
unnamed: D10.2, R50.1
unnamed: J11.S1 (SHIELD), J11.S2 (SHIELD)
unnamed: JP7.1, R50.2
VSS: C66.2, C67.2, C68.2, C69.2, C70.2, C71.2, C72.2, C73.2, C74.2, J11.1 (GND), J11.7 (GND), J11.18 (GND), J11.33 (GND), J11.39 (GND), J11.45 (GND), J11.51 (GND), J11.57 (GND), J11.63 (GND), J11.69 (GND), J11.75 (GND), J12.1, J13.1, JP7.2, TP64.1, TP65.1, TP66.1, TP67.1, U13.5 (GND), U14.11 (GND), U14.21 (GND_Pad), U15.6 (GND); also elsewhere on the board

Notes on the sheet:
GPIO Voltage Selection
I2C/USART Level Shifting
I2C/USART Voltage Selection
GPIO Level Shifting

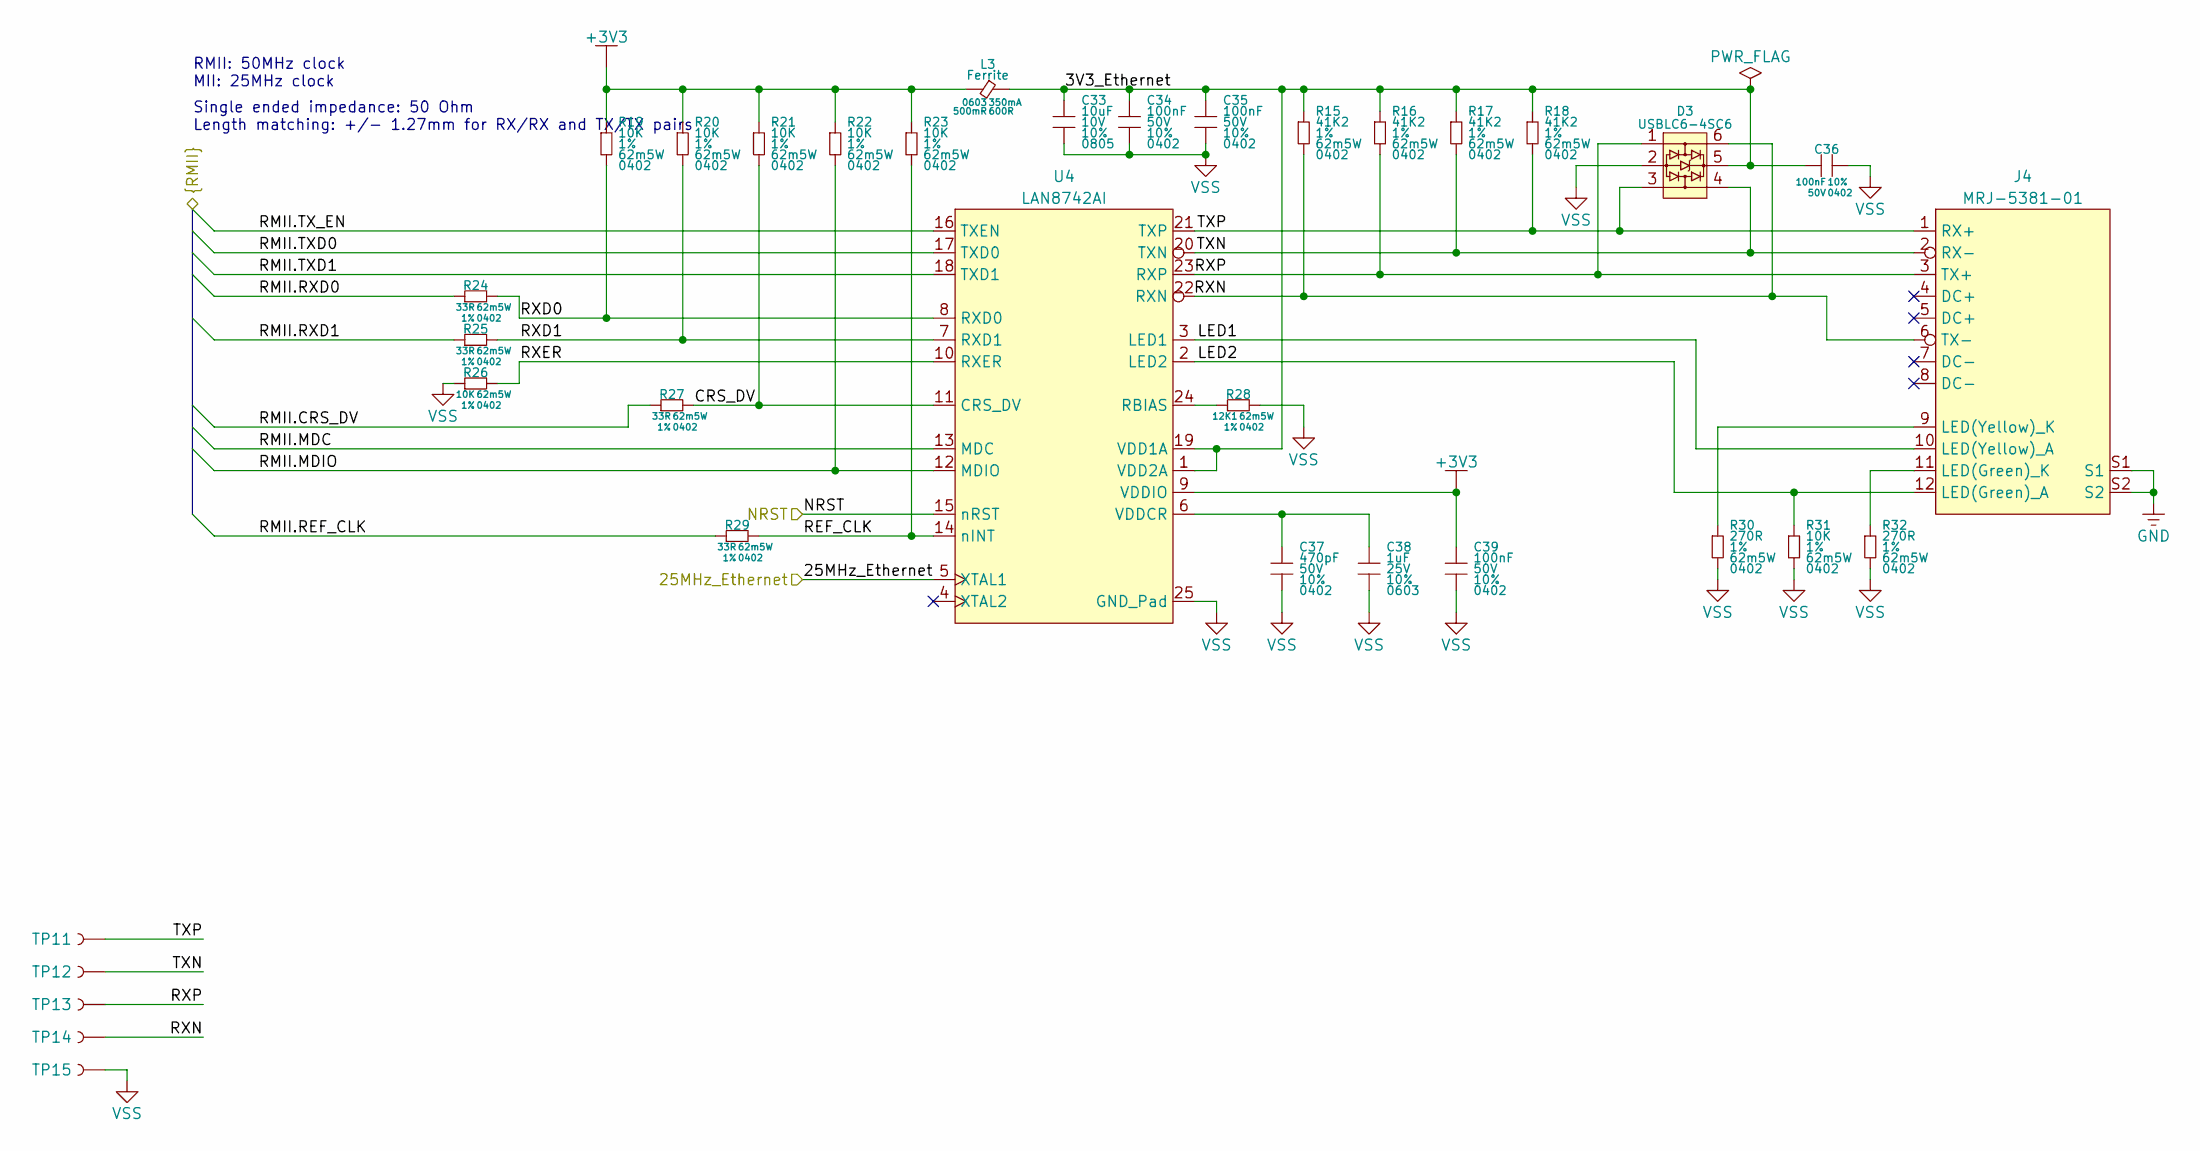
[picture p41: schematic ethernet.kicad_sch]

Parts:
C33: 10uF; GCM0805; Tolerance 10%; Voltage Rating 10V; MPN GCM21BR71A106KE22L
C34, C35, C36, C39: 100nF; GCM0402; Tolerance 10%; Voltage Rating 50V; MPN GRT155R71H104KE01D
C37: 470pF; GCM0402; Tolerance 10%; Voltage Rating 50V; MPN GRT155R71H471KE01D
C38: 1uF; GRT0603; Tolerance 10%; Voltage Rating 25V; MPN GRT188R71E105KE13D
D3: USBLC6-4SC6; SOT2395P280X145-6; MPN USBLC6-4SC6
J4: MRJ-5381-01; MJR-5381-X1; MPN MRJ-5381-01
L3: Ferrite; L_0603; Current Rating 350mA; MPN MFBA3V1608K-601-R
R15, R16, R17, R18: 41K2; CRCW0402; Tolerance 1%; Power Rating 62m5W; MPN CRCW040241R2FKED
R19, R20, R21, R22, R23, R26, R31: 10K; CRCW0402; Tolerance 1%; Power Rating 62m5W; MPN CRCW040210K0FKED
R24, R25, R27, R29: 33R; CRCW0402; Tolerance 1%; Power Rating 62m5W; MPN CRCW040233R0FKED
R28: 12K1; CRCW0402; Tolerance 1%; Power Rating 62m5W; MPN CRCW040212K1FKED
R30, R32: 270R; CRCW0402; Tolerance 1%; Power Rating 62m5W; MPN CRCW0402270RFKED
TP11, TP12, TP13, TP14: TP_2mm; MPN N/A
TP15: RCWCTE; TP_RCW; MPN RCWCTE
U4: LAN8742AI; QFN50P400X400X90-24; MPN LAN8742AI-CZ-TR

Connections:
+3V3: C39.1, L3.1, R19.1, R20.1, R21.1, R22.1, R23.1, U4.9 (VDDIO); also elsewhere on the board
/Ethernet/3V3_Ethernet: C33.1, C34.1, C35.1, C36.1, D3.5 (VBUS), L3.2, R15.1, R16.1, R17.1, R18.1, U4.1 (VDD2A), U4.19 (VDD1A)
/Ethernet/25MHz_Ethernet: U4.5 (XTAL1); also elsewhere on the board
/Ethernet/CRS_DV: R21.2, R27.2, U4.11 (CRS_DV)
/Ethernet/LED1: J4.10 (LED(Yellow)_A), U4.3 (LED1)
/Ethernet/LED2: J4.12 (LED(Green)_A), R31.1, U4.2 (LED2)
/Ethernet/REF_CLK: R23.2, R29.2, U4.14 (nINT)
/Ethernet/RMII.CRS_DV: R27.1; also elsewhere on the board
/Ethernet/RMII.MDC: U4.13 (MDC); also elsewhere on the board
/Ethernet/RMII.MDIO: R22.2, U4.12 (MDIO); also elsewhere on the board
/Ethernet/RMII.REF_CLK: R29.1; also elsewhere on the board
/Ethernet/RMII.RXD0: R24.1; also elsewhere on the board
/Ethernet/RMII.RXD1: R25.1; also elsewhere on the board
/Ethernet/RMII.TXD0: U4.17 (TXD0); also elsewhere on the board
/Ethernet/RMII.TXD1: U4.18 (TXD1); also elsewhere on the board
/Ethernet/RMII.TX_EN: U4.16 (TXEN); also elsewhere on the board
/Ethernet/RXD0: R19.2, R24.2, U4.8 (RXD0)
/Ethernet/RXD1: R20.2, R25.2, U4.7 (RXD1)
/Ethernet/RXER: R26.2, U4.10 (RXER)
/Ethernet/RXN: D3.6 (OUT1), J4.6 (TX-), R15.2, TP14.1, U4.22 (RXN)
/Ethernet/RXP: D3.1 (IN1), J4.3 (TX+), R16.2, TP13.1, U4.23 (RXP)
/Ethernet/TXN: D3.4 (OUT2), J4.2 (RX-), R17.2, TP12.1, U4.20 (TXN)
/Ethernet/TXP: D3.3 (IN2), J4.1 (RX+), R18.2, TP11.1, U4.21 (TXP)
/H7_NRST: U4.15 (nRST); also elsewhere on the board
GND: J4.S1, J4.S2; also elsewhere on the board
unnamed: J4.11 (LED(Green)_K), R32.1
unnamed: J4.9 (LED(Yellow)_K), R30.1
unnamed: R28.1, U4.24 (RBIAS)
unnamed: C37.1, C38.1, U4.6 (VDDCR)
VSS: C33.2, C34.2, C35.2, C36.2, C37.2, C38.2, C39.2, D3.2 (GND), R26.1, R28.2, R30.2, R31.2, R32.2, TP15.1, U4.25 (GND_Pad); also elsewhere on the board

Notes on the sheet:
RMII: 50MHz clock MII: 25MHz clock
Single ended impedance: 50 Ohm Length matching: +/- 1.27mm for RX/RX and TX/TX pairs

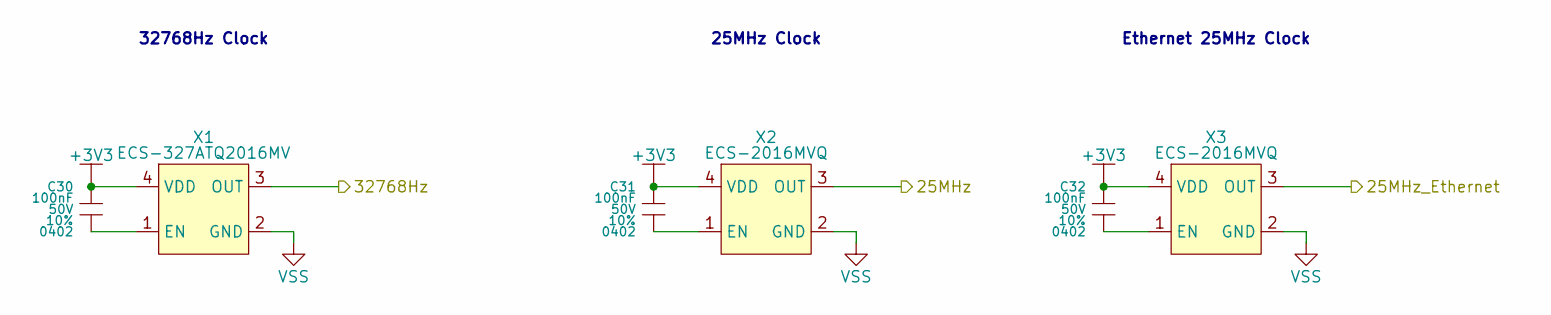
[picture p42: schematic clocks.kicad_sch]

Parts:
C30, C31, C32: 100nF; GCM0402; Tolerance 10%; Voltage Rating 50V; MPN GRT155R71H104KE01D
X1: ECS-327ATQ2016MV; ECS-xxxATQ2016MV; MPN ECS-327ATQ2016MV-BS-TR
X2, X3: ECS-2016MVQ; ECS-2016MV; MPN ECS-2016MVQ-250-CN-TR

Connections:
+3V3: C30.1, C31.1, C32.1, X1.4 (VDD), X2.4 (VDD), X3.4 (VDD); also elsewhere on the board
/Ethernet/25MHz_Ethernet: X3.3 (OUT); also elsewhere on the board
/STM32H745/25MHz: X2.3 (OUT); also elsewhere on the board
/STM32H745/32768Hz: X1.3 (OUT); also elsewhere on the board
unnamed: C30.2, X1.1 (EN)
unnamed: C31.2, X2.1 (EN)
unnamed: C32.2, X3.1 (EN)
VSS: X1.2 (GND), X2.2 (GND), X3.2 (GND); also elsewhere on the board

Notes on the sheet:
25MHz Clock
32768Hz Clock
Ethernet 25MHz Clock

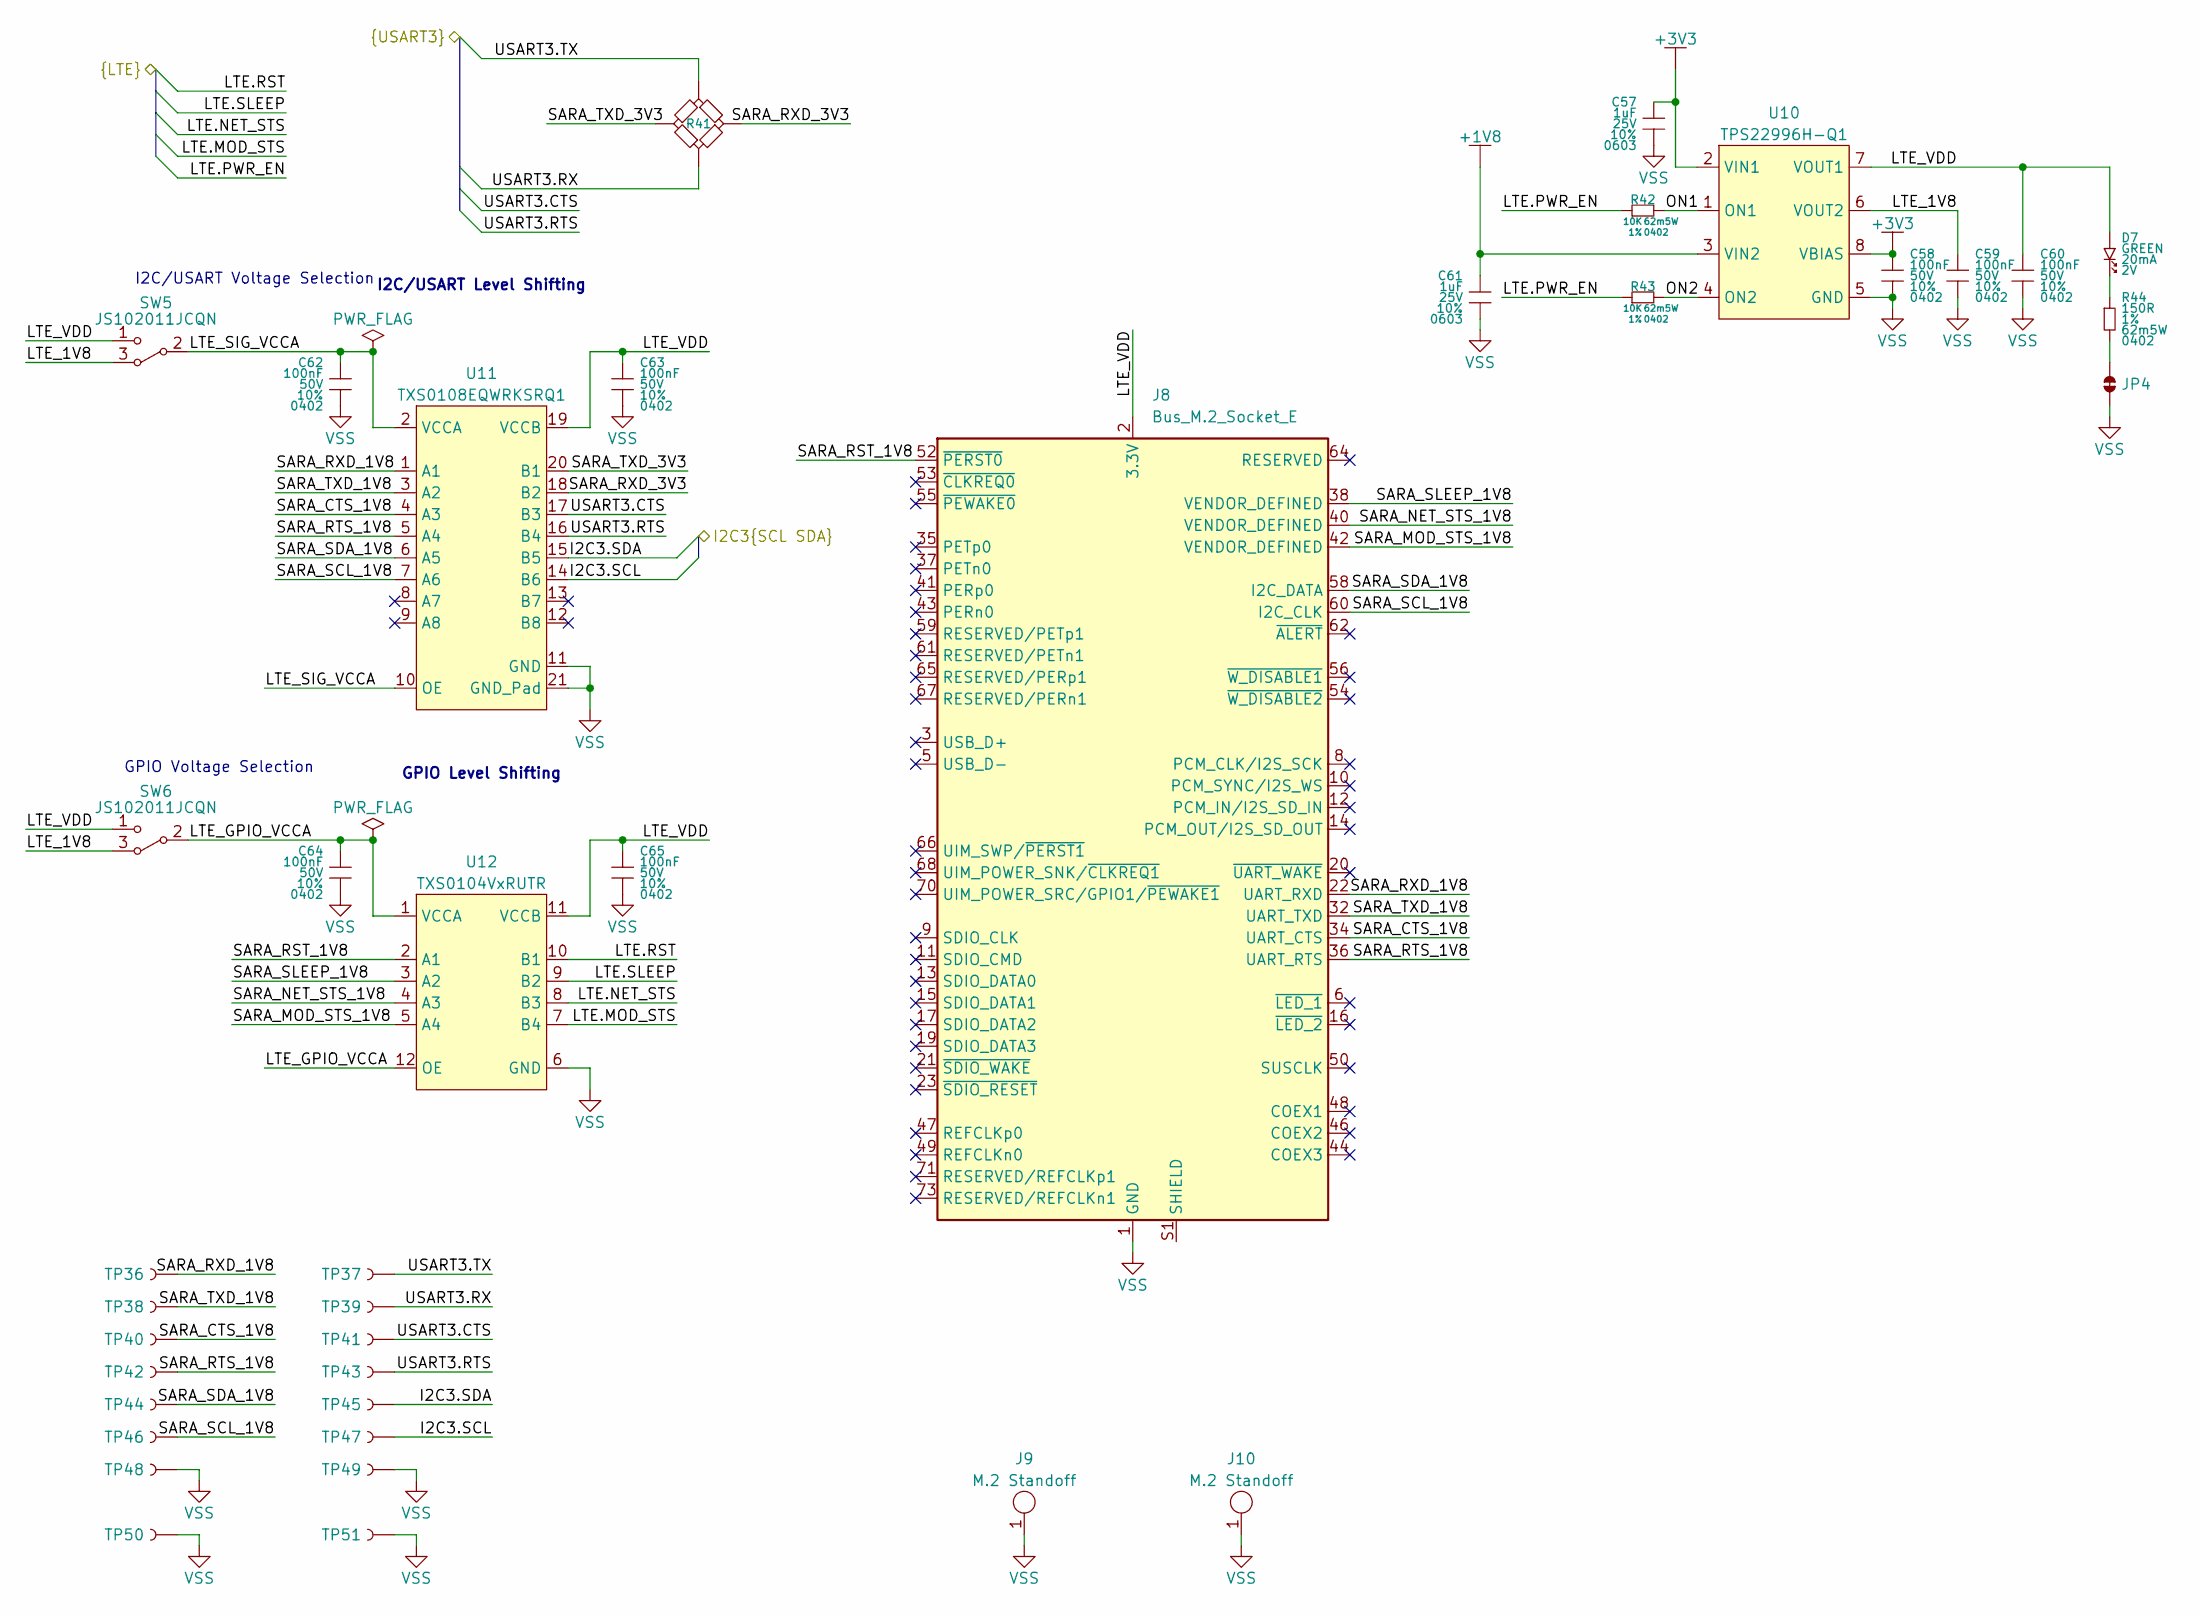
[picture p43: schematic lte.kicad_sch, LTE Card]

Parts:
C57, C61: 1uF; GRT0603; Tolerance 10%; Voltage Rating 25V; MPN GRT188R71E105KE13D
C58, C59, C60, C62, C63, C64, C65: 100nF; GCM0402; Tolerance 10%; Voltage Rating 50V; MPN GRT155R71H104KE01D
D7: LTST-C191KGKT; LTST-0603; Forward Voltage 2V; MPN LTST-C191KGKT
J8: Bus_M.2_Socket_E; MDT420E01001; MPN MDT420E01001
J9, J10: M.2 Standoff; MountingHole_3.5mm_Pad_Via; MPN 123A-NUT-42
JP4: SolderJumper-2_P1.3mm_Bridged_RoundedPad1.0x1.5mm
R41: CRCW0402_QUAD_UART
R42, R43: 10K; CRCW0402; Tolerance 1%; Power Rating 62m5W; MPN CRCW040210K0FKED
R44: 150R; CRCW0402; Tolerance 1%; Power Rating 62m5W; MPN CRCW0402150RFKED
SW5, SW6: JS102011JCQN; MPN C&K
TP36, TP37, TP38, TP39, TP40, TP41, TP42, TP43, TP44, TP45, TP46, TP47: TP_2mm; MPN N/A
TP48, TP49, TP50, TP51: RCWCTE; TP_RCW; MPN RCWCTE
U10: TPS22996H-Q1; SOT583; MPN TPS22996HQDYCRQ1
U11: TXS0108EQWRKSRQ1; QFN50P450X250X100-20; MPN TXS0108EQWRKSRQ1
U12: TXS0104VxRUTR; QFN40P170X200X55-12; MPN TXS0104VQRUTRQ1

Connections:
+1V8: C61.1, U10.3 (VIN2); also elsewhere on the board
+3V3: C57.1, C58.1, U10.2 (VIN1), U10.8 (VBIAS); also elsewhere on the board
/I2C3.SCL: TP47.1, U11.14 (B6); also elsewhere on the board
/I2C3.SDA: TP45.1, U11.15 (B5); also elsewhere on the board
/LTE Card/LTE.MOD_STS: U12.7 (B4); also elsewhere on the board
/LTE Card/LTE.NET_STS: U12.8 (B3); also elsewhere on the board
/LTE Card/LTE.PWR_EN: R42.1, R43.1; also elsewhere on the board
/LTE Card/LTE.RST: U12.10 (B1); also elsewhere on the board
/LTE Card/LTE.SLEEP: U12.9 (B2); also elsewhere on the board
/LTE Card/LTE_1V8: C59.1, SW5.3, SW6.3, U10.6 (VOUT2)
/LTE Card/LTE_GPIO_VCCA: C64.1, SW6.2, U12.1 (VCCA), U12.12 (OE)
/LTE Card/LTE_SIG_VCCA: C62.1, SW5.2, U11.2 (VCCA), U11.10 (OE)
/LTE Card/LTE_VDD: C60.1, C63.1, C65.1, D7.1, J8.2 (3.3V), J8.4 (3.3V), J8.72 (3.3V), J8.74 (3.3V), SW5.1, SW6.1, U10.7 (VOUT1), U11.19 (VCCB), U12.11 (VCCB)
/LTE Card/ON1: R42.2, U10.1 (ON1)
/LTE Card/ON2: R43.2, U10.4 (ON2)
/LTE Card/SARA_CTS_1V8: J8.34 (UART_CTS), TP40.1, U11.4 (A3)
/LTE Card/SARA_MOD_STS_1V8: J8.42 (VENDOR_DEFINED), U12.5 (A4)
/LTE Card/SARA_NET_STS_1V8: J8.40 (VENDOR_DEFINED), U12.4 (A3)
/LTE Card/SARA_RST_1V8: J8.52 (~PERST0), U12.2 (A1)
/LTE Card/SARA_RTS_1V8: J8.36 (UART_RTS), TP42.1, U11.5 (A4)
/LTE Card/SARA_RXD_1V8: J8.22 (UART_RXD), TP36.1, U11.1 (A1)
/LTE Card/SARA_RXD_3V3: R41.2, U11.18 (B2)
/LTE Card/SARA_SCL_1V8: J8.60 (I2C_CLK), TP46.1, U11.7 (A6)
/LTE Card/SARA_SDA_1V8: J8.58 (I2C_DATA), TP44.1, U11.6 (A5)
/LTE Card/SARA_SLEEP_1V8: J8.38 (VENDOR_DEFINED), U12.3 (A2)
/LTE Card/SARA_TXD_1V8: J8.32 (UART_TXD), TP38.1, U11.3 (A2)
/LTE Card/SARA_TXD_3V3: R41.4, U11.20 (B1)
/LTE Card/USART3.CTS: TP41.1, U11.17 (B3); also elsewhere on the board
/LTE Card/USART3.RTS: TP43.1, U11.16 (B4); also elsewhere on the board
/LTE Card/USART3.RX: R41.3, TP39.1; also elsewhere on the board
/LTE Card/USART3.TX: R41.1, TP37.1; also elsewhere on the board
unnamed: D7.2, R44.1
unnamed: J8.S1 (SHIELD), J8.S2 (SHIELD)
unnamed: JP4.1, R44.2
VSS: C57.2, C58.2, C59.2, C60.2, C61.2, C62.2, C63.2, C64.2, C65.2, J8.1 (GND), J8.7 (GND), J8.18 (GND), J8.33 (GND), J8.39 (GND), J8.45 (GND), J8.51 (GND), J8.57 (GND), J8.63 (GND), J8.69 (GND), J8.75 (GND), J9.1, J10.1, JP4.2, TP48.1, TP49.1, TP50.1, TP51.1, U10.5 (GND), U11.11 (GND), U11.21 (GND_Pad), U12.6 (GND); also elsewhere on the board

Notes on the sheet:
I2C/USART Voltage Selection
I2C/USART Level Shifting
GPIO Voltage Selection
GPIO Level Shifting

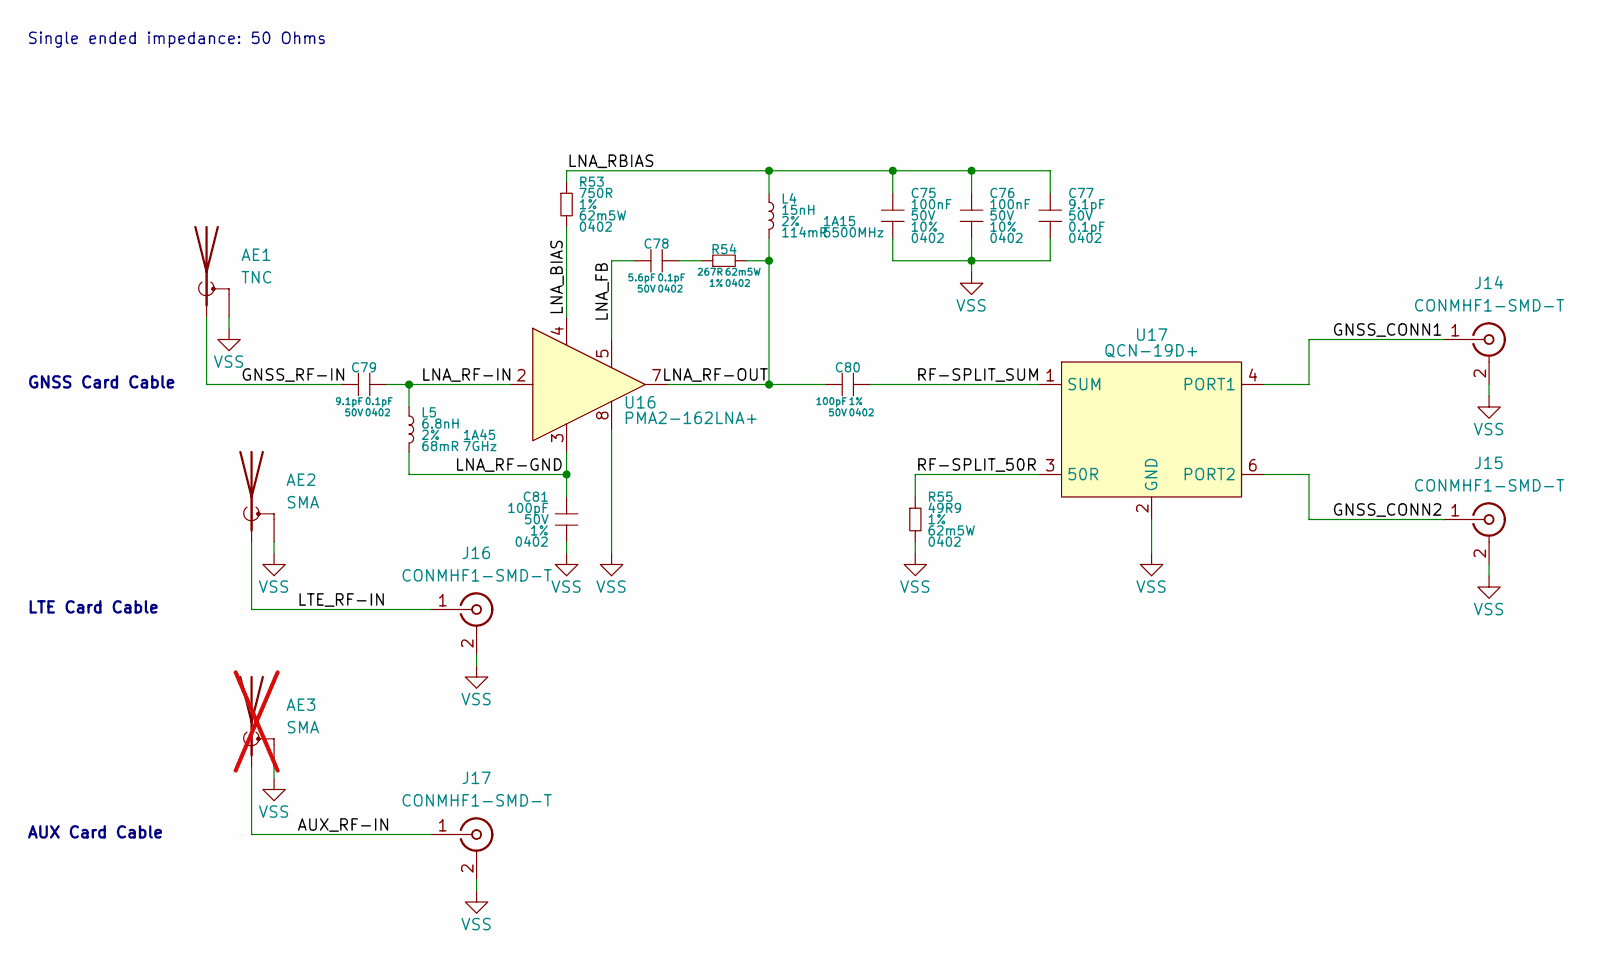
[picture p44: schematic rfInterface.kicad_sch, RF Interface]

Parts:
AE1: TNC; RFPC-TNC01-FN; MPN RFPC-TNC01-FN-A
AE2: SMA; RFPC-SMA14-FN; MPN RFPC-SMA14-FN-A
AE3: SMA; RFPC-SMA14-FN; MPN RFPC-SMA14-FN-A; not fitted
C75, C76: 100nF; GCM0402; Tolerance 10%; Voltage Rating 50V; MPN GRT155R71H104KE01D
C77, C79: 9.1pF; GCM0402; Tolerance 0.1pF; Voltage Rating 50V; MPN GCM1555C1H9R1BA16D
C78: 5.6pF; GCM0402; Tolerance 0.1pF; Voltage Rating 50V; MPN GCM1555C1H5R6BA16D
C80, C81: 100pF; GCM0402; Tolerance 1%; Voltage Rating 50V; MPN GCM1555C1H101FA16D
J14, J15, J16, J17: CONMHF1-SMD-T; CONMHF1; MPN CONMHF1-SMD-T
L4: 15nH; L_0402; Tolerance 2%; Current Rating 1A15; MPN LQW15AN15NG8ZD
L5: 6.8nH; L_0402; Tolerance 2%; Current Rating 1A45; MPN LQW15AN6N8G8ZD
R53: 750R; CRCW0402; Tolerance 1%; Power Rating 62m5W; MPN CRCW0402750RFKED
R54: 267R; CRCW0402; Tolerance 1%; Power Rating 62m5W; MPN CRCW0402267RFKED
R55: 49R9; CRCW0402; Tolerance 1%; Power Rating 62m5W; MPN CRCW040249R9FKED
U16: PMA2-162LNA+; TFDFN200X200X100-8; MPN PMA2-162LNA+
U17: QCN-19D+; SON99P320X160X89-6; MPN QCN-19D+

Connections:
/RF Interface/AUX_RF-IN: AE3.1 (A), J17.1 (In)
/RF Interface/GNSS_CONN1: J14.1 (In), U17.4 (PORT1)
/RF Interface/GNSS_CONN2: J15.1 (In), U17.6 (PORT2)
/RF Interface/GNSS_RF-IN: AE1.1 (A), C79.1
/RF Interface/LNA_BIAS: R53.2, U16.4 (BIAS)
/RF Interface/LNA_FB: C78.1, U16.5 (FB)
/RF Interface/LNA_RBIAS: C75.1, C76.1, C77.1, L4.1, R53.1
/RF Interface/LNA_RF-GND: C81.1, L5.2, U16.3 (RF-GND)
/RF Interface/LNA_RF-IN: C79.2, L5.1, U16.2 (RF-IN)
/RF Interface/LNA_RF-OUT: C80.1, L4.2, R54.2, U16.7 (RF-OUT)
/RF Interface/LTE_RF-IN: AE2.1 (A), J16.1 (In)
/RF Interface/RF-SPLIT_50R: R55.1, U17.3 (50R)
/RF Interface/RF-SPLIT_SUM: C80.2, U17.1 (SUM)
unnamed: C78.2, R54.1
VSS: AE1.2 (Shield), AE1.3 (Shield), AE1.4 (Shield), AE1.5 (Shield), AE2.2 (Shield), AE2.3 (Shield), AE2.4 (Shield), AE2.5 (Shield), AE3.2 (Shield), AE3.3 (Shield), AE3.4 (Shield), AE3.5 (Shield), C75.2, C76.2, C77.2, C81.2, J14.2 (Ext), J15.2 (Ext), J16.2 (Ext), J17.2 (Ext), R55.2, U16.1 (NC), U16.6 (NC), U16.8 (GND), U16.9 (GND), U17.2 (GND), U17.5 (GND); also elsewhere on the board

Notes on the sheet:
GNSS Card Cable
LTE Card Cable
Single ended impedance: 50 Ohms
AUX Card Cable
