DeepSpace00/Awohali/hardware/electronics/mainBoard/mainBoard.kicad_pcb

## KiCad design hardware/electronics/mainBoard/mainBoard.kicad_pcb (continued)

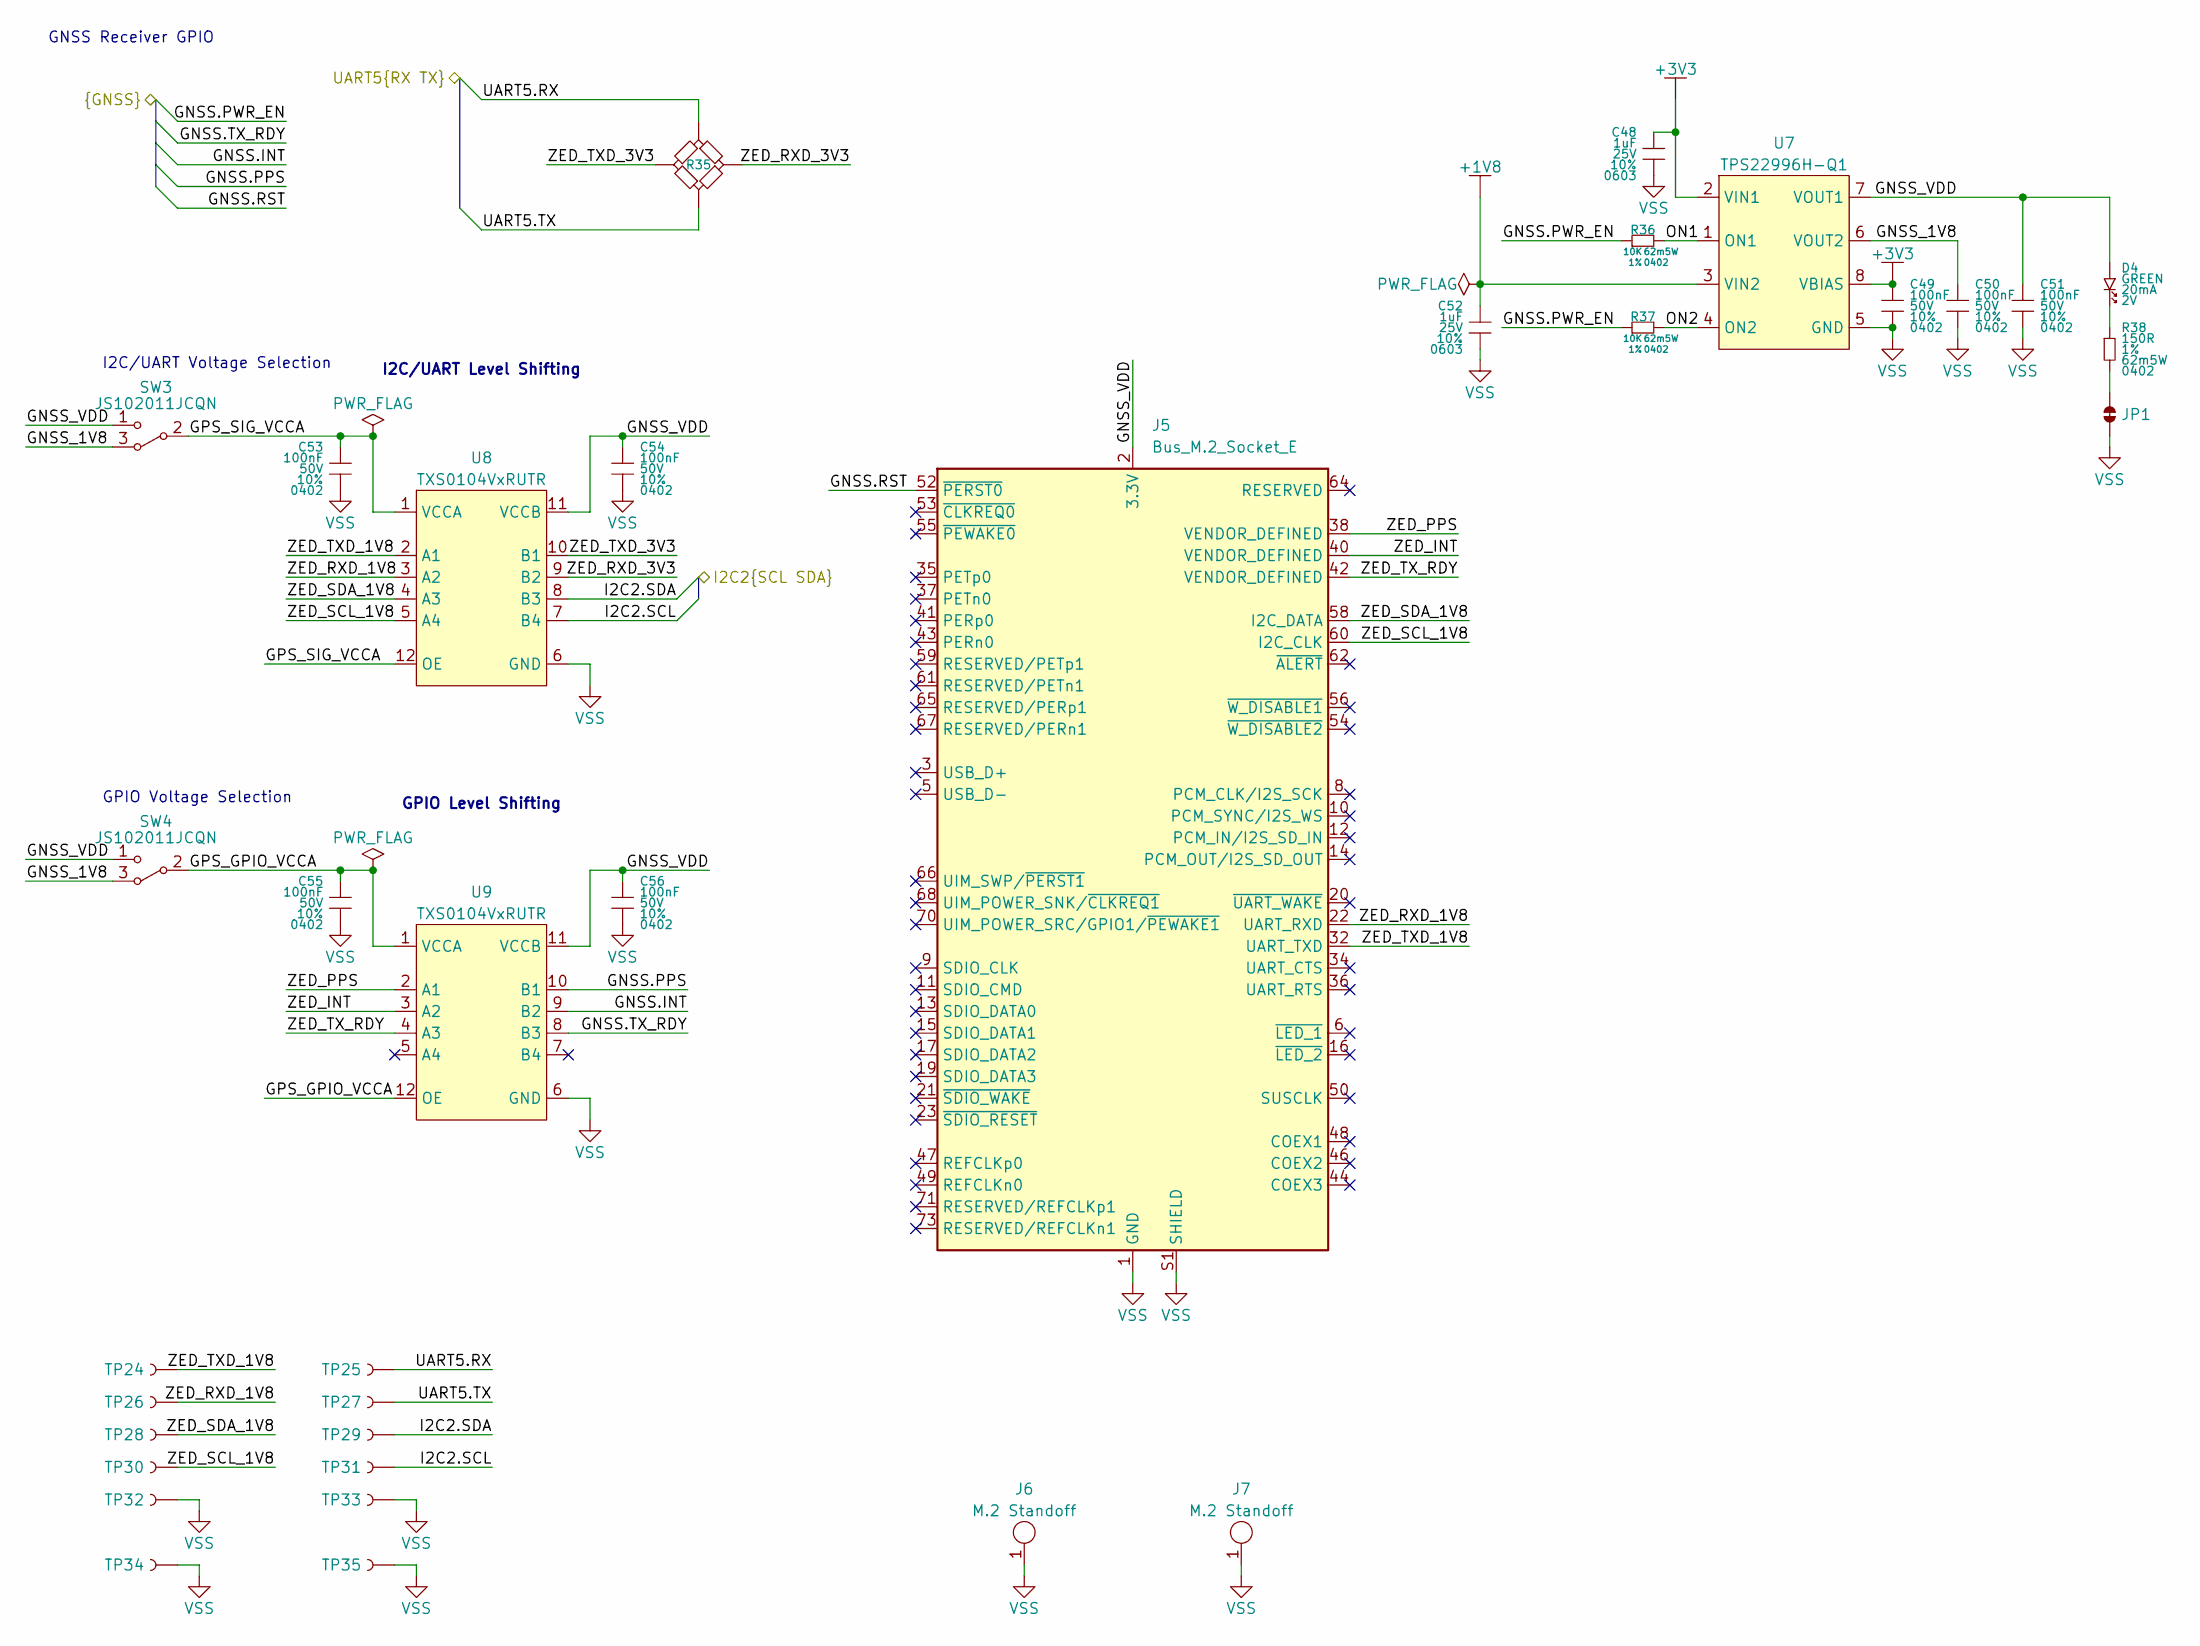
[picture p45: schematic gnss.kicad_sch, GNSS Card]

Parts:
C48, C52: 1uF; GRT0603; Tolerance 10%; Voltage Rating 25V; MPN GRT188R71E105KE13D
C49, C50, C51, C53, C54, C55, C56: 100nF; GCM0402; Tolerance 10%; Voltage Rating 50V; MPN GRT155R71H104KE01D
D4: LTST-C191KGKT; LTST-0603; Forward Voltage 2V; MPN LTST-C191KGKT
J5: Bus_M.2_Socket_E; MDT420E01001; MPN MDT420E01001
J6, J7: M.2 Standoff; MountingHole_3.5mm_Pad_Via; MPN 123A-NUT-42
JP1: SolderJumper-2_P1.3mm_Bridged_RoundedPad1.0x1.5mm
R35: CRCW0402_QUAD_UART
R36, R37: 10K; CRCW0402; Tolerance 1%; Power Rating 62m5W; MPN CRCW040210K0FKED
R38: 150R; CRCW0402; Tolerance 1%; Power Rating 62m5W; MPN CRCW0402150RFKED
SW3, SW4: JS102011JCQN; MPN C&K
TP24, TP25, TP26, TP27, TP28, TP29, TP30, TP31: TP_2mm; MPN N/A
TP32, TP33, TP34, TP35: RCWCTE; TP_RCW; MPN RCWCTE
U7: TPS22996H-Q1; SOT583; MPN TPS22996HQDYCRQ1
U8, U9: TXS0104VxRUTR; QFN40P170X200X55-12; MPN TXS0104VQRUTRQ1

Connections:
+1V8: C52.1, U7.3 (VIN2); also elsewhere on the board
+3V3: C48.1, C49.1, U7.2 (VIN1), U7.8 (VBIAS); also elsewhere on the board
/GNSS Card/GNSS.INT: U9.9 (B2); also elsewhere on the board
/GNSS Card/GNSS.PPS: U9.10 (B1); also elsewhere on the board
/GNSS Card/GNSS.PWR_EN: R36.1, R37.1; also elsewhere on the board
/GNSS Card/GNSS.RST: J5.52 (~PERST0); also elsewhere on the board
/GNSS Card/GNSS.TX_RDY: U9.8 (B3); also elsewhere on the board
/GNSS Card/GNSS_1V8: C50.1, SW3.3, SW4.3, U7.6 (VOUT2)
/GNSS Card/GNSS_VDD: C51.1, C54.1, C56.1, D4.1, J5.2 (3.3V), J5.4 (3.3V), J5.72 (3.3V), J5.74 (3.3V), SW3.1, SW4.1, U7.7 (VOUT1), U8.11 (VCCB), U9.11 (VCCB)
/GNSS Card/GPS_GPIO_VCCA: C55.1, SW4.2, U9.1 (VCCA), U9.12 (OE)
/GNSS Card/GPS_SIG_VCCA: C53.1, SW3.2, U8.1 (VCCA), U8.12 (OE)
/GNSS Card/ON1: R36.2, U7.1 (ON1)
/GNSS Card/ON2: R37.2, U7.4 (ON2)
/GNSS Card/UART5.RX: R35.1, TP25.1; also elsewhere on the board
/GNSS Card/UART5.TX: R35.3, TP27.1; also elsewhere on the board
/GNSS Card/ZED_INT: J5.40 (VENDOR_DEFINED), U9.3 (A2)
/GNSS Card/ZED_PPS: J5.38 (VENDOR_DEFINED), U9.2 (A1)
/GNSS Card/ZED_RXD_1V8: J5.22 (UART_RXD), TP26.1, U8.3 (A2)
/GNSS Card/ZED_RXD_3V3: R35.2, U8.9 (B2)
/GNSS Card/ZED_SCL_1V8: J5.60 (I2C_CLK), TP30.1, U8.5 (A4)
/GNSS Card/ZED_SDA_1V8: J5.58 (I2C_DATA), TP28.1, U8.4 (A3)
/GNSS Card/ZED_TXD_1V8: J5.32 (UART_TXD), TP24.1, U8.2 (A1)
/GNSS Card/ZED_TXD_3V3: R35.4, U8.10 (B1)
/GNSS Card/ZED_TX_RDY: J5.42 (VENDOR_DEFINED), U9.4 (A3)
/I2C2.SCL: TP31.1, U8.7 (B4); also elsewhere on the board
/I2C2.SDA: TP29.1, U8.8 (B3); also elsewhere on the board
unnamed: D4.2, R38.1
unnamed: JP1.1, R38.2
VSS: C48.2, C49.2, C50.2, C51.2, C52.2, C53.2, C54.2, C55.2, C56.2, J5.1 (GND), J5.7 (GND), J5.18 (GND), J5.33 (GND), J5.39 (GND), J5.45 (GND), J5.51 (GND), J5.57 (GND), J5.63 (GND), J5.69 (GND), J5.75 (GND), J5.S1 (SHIELD), J5.S2 (SHIELD), J6.1, J7.1, JP1.2, TP32.1, TP33.1, TP34.1, TP35.1, U7.5 (GND), U8.6 (GND), U9.6 (GND); also elsewhere on the board

Notes on the sheet:
I2C/UART Voltage Selection
GPIO Level Shifting
GNSS Receiver GPIO
GPIO Voltage Selection
I2C/UART Level Shifting

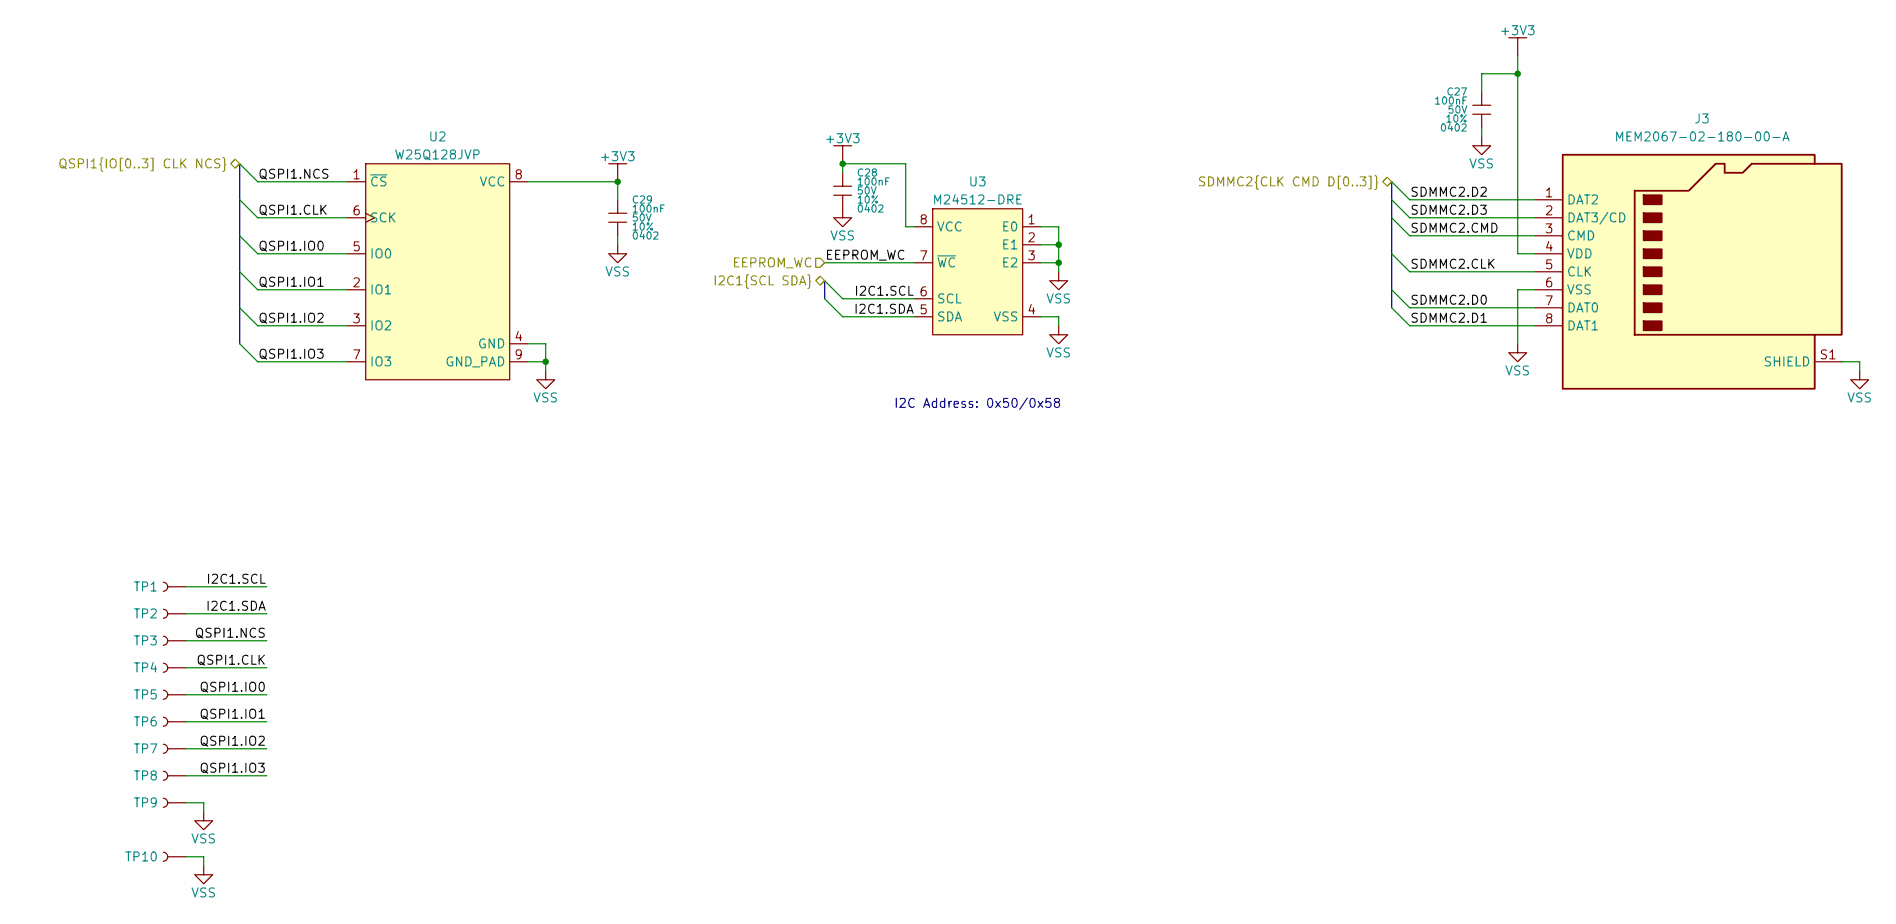
[picture p46: schematic memory.kicad_sch]

Parts:
C27, C28, C29: 100nF; GCM0402; Tolerance 10%; Voltage Rating 50V; MPN GRT155R71H104KE01D
J3: MEM2067-02-180-00-A; MPN MEM2067-02-180-00-A
TP1, TP2, TP3, TP4, TP5, TP6, TP7, TP8: TP_2mm; MPN N/A
TP9, TP10: RCWCTE; TP_RCW; MPN RCWCTE
U2: W25Q128JVP; WFDFN8P127_600X500X75L60X40N; MPN W25Q128JVPIQ
U3: M24512-DRE; SOIC127P600x175-8; MPN M24512-DRMN8TP/K

Connections:
+3V3: C27.1, C28.1, C29.1, J3.4 (VDD), U2.8 (VCC), U3.8 (VCC); also elsewhere on the board
/I2C1.SCL: TP1.1, U3.6 (SCL); also elsewhere on the board
/I2C1.SDA: TP2.1, U3.5 (SDA); also elsewhere on the board
/Memory/EEPROM_WC: U3.7 (~WC); also elsewhere on the board
/Memory/QSPI1.CLK: TP4.1, U2.6 (SCK); also elsewhere on the board
/Memory/QSPI1.IO0: TP5.1, U2.5 (IO0); also elsewhere on the board
/Memory/QSPI1.IO1: TP6.1, U2.2 (IO1); also elsewhere on the board
/Memory/QSPI1.IO2: TP7.1, U2.3 (IO2); also elsewhere on the board
/Memory/QSPI1.IO3: TP8.1, U2.7 (IO3); also elsewhere on the board
/Memory/QSPI1.NCS: TP3.1, U2.1 (~CS); also elsewhere on the board
/Memory/SDMMC2.CLK: J3.5 (CLK); also elsewhere on the board
/Memory/SDMMC2.CMD: J3.3 (CMD); also elsewhere on the board
/Memory/SDMMC2.D0: J3.7 (DAT0); also elsewhere on the board
/Memory/SDMMC2.D1: J3.8 (DAT1); also elsewhere on the board
/Memory/SDMMC2.D2: J3.1 (DAT2); also elsewhere on the board
/Memory/SDMMC2.D3: J3.2 (DAT3/CD); also elsewhere on the board
VSS: C27.2, C28.2, C29.2, J3.6 (VSS), J3.S1 (SHIELD), J3.S2 (SHIELD), J3.S3 (SHIELD), J3.S4 (SHIELD), TP9.1, TP10.1, U2.4 (GND), U2.9 (GND_PAD), U3.1 (E0), U3.2 (E1), U3.3 (E2), U3.4 (VSS); also elsewhere on the board

Notes on the sheet:
I2C Address: 0x50/0x58

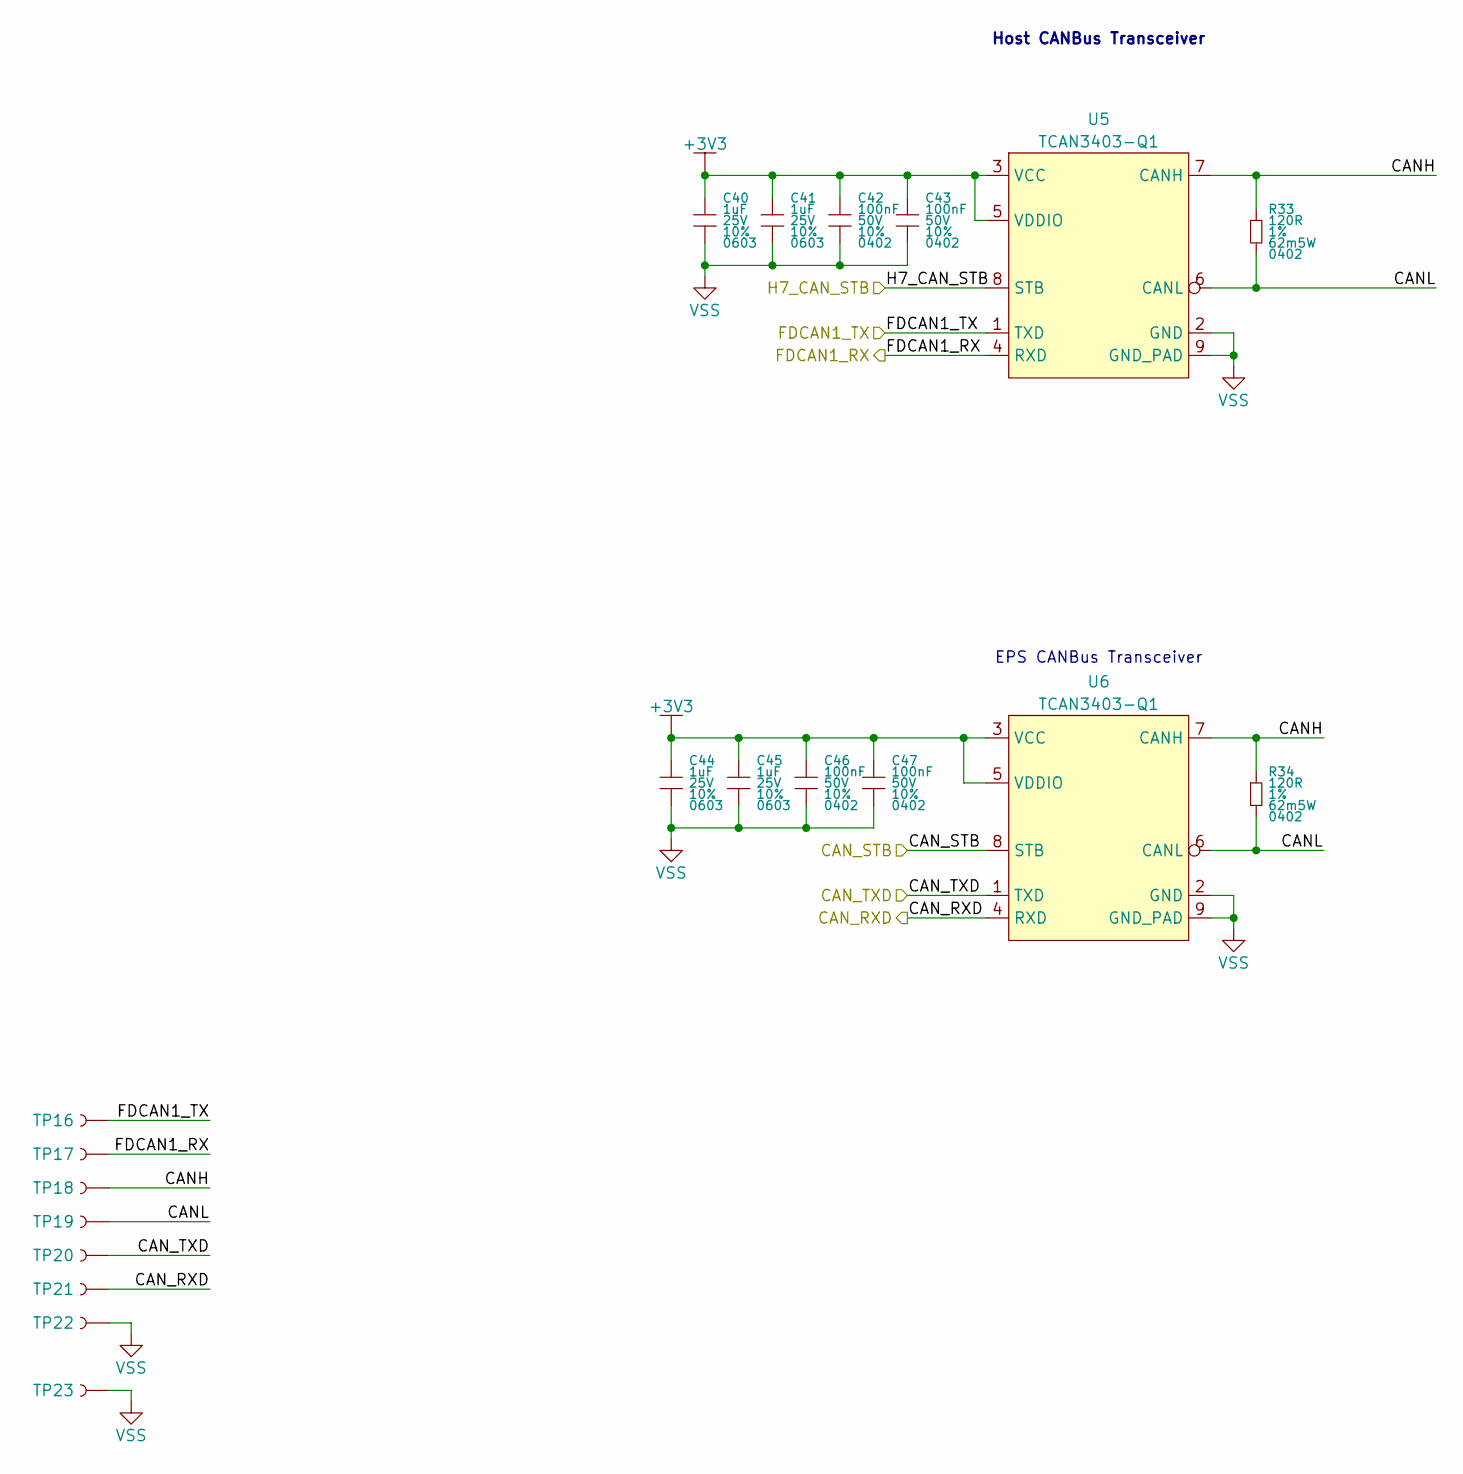
[picture p47: schematic canTransceivers.kicad_sch, CANBus Transceivers]

Parts:
C40, C41, C44, C45: 1uF; GRT0603; Tolerance 10%; Voltage Rating 25V; MPN GRT188R71E105KE13D
C42, C43, C46, C47: 100nF; GCM0402; Tolerance 10%; Voltage Rating 50V; MPN GRT155R71H104KE01D
R33, R34: 120R; CRCW0402; Tolerance 1%; Power Rating 62m5W; MPN CRCW0402120RFKED
TP16, TP17, TP18, TP19, TP20, TP21: TP_2mm; MPN N/A
TP22, TP23: RCWCTE; TP_RCW; MPN RCWCTE
U5, U6: TCAN3403-Q1; SON65P300X300X100-8; MPN TCAN3403DRBRQ1

Connections:
+3V3: C40.1, C41.1, C42.1, C43.1, C44.1, C45.1, C46.1, C47.1, U5.3 (VCC), U5.5 (VDDIO), U6.3 (VCC), U6.5 (VDDIO); also elsewhere on the board
/CANBus Transceivers/CANH: R33.1, R34.1, TP18.1, U5.7 (CANH), U6.7 (CANH)
/CANBus Transceivers/CANL: R33.2, R34.2, TP19.1, U5.6 (CANL), U6.6 (CANL)
/CANBus Transceivers/FDCAN1_RX: TP17.1, U5.4 (RXD); also elsewhere on the board
/CANBus Transceivers/FDCAN1_TX: TP16.1, U5.1 (TXD); also elsewhere on the board
/CANBus Transceivers/H7_CAN_STB: U5.8 (STB); also elsewhere on the board
/CAN_RXD: TP21.1, U6.4 (RXD); also elsewhere on the board
/CAN_STB: U6.8 (STB); also elsewhere on the board
/CAN_TXD: TP20.1, U6.1 (TXD); also elsewhere on the board
VSS: C40.2, C41.2, C42.2, C43.2, C44.2, C45.2, C46.2, C47.2, TP22.1, TP23.1, U5.2 (GND), U5.9 (GND_PAD), U6.2 (GND), U6.9 (GND_PAD); also elsewhere on the board

Notes on the sheet:
EPS CANBus Transceiver
Host CANBus Transceiver

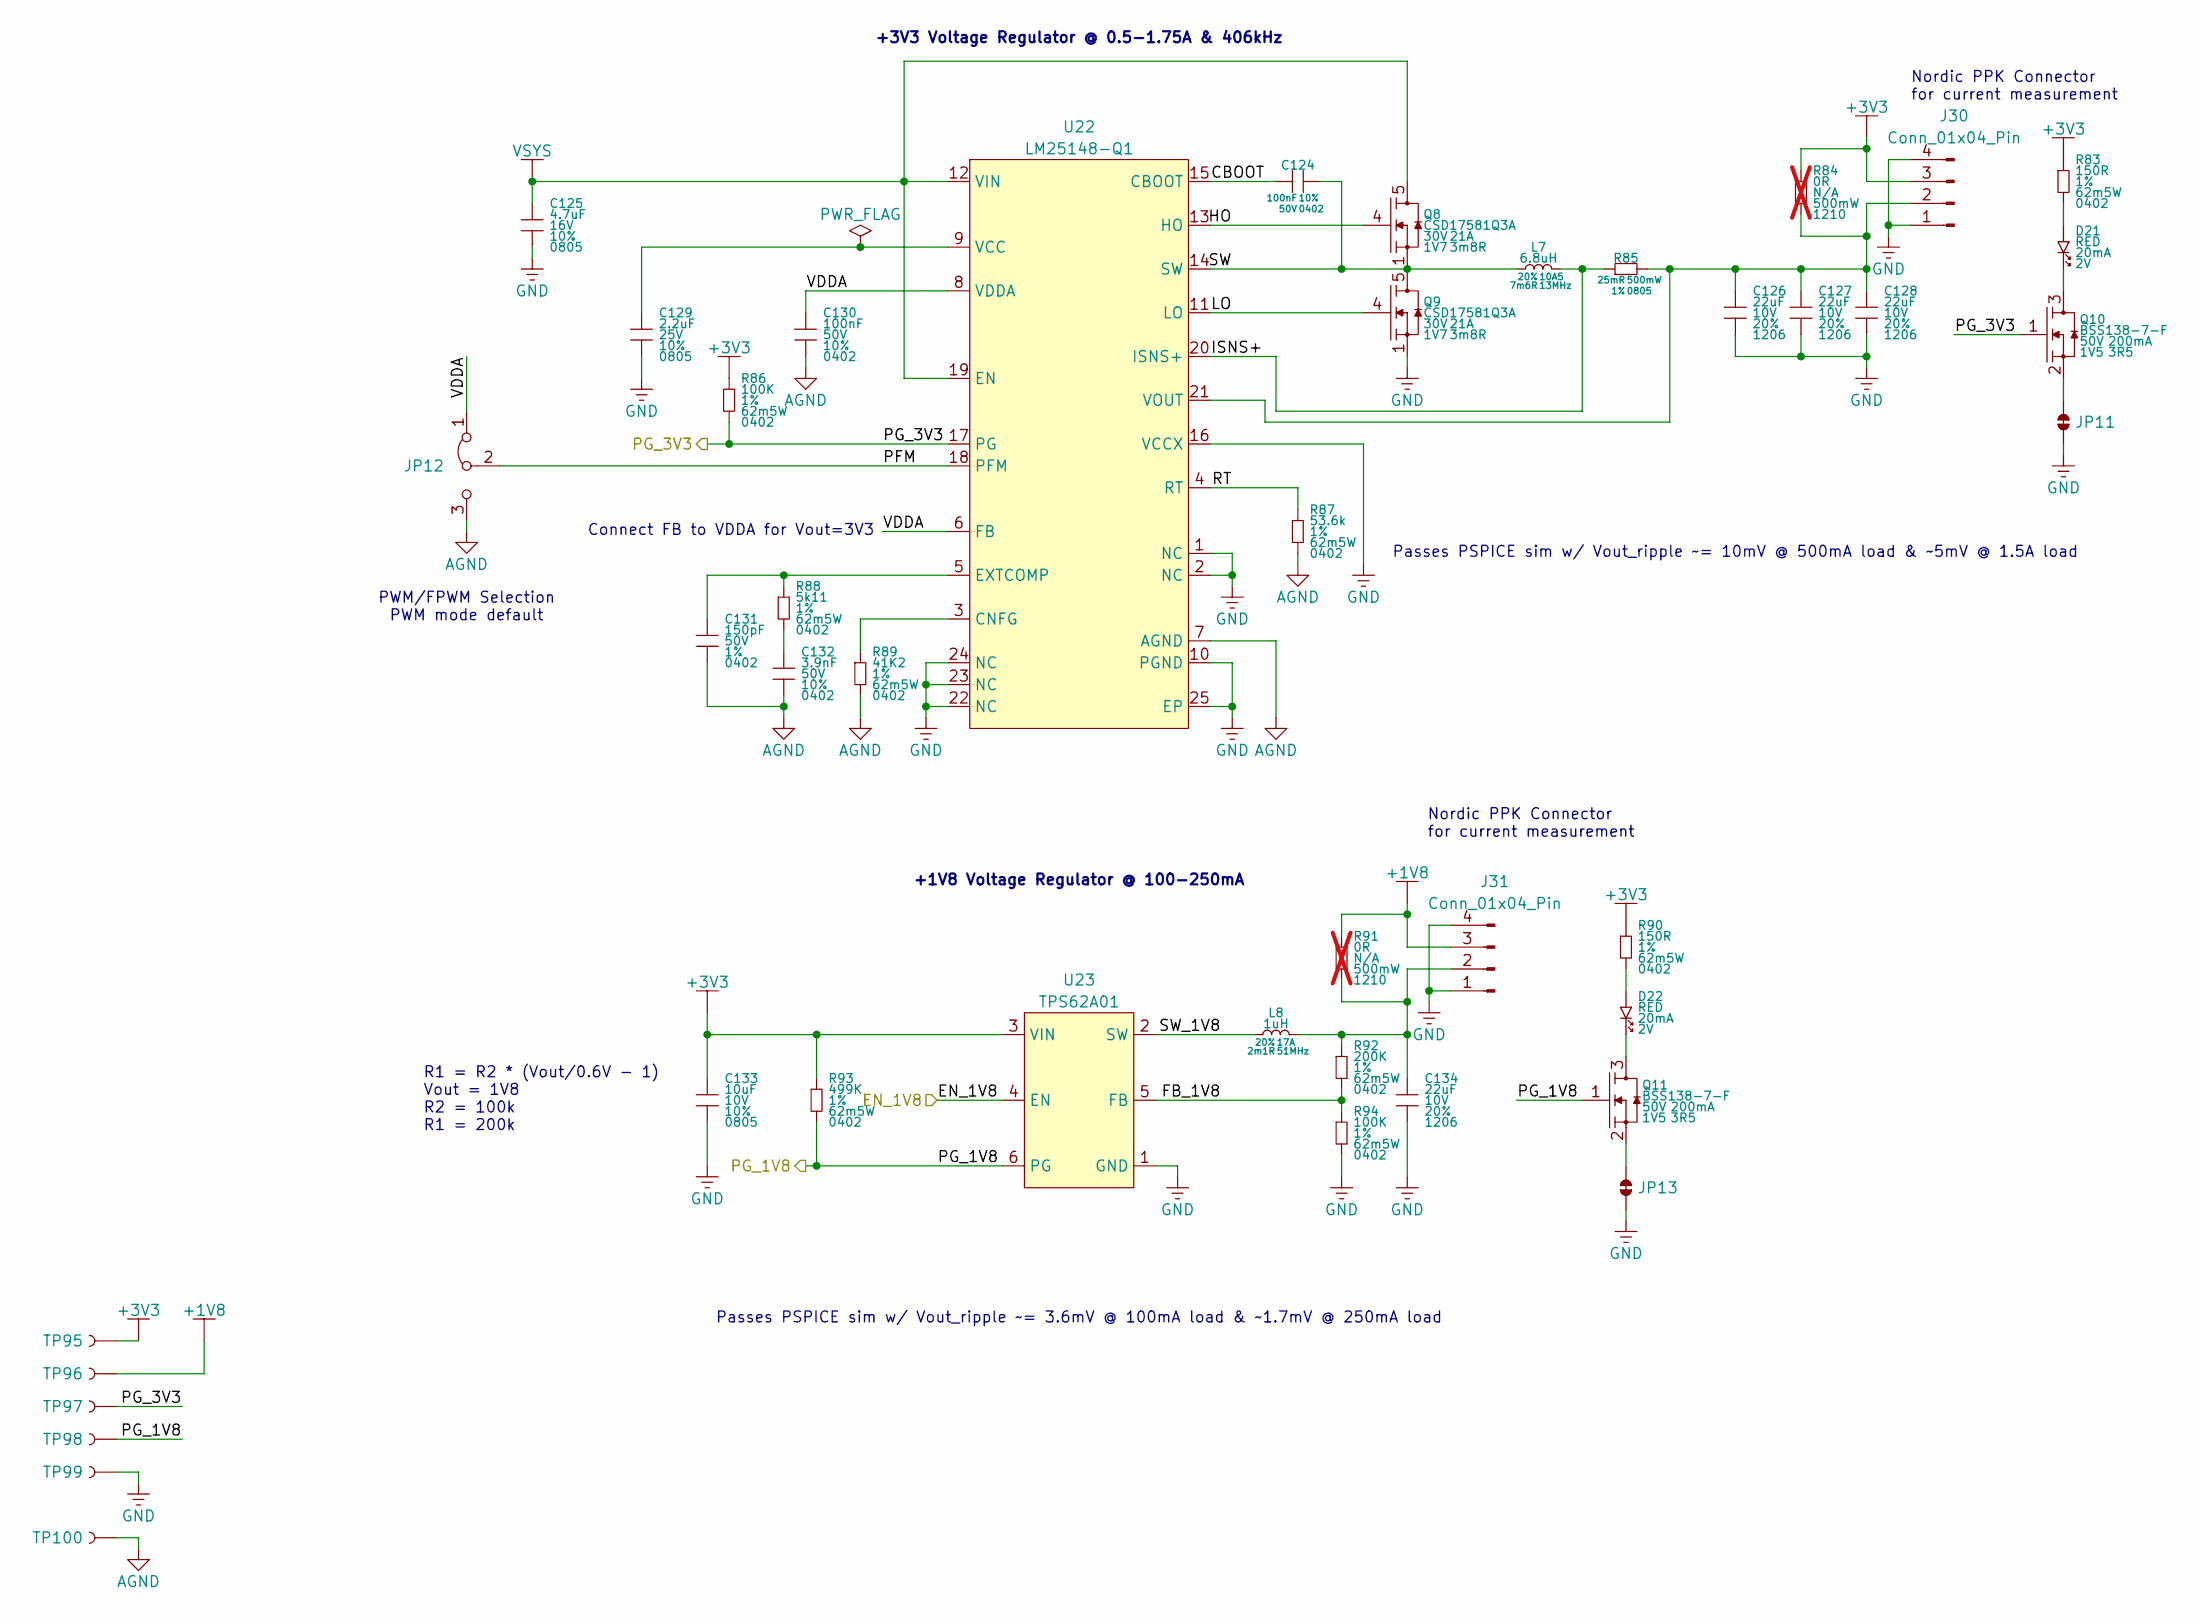
[picture p48: schematic voltageRegulators.kicad_sch, Voltage Regulators]

Parts:
C124, C130: 100nF; GCM0402; Tolerance 10%; Voltage Rating 50V; MPN GRT155R71H104KE01D
C125: 4.7uF; GCM0805; Tolerance 10%; Voltage Rating 16V; MPN GRT21BR71C475KE13L
C126, C127, C128, C134: 22uF; GCM1206; Tolerance 20%; Voltage Rating 10V; MPN GCM31CR71A226ME02L
C129: 2.2uF; GCM0805; Tolerance 10%; Voltage Rating 25V; MPN GRT21BR71E225KE13L
C131: 150pF; GCM0402; Tolerance 1%; Voltage Rating 50V; MPN GCM1555C1H151FA16J
C132: 3.9nF; GCM0402; Tolerance 10%; Voltage Rating 50V; MPN GCM155R71H392KA37D
C133: 10uF; GCM0805; Tolerance 10%; Voltage Rating 10V; MPN GCM21BR71A106KE22L
D21, D22: LTST-C191KRKT; LTST-0603; Forward Voltage 2V; MPN LTST-C191KRKT
J30, J31: Conn_01x04_Pin; conn_01x04_254; MPN PRPC004SAAN-RC
JP11, JP13: SolderJumper-2_P1.3mm_Bridged_RoundedPad1.0x1.5mm
JP12: SolderJumper-3_P1.3mm_Bridged12_RoundedPad1.0x1.5mm
L7: 6.8uH; WE-XHMI-1090; Tolerance 20%; Current Rating 10A5; MPN 74439369068
L8: 1uH; WE-XHMI-8080; Tolerance 20%; Current Rating 17A; MPN 74439358010
Q8, Q9: CSD17581Q3A; SON65P300X315X90-8; MPN CSD17581Q3A
Q10, Q11: BSS138-7-F; SOT23; MPN BSS138-7-F
R83, R90: 150R; CRCW0402; Tolerance 1%; Power Rating 62m5W; MPN CRCW0402150RFKED
R84, R91: 0R; CRCW1210; Tolerance N/A; Power Rating 500mW; MPN CRCW12100000Z0EA; not fitted
R85: 25mR; CRCW0805; Tolerance 1%; Power Rating 500mW; MPN WSLP0805R0250FEB
R86, R94: 100K; CRCW0402; Tolerance 1%; Power Rating 62m5W; MPN CRCW0402100KFKED
R87: 53.6k; CRCW0402; Tolerance 1%; Power Rating 62m5W; MPN CRCW040253K6FKED
R88: 5k11; CRCW0402; Tolerance 1%; Power Rating 62m5W; MPN CRCW04025K11FKED
R89: 41K2; CRCW0402; Tolerance 1%; Power Rating 62m5W; MPN CRCW040241R2FKED
R92: 200K; CRCW0402; Tolerance 1%; Power Rating 62m5W; MPN CRCW0402200KFKED
R93: 499K; CRCW0402; Tolerance 1%; Power Rating 62m5W; MPN CRCW0402499KFKED
TP95, TP96, TP97, TP98: TP_2mm; MPN N/A
TP99, TP100: RCWCTE; TP_RCW; MPN RCWCTE
U22: LM25148-Q1; QFN50P350X550X100-24; MPN LM25148BQRGYRQ1
U23: TPS62A01; SOT563; MPN TPS62A01DRLR

Connections:
+1V8: J31.3, R91.1, TP96.1; also elsewhere on the board
+3V3: C133.1, J30.3, R83.1, R84.1, R86.1, R90.1, R93.1, TP95.1, U23.3 (VIN); also elsewhere on the board
/EPS Controller/EN_1V8: U23.4 (EN); also elsewhere on the board
/EPS Controller/PG_1V8: Q11.1, R93.2, TP98.1, U23.6 (PG); also elsewhere on the board
/EPS Controller/PG_3V3: Q10.1, R86.2, TP97.1, U22.17 (PG); also elsewhere on the board
/EPS Controller/Voltage Regulators/CBOOT: C124.1, U22.15 (CBOOT)
/EPS Controller/Voltage Regulators/FB_1V8: R92.2, R94.1, U23.5 (FB)
/EPS Controller/Voltage Regulators/HO: Q8.4, U22.13 (HO)
/EPS Controller/Voltage Regulators/ISNS+: L7.2, R85.1, U22.20 (ISNS+)
/EPS Controller/Voltage Regulators/LO: Q9.4, U22.11 (LO)
/EPS Controller/Voltage Regulators/PFM: JP12.2 (C), U22.18 (PFM)
/EPS Controller/Voltage Regulators/RT: R87.1, U22.4 (RT)
/EPS Controller/Voltage Regulators/SW: C124.2, L7.1, Q8.1, Q8.2, Q8.3, Q9.5, Q9.6, Q9.7, Q9.8, Q9.9, U22.14 (SW)
/EPS Controller/Voltage Regulators/SW_1V8: L8.1, U23.2 (SW)
/EPS Controller/Voltage Regulators/VDDA: C130.1, JP12.1 (A), U22.6 (FB), U22.8 (VDDA)
AGND: C130.2, C131.2, C132.2, JP12.3 (B), R87.2, R89.2, TP100.1, U22.7 (AGND); also elsewhere on the board
GND: C125.2, C126.2, C127.2, C128.2, C129.2, C133.2, C134.2, J30.1, J30.4, J31.1, J31.4, JP11.2, JP13.2, Q9.1, Q9.2, Q9.3, R94.2, TP99.1, U22.1 (NC), U22.2 (NC), U22.10 (PGND), U22.16 (VCCX), U22.22 (NC), U22.23 (NC), U22.24 (NC), U22.25 (EP), U23.1 (GND); also elsewhere on the board
unnamed: C132.1, R88.2
unnamed: D21.1, R83.2
unnamed: D21.2, Q10.3
unnamed: D22.1, R90.2
unnamed: D22.2, Q11.3
unnamed: C126.1, C127.1, C128.1, J30.2, R84.2, R85.2, U22.21 (VOUT)
unnamed: C134.1, J31.2, L8.2, R91.2, R92.1
unnamed: JP11.1, Q10.2
unnamed: JP13.1, Q11.2
unnamed: R89.1, U22.3 (CNFG)
unnamed: C131.1, R88.1, U22.5 (EXTCOMP)
unnamed: C129.1, U22.9 (VCC)
VSYS: C125.1, Q8.5, Q8.6, Q8.7, Q8.8, Q8.9, U22.12 (VIN), U22.19 (EN); also elsewhere on the board

Notes on the sheet:
Connect FB to VDDA for Vout=3V3
PWM/FPWM Selection PWM mode default
+1V8 Voltage Regulator @ 100-250mA
Nordic PPK Connector for current measurement
Passes PSPICE sim w/ Vout_ripple ~= 3.6mV @ 100mA load & ~1.7mV @ 250mA load
+3V3 Voltage Regulator @ 0.5-1.75A & 406kHz
R1 = R2 * (Vout/0.6V - 1) Vout = 1V8 R2 = 100k R1 = 200k
Passes PSPICE sim w/ Vout_ripple ~= 10mV @ 500mA load & ~5mV @ 1.5A load

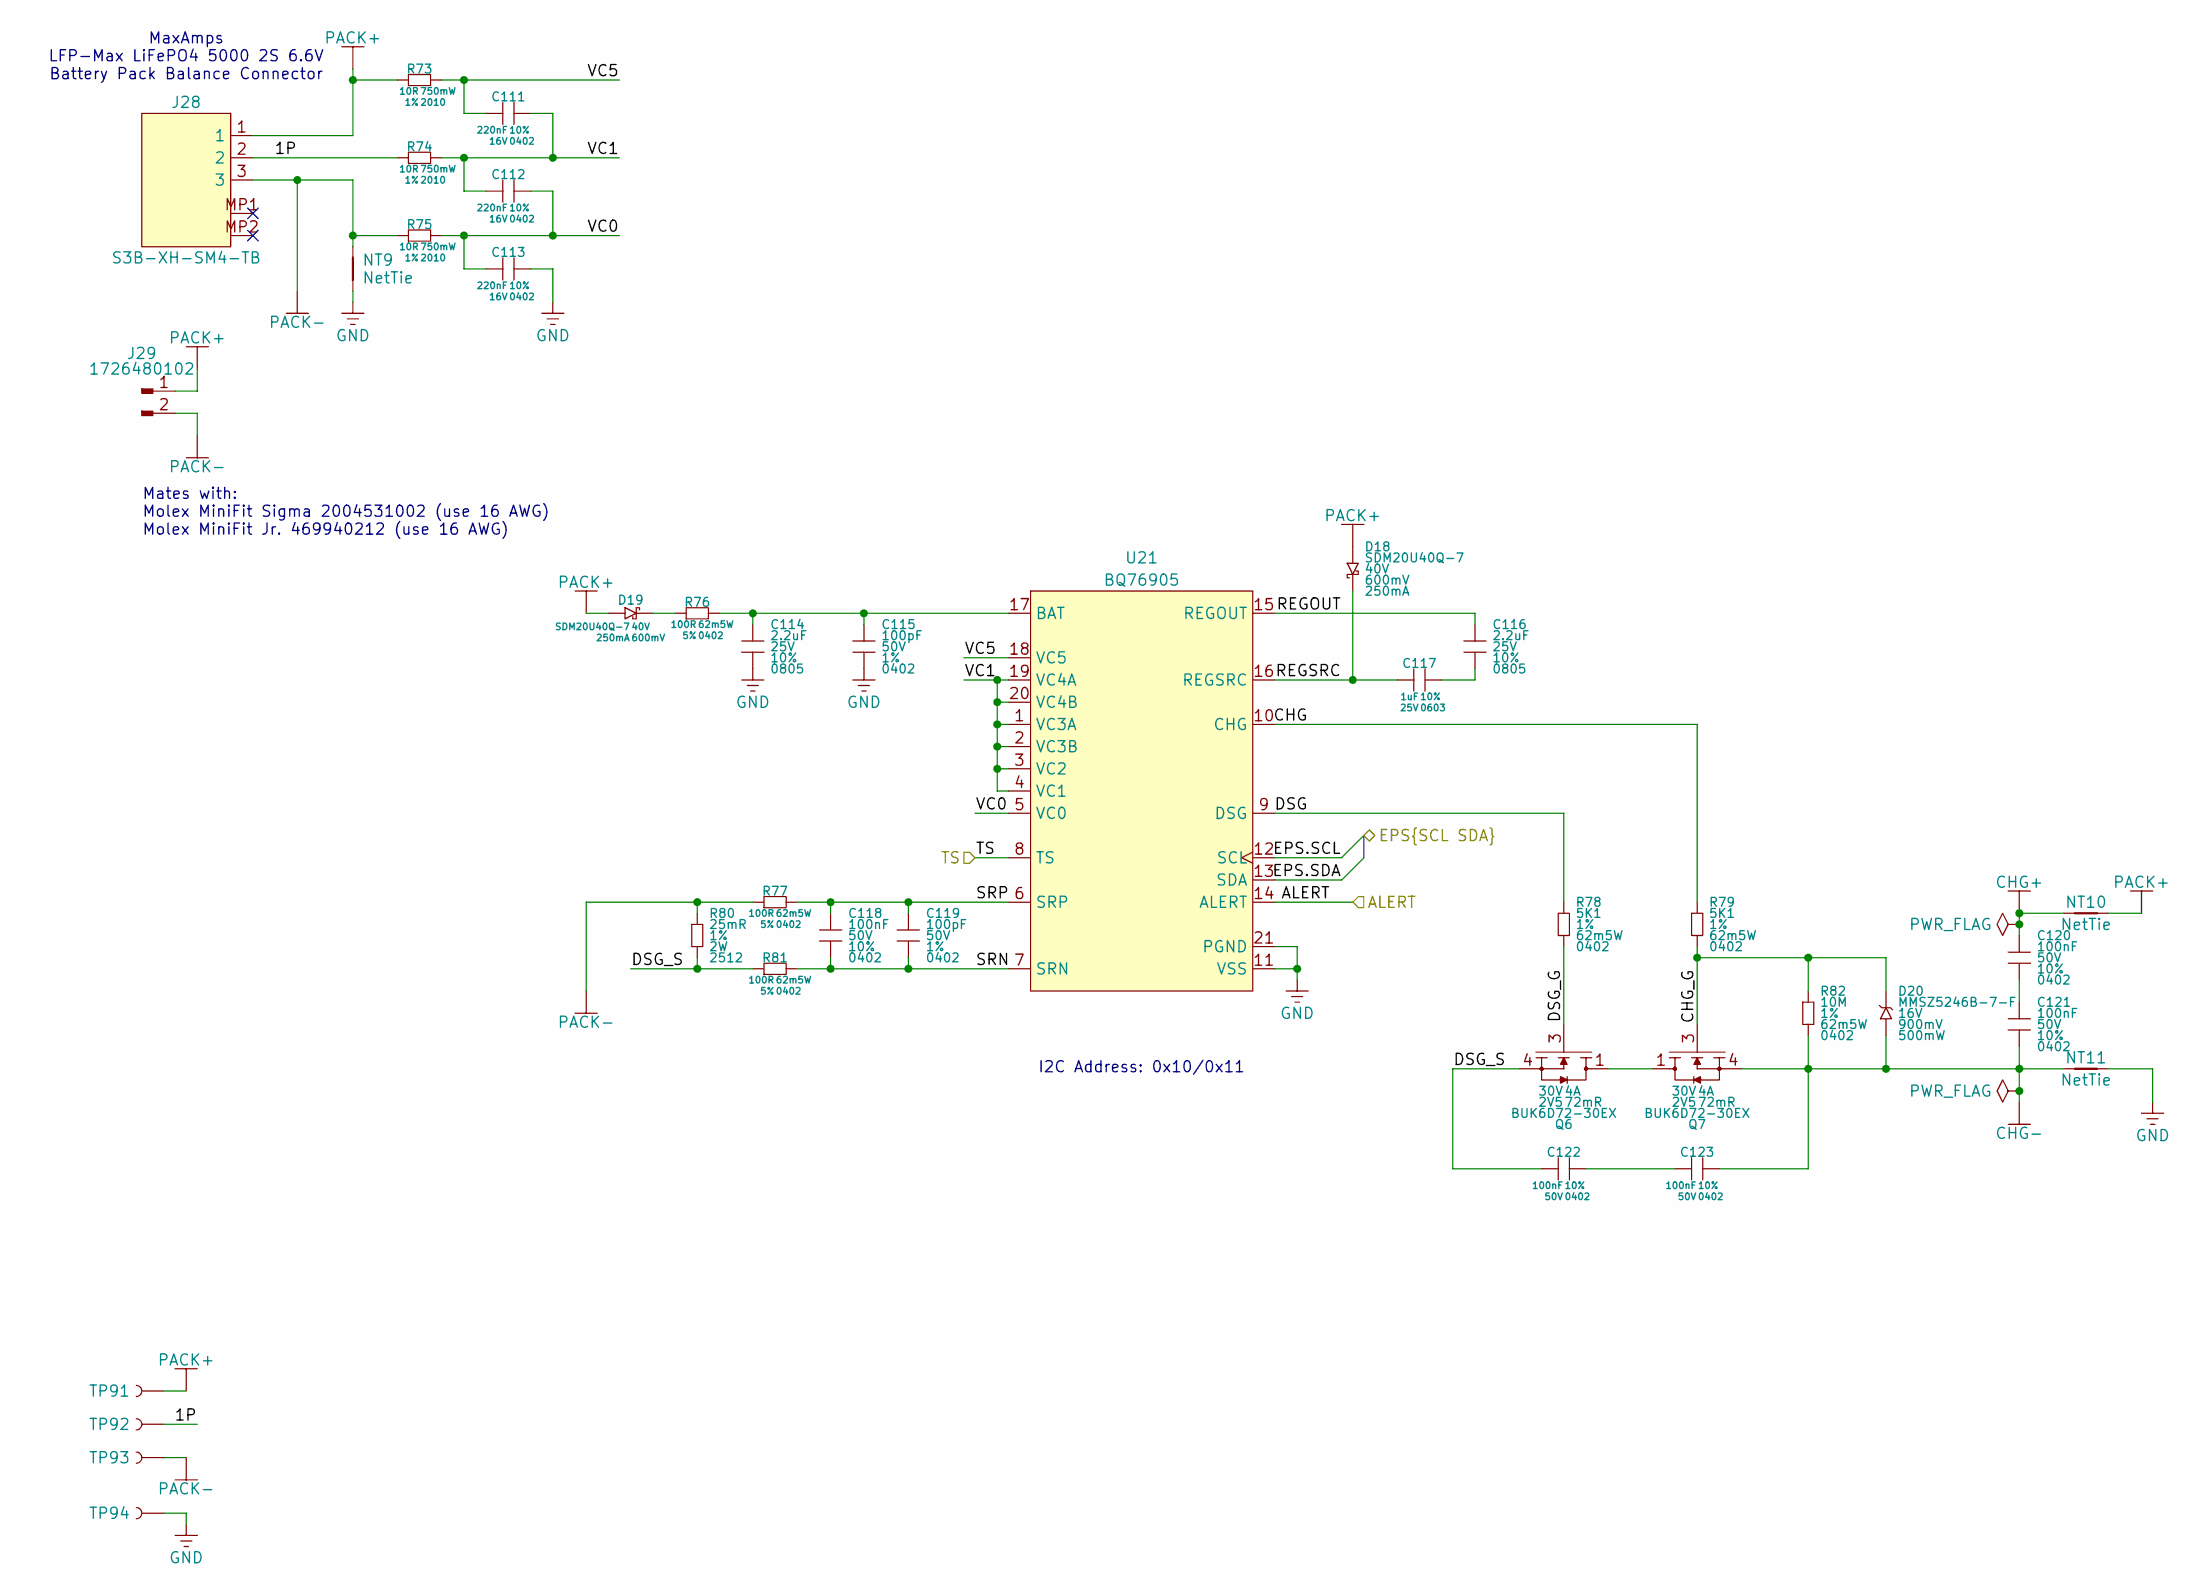
[picture p49: schematic batteryManager.kicad_sch, Battery Monitor and Protector]

Parts:
C111, C112, C113: 220nF; GCM0402; Voltage Rating 16V; Tolerance 10%; MPN GRT155R71C224KE01D
C114, C116: 2.2uF; GCM0805; Tolerance 10%; Voltage Rating 25V; MPN GRT21BR71E225KE13L
C115, C119: 100pF; GCM0402; Tolerance 1%; Voltage Rating 50V; MPN GCM1555C1H101FA16D
C117: 1uF; GRT0603; Voltage Rating 25V; Tolerance 10%; MPN GRT188R71E105KE13D
C118, C120, C121: 100nF; GCM0402; Tolerance 10%; Voltage Rating 50V; MPN GRT155R71H104KE01D
C122, C123: 100nF; GCM0402; Voltage Rating 50V; Tolerance 10%; MPN GRT155R71H104KE01D
D18, D19: SDM20U40Q-7; SOD523; Reverse Voltage 40V; Forward Voltage 600mV; MPN SDM20U40Q-7
D20: MMSZ5246B-7-F; SOD123; Zener Voltage 16V; Forward Voltage 900mV; MPN MMSZ5246B-7-F
J28: S3B-XH-SM4-TB; JST_XH_S3B-SM4-TB; MPN S3B-XH-SM4-TB
J29: 1726480102; MPN 1726480102
NT9, NT10, NT11: NetTie; NetTie-2_SMD_Pad2.0mm
Q6, Q7: BUK6D72-30EX; UDFN6P65_200X200X65L30X25N; MPN BUK6D72-30EX
R73, R74, R75: 10R; CRCW2010; Tolerance 1%; Power Rating 750mW; MPN CRCW201010R0FKEF
R76, R77, R81: 100R; CRCW0402; Tolerance 5%; Power Rating 62m5W; MPN CRCW0402100RJNED
R78, R79: 5K1; CRCW0402; Tolerance 1%; Power Rating 62m5W; MPN CRCW04025K10FKED
R80: 25mR; WSL2512-HP; Tolerance 1%; Power Rating 2W; MPN WSL2512R0400FEA18
R82: 10M; CRCW0402; Tolerance 1%; Power Rating 62m5W; MPN CRCW040210M0FKED
TP91, TP92: TP_2mm; MPN N/A
TP93, TP94: RCWCTE; TP_RCW; MPN RCWCTE
U21: BQ76905; QFN50P350X350X100-20; MPN BQ76905RGRR

Connections:
/EPS Controller/BAL_ALERT: U21.14 (ALERT); also elsewhere on the board
/EPS Controller/Battery Manager/1P: J28.2, R74.1, TP92.1
/EPS Controller/Battery Manager/CHG: R79.1, U21.10 (CHG)
/EPS Controller/Battery Manager/CHG_G: D20.2, Q7.3, R79.2, R82.1
/EPS Controller/Battery Manager/DSG: R78.1, U21.9 (DSG)
/EPS Controller/Battery Manager/DSG_G: Q6.3, R78.2
/EPS Controller/Battery Manager/DSG_S: C122.1, Q6.4, Q6.8, R80.2, R81.1
/EPS Controller/Battery Manager/REGOUT: C116.1, U21.15 (REGOUT)
/EPS Controller/Battery Manager/REGSRC: C117.1, D18.1, U21.16 (REGSRC)
/EPS Controller/Battery Manager/SRN: C118.2, C119.2, R81.2, U21.7 (SRN)
/EPS Controller/Battery Manager/SRP: C118.1, C119.1, R77.2, U21.6 (SRP)
/EPS Controller/Battery Manager/VC0: C112.2, C113.1, R75.2, U21.5 (VC0)
/EPS Controller/Battery Manager/VC1: C111.2, C112.1, R74.2, U21.1 (VC3A), U21.2 (VC3B), U21.3 (VC2), U21.4 (VC1), U21.19 (VC4A), U21.20 (VC4B)
/EPS Controller/Battery Manager/VC5: C111.1, R73.2, U21.18 (VC5)
/EPS Controller/TS: U21.8 (TS); also elsewhere on the board
/EPS.SCL: U21.12 (SCL); also elsewhere on the board
/EPS.SDA: U21.13 (SDA); also elsewhere on the board
CHG+: C120.1, NT10.1; also elsewhere on the board
CHG-: C121.2, C123.2, D20.1, NT11.1, Q7.4, Q7.8, R82.2; also elsewhere on the board
GND: C113.2, C114.2, C115.2, NT9.1, NT11.2, TP94.1, U21.11 (VSS), U21.21 (PGND); also elsewhere on the board
unnamed: C116.2, C117.2
unnamed: C120.2, C121.1
unnamed: C122.2, C123.1
unnamed: D19.1, R76.1
unnamed: Q6.1, Q6.2, Q6.5, Q6.6, Q6.7, Q7.1, Q7.2, Q7.5, Q7.6, Q7.7
unnamed: C114.1, C115.1, R76.2, U21.17 (BAT)
PACK+: D18.2, D19.2, J28.1, J29.1, NT10.2, R73.1, TP91.1
PACK-: J28.3, J29.2, NT9.2, R75.1, R77.1, R80.1, TP93.1

Notes on the sheet:
MaxAmps LFP-Max LiFePO4 5000 2S 6.6V Battery Pack Balance Connector
I2C Address: 0x10/0x11
Mates with: Molex MiniFit Sigma 2004531002 (use 16 AWG) Molex MiniFit Jr. 469940212 (use 16 AWG)
