DeepSpace00/Awohali/hardware/electronics/mainBoard/mainBoard.kicad_pcb

## KiCad design hardware/electronics/mainBoard/mainBoard.kicad_pcb (continued)

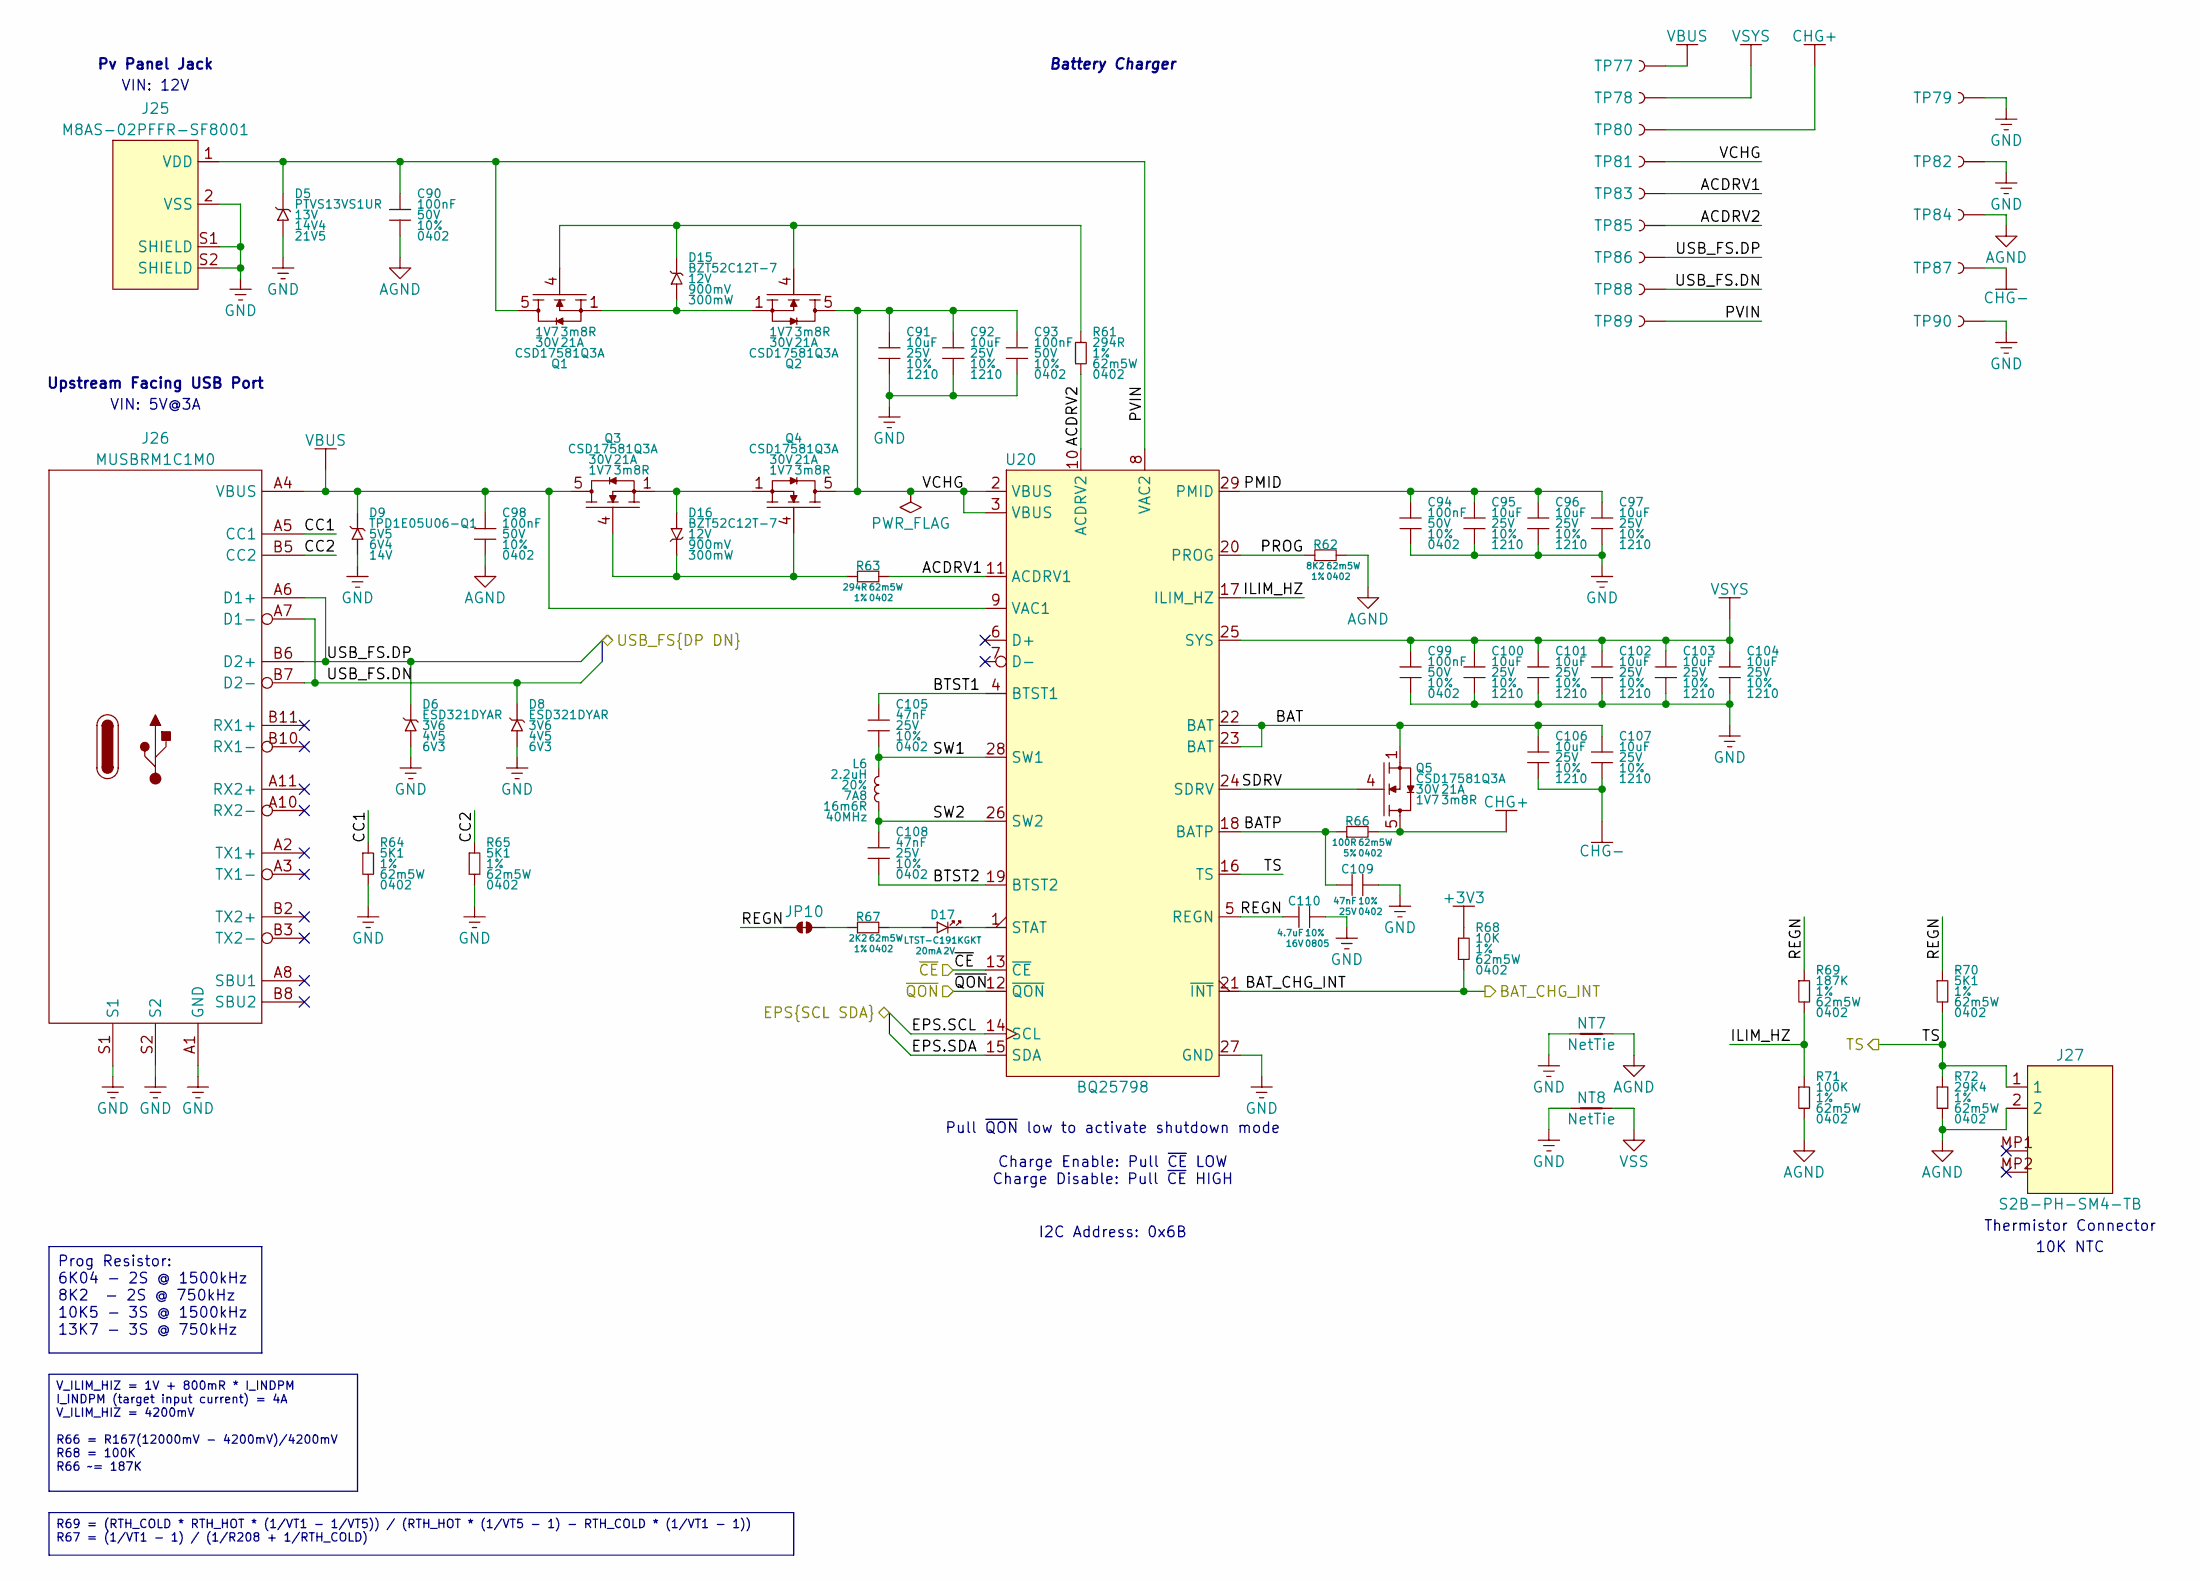
[picture p50: schematic batteryCharger.kicad_sch, Battery Charger]

Parts:
C90, C93, C94, C98, C99: 100nF; GCM0402; Tolerance 10%; Voltage Rating 50V; MPN GRT155R71H104KE01D
C91, C92, C95, C96, C97, C100, C101, C102, C103, C104, C106, C107: 10uF; GRT1210; Tolerance 10%; Voltage Rating 25V; MPN GCM32ER71E106KA57L
C105, C108, C109: 47nF; GCM0402; Tolerance 10%; Voltage Rating 25V; MPN GRT155R71E473KE01D
C110: 4.7uF; GCM0805; Tolerance 10%; Voltage Rating 16V; MPN GRT21BR71C475KE13L
D5: PTVS13VS1UR; SOD123W; Voltage - Reverse Stabd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 13V; Voltage - Breakdown 14V4; MPN PTVS13VS1UR,115
D6, D8: ESD321DYAR; SOD523; Voltage - Reverse Stabd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 3V6; Voltage - Breakdown 4V5; MPN ESD321DYAR
D9: TPD1E05U06-Q1; SON2P65_100X60X50L50X25N; Voltage - Reverse Stabd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 5V5; Voltage - Breakdown 6V4; MPN TPD1E05U06QDPYRQ1
D15, D16: BZT52C12T-7; SOD523; Zener Voltage 12V; Forward Voltage 900mV; MPN BZT52C12T-7
D17: LTST-C191KGKT; LTST-0603; Forward Voltage 2V; MPN LTST-C191KGKT
J25: M8AS-02PFFR-SF8001; MPN M8AS-02PFFR-SF8001
J26: MUSBRM1C1M0; MUSBR-M1C1-XX; MPN MUSBRM1C1M0
J27: S2B-PH-SM4-TB; JST-PH-S2B-SM4-TB; MPN S2B-PH-SM4-TB
JP10: SolderJumper-2_P1.3mm_Bridged_RoundedPad1.0x1.5mm
L6: 2.2uH; WE-XHMI-4030; Tolerance 20%; Current Rating 7A8; MPN 74439324022
NT7, NT8: NetTie; NetTie-2_SMD_Pad2.0mm
Q1, Q3, Q4: CSD17581Q3A; SON65P300X315X90-8; MPN Texas Instruments
Q2, Q5: CSD17581Q3A; SON65P300X315X90-8; MPN CSD17581Q3A
R61: 294R; CRCW0402; Tolerance 1%; Power Rating 62m5W; MPN CRCW0402294RFKED
R62: 8K2; CRCW0402; Tolerance 1%; Power Rating 62m5W; MPN CRCW04028K20FKED
R63: 294R; CRCW0402; Tolerance 1%; Power Rating 62m5W; MPN CRCW04026K04FKED
R64, R65, R70: 5K1; CRCW0402; Tolerance 1%; Power Rating 62m5W; MPN CRCW04025K10FKED
R66: 100R; CRCW0402; Tolerance 5%; Power Rating 62m5W; MPN CRCW0402100RJNED
R67: 2K2; CRCW0402; Tolerance 1%; Power Rating 62m5W; MPN CRCW04022K20FKED
R68: 10K; CRCW0402; Tolerance 1%; Power Rating 62m5W; MPN CRCW040210K0FKED
R69: 187K; CRCW0402; Tolerance 1%; Power Rating 62m5W; MPN CRCW0402187KFKED
R71: 100K; CRCW0402; Tolerance 1%; Power Rating 62m5W; MPN CRCW0402100KFKED
R72: 29K4; CRCW0402; Tolerance 1%; Power Rating 62m5W; MPN CRCW040229K4FKED
TP77, TP78, TP80, TP81, TP83, TP85, TP86, TP88, TP89: TP_2mm; MPN N/A
TP79, TP82, TP84, TP87, TP90: RCWCTE; TP_RCW; MPN RCWCTE
U20: BQ25798; QFN40P400X400X100-29; MPN BQ25798RQMR

Connections:
+3V3: R68.1; also elsewhere on the board
/EPS Controller/BAT_CHG_INT: R68.2, U20.21 (~INT); also elsewhere on the board
/EPS Controller/Battery Charger/ACDRV1: R63.2, TP83.1, U20.11 (ACDRV1)
/EPS Controller/Battery Charger/ACDRV2: R61.2, TP85.1, U20.10 (ACDRV2)
/EPS Controller/Battery Charger/BAT: C106.1, C107.1, Q5.1, Q5.2, Q5.3, U20.22 (BAT), U20.23 (BAT)
/EPS Controller/Battery Charger/BATP: C109.1, R66.1, U20.18 (BATP)
/EPS Controller/Battery Charger/BTST1: C105.1, U20.4 (BTST1)
/EPS Controller/Battery Charger/BTST2: C108.2, U20.19 (BTST2)
/EPS Controller/Battery Charger/CC1: J26.A5 (CC1), R64.1
/EPS Controller/Battery Charger/CC2: J26.B5 (CC2), R65.1
/EPS Controller/Battery Charger/ILIM_HZ: R69.2, R71.1, U20.17 (ILIM_HZ)
/EPS Controller/Battery Charger/PMID: C94.1, C95.1, C96.1, C97.1, U20.29 (PMID)
/EPS Controller/Battery Charger/PROG: R62.1, U20.20 (PROG)
/EPS Controller/Battery Charger/PVIN: C90.1, D5.1, J25.1 (VDD), Q1.5, Q1.6, Q1.7, Q1.8, Q1.9, TP89.1, U20.8 (VAC2)
/EPS Controller/Battery Charger/REGN: C110.1, JP10.1, R69.1, R70.1, U20.5 (REGN)
/EPS Controller/Battery Charger/SDRV: Q5.4, U20.24 (SDRV)
/EPS Controller/Battery Charger/SW1: C105.2, L6.1, U20.28 (SW1)
/EPS Controller/Battery Charger/SW2: C108.1, L6.2, U20.26 (SW2)
/EPS Controller/Battery Charger/VCHG: C91.1, C92.1, C93.1, Q2.5, Q2.6, Q2.7, Q2.8, Q2.9, Q4.5, Q4.6, Q4.7, Q4.8, Q4.9, TP81.1, U20.2 (VBUS), U20.3 (VBUS)
/EPS Controller/TS: J27.1, R70.2, R72.1, U20.16 (TS); also elsewhere on the board
/EPS Controller/USB_FS.DN: D8.1, J26.A7 (D1-), J26.B7 (D2-), TP88.1; also elsewhere on the board
/EPS Controller/USB_FS.DP: D6.1, J26.A6 (D1+), J26.B6 (D2+), TP86.1; also elsewhere on the board
/EPS Controller/~CE: U20.13 (~CE); also elsewhere on the board
/EPS Controller/~QON: U20.12 (~QON); also elsewhere on the board
/EPS.SCL: U20.14 (SCL); also elsewhere on the board
/EPS.SDA: U20.15 (SDA); also elsewhere on the board
AGND: C90.2, C98.2, J27.2, NT7.2, R62.2, R71.2, R72.2, TP84.1; also elsewhere on the board
CHG+: Q5.5, Q5.6, Q5.7, Q5.8, Q5.9, R66.2, TP80.1; also elsewhere on the board
CHG-: C106.2, C107.2, TP87.1; also elsewhere on the board
GND: C91.2, C92.2, C93.2, C94.2, C95.2, C96.2, C97.2, C99.2, C100.2, C101.2, C102.2, C103.2, C104.2, C109.2, C110.2, D5.2, D6.2, D8.2, D9.2, J25.2 (VSS), J25.S1 (SHIELD), J25.S2 (SHIELD), J26.A1 (GND), J26.A12 (GND), J26.B1 (GND), J26.B12 (GND), J26.G1 (GND), J26.G2 (GND), J26.G3 (GND), J26.G4 (GND), J26.G5 (GND), J26.G6 (GND), J26.S1, J26.S2, NT7.1, NT8.1, R64.2, R65.2, TP79.1, TP82.1, TP90.1, U20.27 (GND); also elsewhere on the board
unnamed: D15.1, Q1.1, Q1.2, Q1.3, Q2.1, Q2.2, Q2.3
unnamed: D15.2, Q1.4, Q2.4, R61.1
unnamed: D16.1, Q3.1, Q3.2, Q3.3, Q4.1, Q4.2, Q4.3
unnamed: D16.2, Q3.4, Q4.4, R63.1
unnamed: D17.1, R67.2
unnamed: JP10.2, R67.1
unnamed: D17.2, U20.1 (STAT)
VBUS: C98.1, D9.1, J26.A4 (VBUS), J26.A9 (VBUS), J26.B4 (VBUS), J26.B9 (VBUS), Q3.5, Q3.6, Q3.7, Q3.8, Q3.9, TP77.1, U20.9 (VAC1)
VSS: NT8.2; also elsewhere on the board
VSYS: C99.1, C100.1, C101.1, C102.1, C103.1, C104.1, TP78.1, U20.25 (SYS); also elsewhere on the board

Notes on the sheet:
Upstream Facing USB Port
VIN: 12V
VIN: 5V@3A
I2C Address: 0x6B
Pv Panel Jack
Thermistor Connector
Pull ~{QON} low to activate shutdown mode
Charge Enable: Pull ~{CE} LOW Charge Disable: Pull ~{CE} HIGH
10K NTC
Battery Charger
Prog Resistor: 6K04 - 2S @ 1500kHz 8K2 - 2S @ 750kHz 10K5 - 3S @ 1500kHz 13K7 - 3S @ 750kHz
R69 = (RTH_COLD * RTH_HOT * (1/VT1 - 1/VT5)) / (RTH_HOT * (1/VT5 - 1) - RTH_COLD * (1/VT1 - 1)) R67 = (1/VT1 - 1) / (1/R208 + 1/RTH_COLD)
V_ILIM_HIZ = 1V + 800mR * I_INDPM I_INDPM (target input current) = 4A V_ILIM_HIZ = 4200mV R66 = R167(12000mV - 4200mV)/4200mV R68 = 100K R66 ~= 187K

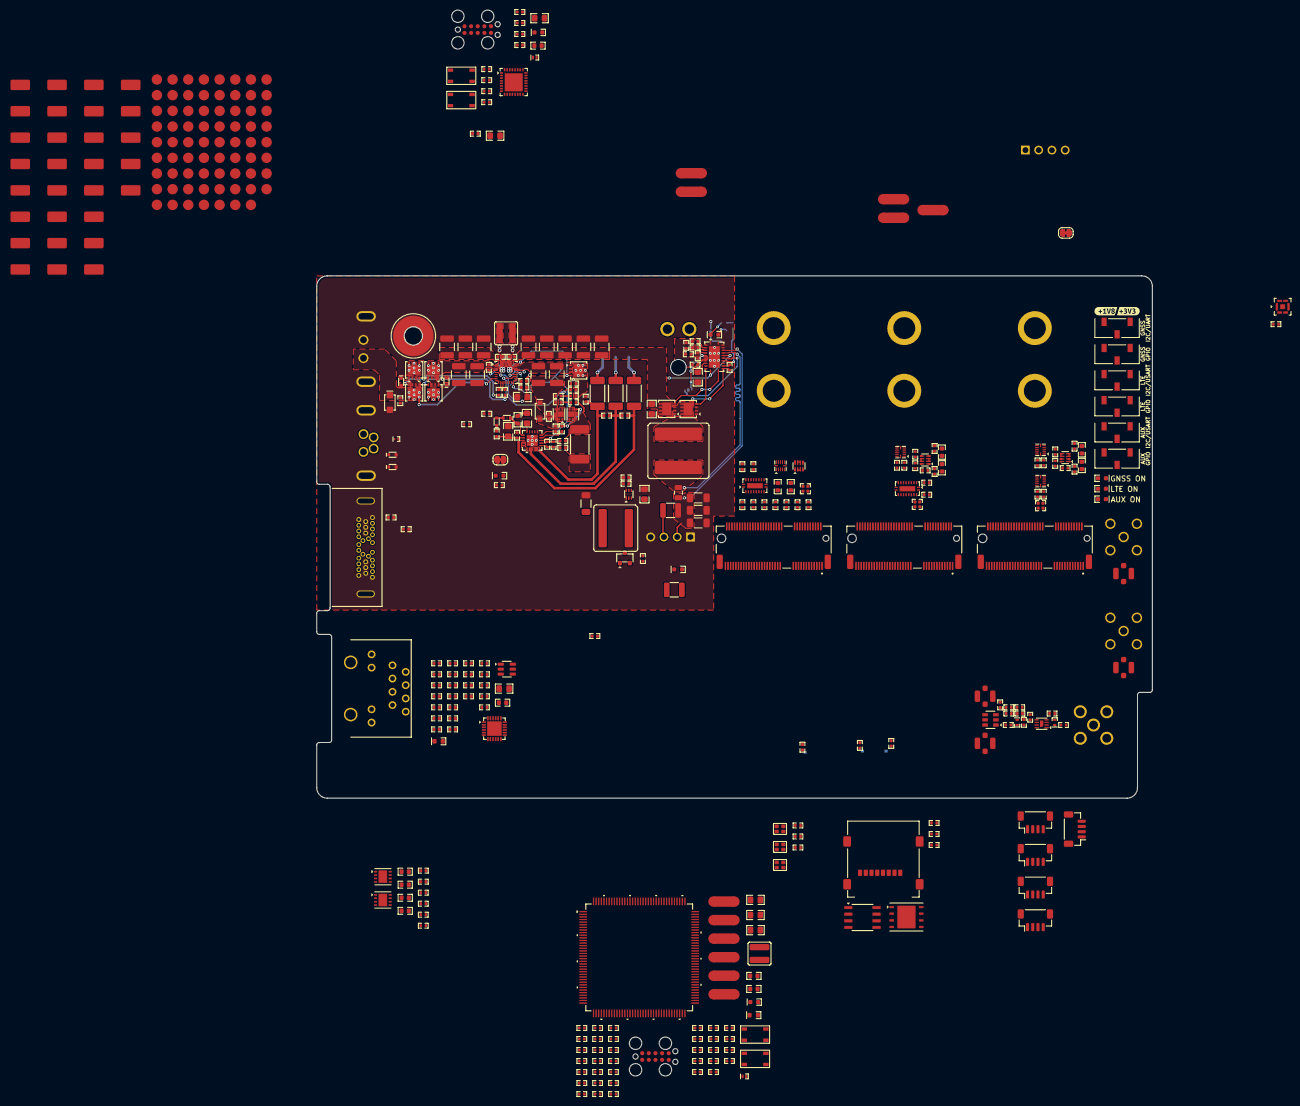
[picture p51: board mainBoard.kicad_pcb from above]

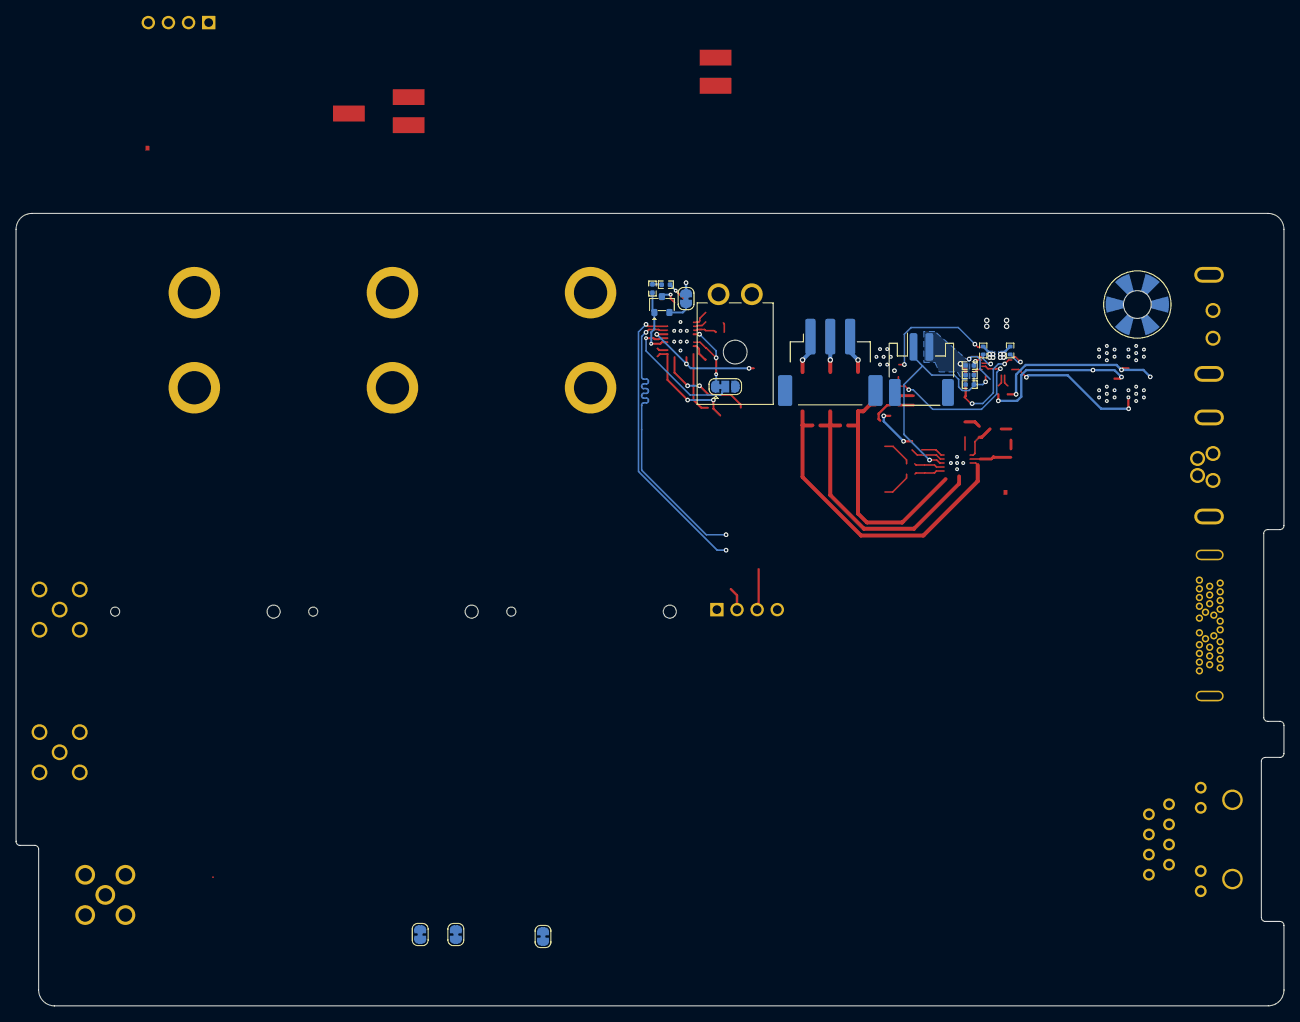
[picture p52: board mainBoard.kicad_pcb from below]

Board: 4 copper layers, 160.0 x 100.0 mm, 451 parts (16 on the bottom side), 272 nets.

Other parts of the board:
kibuzzard-67E082B6: G***; kibuzzard-67E082B6
kibuzzard-67E082BE: G***; kibuzzard-67E082BE
