DeepSpace00/Awohali/firmware/modules/drivers/w25nxx/src/w25nxx.c

#include "w25nxx.h"

static W25Nxx_Status w25n_set_feature(uint8_t addr, uint8_t value);
static W25Nxx_Status w25n_get_feature(uint8_t addr, uint8_t *value);

W25Nxx_Status w25nxx_init(void) {
    return w25n_reset();
}

W25Nxx_Status w25nxx_reset(void) {
    uint8_t cmd = W25NXX_CMD_RESET;
    spi_cs_low();
    spi_transfer(&cmd, NULL, 1);
    spi_cs_high();
    delay_ms(1);
    return w25n_wait_ready(100);
}

W25Nxx_Status w25nxx_read_id(uint8_t *id, uint8_t len) {
    uint8_t cmd = W25NXX_JEDEC_ID;
    uint8_t dummy = 0x00;
    spi_cs_low();
    spi_transfer(&cmd, NULL, 1);
    spi_transfer(&dummy, NULL, 1);
    spi_transfer(NULL, id, len);
    spi_cs_high();
    return W25Nxx_OK;
}

W25Nxx_Status w25nxx_read_status(uint8_t *status) {
    return w25n_get_feature(W25NXX_REG_STATUS, status);
}

W25Nxx_Status w25nxx_write_enable(void) {
    uint8_t cmd = W25NXX_CMD_WRITE_ENABLE;
    spi_cs_low();
    spi_transfer(&cmd, NULL, 1);
    spi_cs_high();
    return W25Nxx_OK;
}

W25Nxx_Status w25nxx_chip_erase(W25Nxx_t flash_info)
{
    for (uint32_t i = 0; i < flash_info.BlockCount; i++)
    {
        if (w25nxx_block_erase(i) != W25Nxx_OK)
            return W25Nxx_ERROR;
    }
    return W25Nxx_OK;
}

W25Nxx_Status w25nxx_sector_erase(W25Nxx_t flash_info, uint32_t sector_addr)
{
    uint32_t block = sector_addr / flash_info.BlockSize;

    return w25nxx_block_erase(block);
}

W25Nxx_Status w25nxx_block_erase(uint32_t block_addr) {
    uint8_t cmd[4];
    cmd[0] = W25NXX_CMD_BLOCK_ERASE;
    cmd[1] = (block_addr >> 16) & 0xFF;
    cmd[2] = (block_addr >> 8) & 0xFF;
    cmd[3] = block_addr & 0xFF;

    if (w25nxx_write_enable() != W25Nxx_OK)
        return false;

    spi_cs_low();
    spi_transfer(cmd, NULL, 4);
    spi_cs_high();

    return w25n_wait_ready(2000);
}
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
