DeepSpace00/Awohali/(commit log)

2024-09-08 restructured folders
    [Sheet1.SchDoc, cellularBoard.PrjPcb, cellularBoard.kicad_pcb, cellularBoard.kicad_sch, gnssBoard.PrjPcb, gnssBoard.kicad_pcb, gnssBoard.kicad_sch, libPCB.PcbLib]
2024-09-08 renamed folders
    [adc-controller.yaml, akizuki-m-02990.cfg, altera-usb-blaster2-cyclonev.cfg, ambiq,flash-controller.yaml, ambiq,mspi-controller.yaml, andestech,machine-timer.yaml, atmel,sam-flash-controller.yaml, atmel,sam4l-flashcalw-controller.yaml]
2024-09-08 added TI app notes for power stuff
2024-09-09 added zephyr to venv
    [gpio-stepper-controller.yaml, hardened.csv, nordic,rram-controller.yaml, renesas,ra-flash-hp-controller.yaml, silabs,si32-flash-controller.yaml, spi-controller.yaml, stepper-controller.yaml, zephyr,i2c-emul-controller.yaml]
2024-09-13 started block diagram
    [mainBoard.kicad_sch]
2024-09-13 Added schematic page for microcontroller and power subsystem. Added batt charger
    [mainBoard.kicad_sch, microcontroller.kicad_sch, power.kicad_sch]
2024-09-14 batt charger stuff
    [microcontroller.kicad_sch, power.kicad_sch]
2024-09-16 Added datasheet for power path
2024-09-17 battery management stuff
    [power.kicad_sch]
2024-09-18 added repo for BMS breakout board
    [bms_breakout.kicad_pcb, bms_breakout.kicad_sch]
2024-09-19 created BMS breakout board
    [bms_breakout.kicad_sch]
2024-10-02 Relocated library files
    [bms_breakout.kicad_sch]
2024-10-07 added datasheets for resistors
2024-10-07 created symbols for BQ34Z100-R2 and SPDT switch
2024-10-07 rotated schematic pages
2024-10-07 added page for fuel gauge
    [fuel_gauge.kicad_sch]
2024-10-07 replaced power symbols
    [bms_breakout.kicad_sch]
2024-10-07 fixed drawing sheet ref
    [bms_breakout.kicad_sch]
2024-10-13 created child sheet for BQ34Z100
    [fuel_gauge.kicad_sch]
2024-10-13 created child sheet for BQ25798
    [battery_charger.kicad_sch]
2024-10-13 created child sheet for BQ76905
    [battery_monitor.kicad_sch]
2024-10-13 formatted for hierarchical sheets
    [bms_breakout.kicad_sch]
2024-10-14 added footprints for all resistors and capacitors
    [battery_charger.kicad_sch, battery_monitor.kicad_sch, bms_breakout.kicad_sch, fuel_gauge.kicad_sch]
2024-10-19 fuse stuff
    [battery_charger.kicad_sch, battery_monitor.kicad_sch]
2024-10-23 renamed bms board to power supply board
    [battery_charger.kicad_sch, battery_monitor.kicad_sch, fuel_gauge.kicad_sch, powerSupplyBoard.kicad_pcb, powerSupplyBoard.kicad_sch]
2024-10-28 added datasheetrs for stm32l4
2024-10-28 added footprint for BQ25798
    [battery_charger.kicad_sch]
2024-10-28 added footprint for BQ76905
    [battery_monitor.kicad_sch]
2024-10-28 added footprint for 2N7002
    [fuel_gauge.kicad_sch]
2024-10-28 added basic sch for stm32l4
    [powerSupplyBoard.kicad_sch]
2024-10-30 board backups
2024-10-30 replaced stm32l4 with stm32l0 pdfs
2024-10-30 replaced symbol in sch. updated crystal freq to 32.768kHz
    [powerSupplyBoard.kicad_sch]
2024-10-31 added reference manual for STM32L0
2024-10-31 worked on first page schematic
    [powerSupplyBoard.kicad_sch]
2024-10-31 added CK switches push button datasheet
2024-10-31 Diodes AP2112K datasheet
2024-10-31 ESC 32kHz crystal datasheet
2024-10-31 TI CANbus transceiver datasheet
2024-11-01 added Sullins pin header datasheets
2024-11-01 finished first page
    [powerSupplyBoard.kicad_sch]
2024-11-01 renumbers passives and cleaned up sheets
    [battery_charger.kicad_sch, battery_monitor.kicad_sch, fuel_gauge.kicad_sch]
2024-11-01 merged schematics with board file. Defined board specs.
    [powerSupplyBoard.kicad_pcb]
2024-11-01 added board specs
2024-11-01 added footprints to project lib
    [powerSupplyBoard.kicad_pcb]
2024-11-01 added board outline and internal ground planes
    [powerSupplyBoard.kicad_pcb]
2024-11-01 started layout of uC
    [powerSupplyBoard.kicad_pcb]
2024-11-01 fixed VUSB net label
    [powerSupplyBoard.kicad_sch]
2024-11-02 added RJ11 and 2-pin JST PH symbols
2024-11-02 finished schematics, organized pages, and fixed ground nets
    [powerSupplyBoard.kicad_sch]
2024-11-02 fixed schematic, organized page, and fixed ground nets
    [battery_charger.kicad_sch]
2024-11-02 updated sch merge. started routing controller stuff
    [powerSupplyBoard.kicad_pcb]
2024-11-02 recalculated Rsense
    [battery_monitor.kicad_sch]
2024-11-02 removed Rsense
    [fuel_gauge.kicad_sch]
2024-11-02 updated sch merger
    [powerSupplyBoard.kicad_pcb]
2024-11-03 fixed GPIO header power net
    [powerSupplyBoard.kicad_pcb]
2024-11-03 added block titles and renamed sheet
    [powerSupplyBoard.kicad_sch]
2024-11-03 fixed component properties and added calculations for resistor dividers
    [fuel_gauge.kicad_sch]
2024-11-03 added block titles and fixed component properties
    [battery_monitor.kicad_sch]
2024-11-03 removed old BMS files
2024-11-03 fixed properties for Tag-Connect and push button
    [powerSupplyBoard.kicad_sch]
2024-11-03 redefined footprint paths
    [battery_charger.kicad_sch]
2024-11-03 re-synced board. adjusted reference labels
    [powerSupplyBoard.kicad_pcb]
2024-11-03 removed footprint
2024-11-03 generated schematic export
2024-11-04 layout for batt charger and connector labels
    [powerSupplyBoard.kicad_pcb]
2024-11-04 removed 1210 footprint
2024-11-04 added footprint for EXLA1V06 inductor
2024-11-04 replaced old 1210 10uF capacitors with 1206 ones
    [battery_charger.kicad_sch]
2024-11-04 replaced 1210 10uF capacitors with 1206 ones and new inductor. moved around capacitors
    [powerSupplyBoard.kicad_pcb]
2024-11-05 added footprint for TI CSD175Q3 PMOS
2024-11-05 added more track widths
2024-11-05 replaced batt charger PMOS
    [battery_charger.kicad_sch]
2024-11-05 rough layout for power stuff
    [powerSupplyBoard.kicad_pcb]
2024-11-06 added some polygons for batt charger
    [powerSupplyBoard.kicad_pcb]
2024-11-07 polygons for balancer
    [powerSupplyBoard.kicad_pcb]
2024-11-07 added 3D model for mosfet
2024-11-09 moved around labels
    [powerSupplyBoard.kicad_pcb]
2024-11-14 updated component references and sizes
    [battery_charger.kicad_sch, battery_monitor.kicad_sch, fuel_gauge.kicad_sch, powerSupplyBoard.kicad_sch]
2024-11-14 added 0402 footprints to lib
2024-11-14 added 0402 components to board
    [powerSupplyBoard.kicad_pcb]
2024-11-14 added drawing and model for enclosure
    [1457N1602.stp]
2024-11-14 stackup, constraints, and board outline
    [mainBoard.kicad_pcb]
2024-11-15 removed gpio header
    [powerSupplyBoard.kicad_sch]
2024-11-15 started adding 0402s
    [powerSupplyBoard.kicad_pcb]
2024-11-15 started schematic for GPS
    [gnssBoard.kicad_sch]
2024-11-15 footprint for M.2 E-key
2024-11-15 footprint for comparator
2024-11-18 switched pads
2024-11-18 removed header pins
    [battery_charger.kicad_sch, fuel_gauge.kicad_sch]
2024-11-18 added LEDs and remapped some pins for easier routing
    [powerSupplyBoard.kicad_sch]
2024-11-18 first attempt at routing complete
    [powerSupplyBoard.kicad_pcb]
2024-11-18 datasheets for LEDs
2024-11-18 model for 0805 LED
2024-11-18 footprint for 0805 LED
2024-11-18 fixed USB resistors. updated sheet name and part refs
    [powerSupplyBoard.kicad_sch]
2024-11-18 updated part refs
    [battery_charger.kicad_sch]
2024-11-18 fixed LEDs. small adjustments
    [powerSupplyBoard.kicad_pcb]
2024-11-18 board and sch exports
2024-11-18 moved board to center of page
    [powerSupplyBoard.kicad_pcb]
2024-11-18 added testpoints
    [battery_charger.kicad_sch, battery_monitor.kicad_sch, fuel_gauge.kicad_sch, powerSupplyBoard.kicad_pcb, powerSupplyBoard.kicad_sch]
2024-11-18 added marker to silkscreen
2024-11-18 testpoint footprint
2024-11-20 deleted old footprints
2024-11-20 modified pin 1 marker
2024-11-20 exported schematics
2024-11-20 cleaned up schematics
    [battery_charger.kicad_sch, battery_monitor.kicad_sch, fuel_gauge.kicad_sch, powerSupplyBoard.kicad_sch]
2024-11-20 cleaned silkscreen and updated footprints
    [powerSupplyBoard.kicad_pcb]
2024-11-21 created gerbers and drill files
    [powerSupplyBoard-B_Cu.gbr, powerSupplyBoard-B_Mask.gbr, powerSupplyBoard-B_Paste.gbr, powerSupplyBoard-B_Silkscreen.gbr, powerSupplyBoard-Edge_Cuts.gbr, powerSupplyBoard-F_Cu.gbr, powerSupplyBoard-F_Mask.gbr, powerSupplyBoard-F_Paste.gbr]
2024-11-21 gerbers path and ERC exclusion
2024-11-22 datasheet for antenna supervisor inductor
2024-11-22 schematic for SparkFun ZED-F9P board
2024-11-22 supervisor stuff
    [gnssBoard.kicad_sch]
2024-11-22 created sheet for zed-f9p. finished schematic and started finding MPNs
    [gnss-module.kicad_sch]
2024-11-22 finished sch and found MPNs
    [gnssBoard.kicad_sch]
2024-11-25 applied netclasses
    [gnss-module.kicad_sch, gnssBoard.kicad_sch]
2024-11-25 added board stackup, constraints, netclasses, and diff pair
    [gnssBoard.kicad_pcb]
2024-11-25 added SparkFun example code for I2C GNSS testing
2024-11-25 bushing for tripod to center post
    [post_bushing.FCStd, post_bushing.stl]
2024-11-25 work on schematic
    [gnss-module.kicad_sch, gnssBoard.kicad_sch]
2024-11-26 added footprint
2024-11-26 convert sparkfun mod board from EAGLE to KiCAD
    [SparkFun_MicroMod_GNSS_Function_Board_ZED-F9P.brd, SparkFun_MicroMod_GNSS_Function_Board_ZED-F9P.sch]
2024-11-26 removed old sch pages
    [battery_monitor.kicad_sch, fuel_gauge.kicad_sch]
2024-11-26 worked on GNSS board
    [gnss-module.kicad_sch, gnssBoard.kicad_pcb, gnssBoard.kicad_sch]
2024-11-26 redoing mode of battery monitoring to simplify layout and troubleshooting
    [battery-manager.kicad_sch, battery_charger.kicad_sch, powerSupplyBoard.kicad_pcb, powerSupplyBoard.kicad_sch]
2024-11-26 Got rid of test points due to space constraints
    [gnss-module.kicad_sch, gnssBoard.kicad_sch]
2024-11-26 finished first attempt at layout
    [gnssBoard.kicad_pcb]
2024-11-26 added DRC exclusion for silkscreen
2024-11-28 added net labels
    [battery_charger.kicad_sch]
2024-11-28 finished schematic and net labels
    [battery-manager.kicad_sch]
2024-11-28 mostly finished layout
    [powerSupplyBoard.kicad_pcb]
2024-11-29 added datasheet for battery connector
2024-11-29 footprints and fixes
2024-11-29 added 3d model for battery connector
2024-11-29 added battery connector and updated date
    [battery-manager.kicad_sch, battery_charger.kicad_sch, powerSupplyBoard.kicad_sch]
2024-11-29 added mounting hole
    [gnssBoard.kicad_sch]
2024-11-29 added mounting hole symbol
2024-11-29 finished routing and passed DRC
    [gnssBoard.kicad_pcb]
2024-12-01 fixed pin 1 designator
2024-12-01 footprint for level shifter
2024-12-01 replaced MOSFETS with TI multi-channel level shifter
    [gnss-module.kicad_sch]
2024-12-01 replaced MOSFETS with level shifter and cleaned up routing. added silkscreen text
    [gnssBoard.kicad_pcb]
2024-12-02 re-added cut traces and test points and flxed keepout for edge connector
    [gnss-module.kicad_sch, gnssBoard.kicad_pcb, gnssBoard.kicad_sch]
2024-12-02 created cellular modem board files
    [cellular-modem.kicad_sch, cellularBoard.kicad_pcb, cellularBoard.kicad_sch]
2024-12-03 exported gerbers
    [powerSupplyBoard-B_Cu.gbr, powerSupplyBoard-B_Mask.gbr, powerSupplyBoard-B_Paste.gbr, powerSupplyBoard-B_Silkscreen.gbr, powerSupplyBoard-Edge_Cuts.gbr, powerSupplyBoard-F_Cu.gbr, powerSupplyBoard-F_Mask.gbr, powerSupplyBoard-F_Paste.gbr]
2024-12-03 reset solder mask web width
    [powerSupplyBoard.kicad_pcb]
2024-12-03 exported BOM
2024-12-03 started on schematics
    [cellular-modem.kicad_sch, cellularBoard.kicad_sch]
2024-12-04 removed SparkFun board
    [SparkFun_MicroMod_GNSS_Function_Board_ZED-F9P.brd, SparkFun_MicroMod_GNSS_Function_Board_ZED-F9P.sch]
2024-12-04 TI WB design outputs for Boost reg
    [WBOperatingValuesDesign15.csv]
2024-12-04 finished schematic
    [cellular-modem.kicad_sch, cellularBoard.kicad_sch]
2024-12-04 moved around vendor defined signals and reset line
    [gnss-module.kicad_sch, gnssBoard.kicad_sch]
2024-12-04 moved around vendor defined and reset line
    [gnssBoard.kicad_pcb]
2024-12-06 replaced LEXI-R52 with SARA-R52
    [cellular-modem.kicad_sch]
2024-12-06 added footprints for cellular board
2024-12-06 assigned footprints and worked on sch
    [cellular-modem.kicad_sch, cellularBoard.kicad_sch]
2024-12-06 removed reset pullup resistor and renumbered others
    [gnss-module.kicad_sch]
2024-12-06 added noconnect flags and removed W_disable net
    [gnssBoard.kicad_sch]
2024-12-06 renumbered resistors. cleaned up tracks
    [gnssBoard.kicad_pcb]
2024-12-17 datasheets for new inductors and +3V3 Vo buck
2024-12-17 datasheet for +3V3 Vo buck
2024-12-17 datasheet for new load resistor
2024-12-17 removed unneeded footprints
2024-12-17 added footprints
2024-12-17 exported new schematic
2024-12-17 worked on LTE card
    [cellular-modem.kicad_sch, cellularBoard.kicad_sch]
2024-12-17 added output vreg and made changed from design review
    [battery-manager.kicad_sch, battery_charger.kicad_sch, powerSupplyBoard.kicad_sch, voltage-regulator.kicad_sch]
2024-12-17 first attempt for layout and routing
    [cellularBoard.kicad_pcb]
2024-12-17 redid layout and made changed from design review
    [powerSupplyBoard.kicad_pcb]
2024-12-19 removed old footprints
2024-12-19 added power switch datasheet
2024-12-19 fixed links and silkscreen
    [powerSupplyBoard.kicad_pcb]
2024-12-21 removed unneeded sheets
    [cellular-modem.kicad_sch, gnss-module.kicad_sch]
2024-12-22 added capacitor model
2024-12-22 fixed silkscreen desig
2024-12-22 added 0402 cap footprint
2024-12-22 fixed footprint
2024-12-22 fixed edge cut and solder mask tol
2024-12-22 added courtyard and fixed solder mask tol
2024-12-22 fixed symbol pin types
2024-12-22 cleaned up schematic
    [cellularBoard.kicad_sch, gnssBoard.kicad_sch]
2024-12-22 cleaned up PCB
    [cellularBoard.kicad_pcb, gnssBoard.kicad_pcb]
2024-12-22 fixed pin types
2024-12-22 fixed ERC
    [battery-manager.kicad_sch, battery_charger.kicad_sch, powerSupplyBoard.kicad_sch, voltage-regulator.kicad_sch]
2024-12-22 fixed output reg source to VSYS
    [powerSupplyBoard.kicad_pcb]
2024-12-23 exported test gerbers
    [gnssBoard-B_Cu.gbr, gnssBoard-B_Mask.gbr, gnssBoard-B_Paste.gbr, gnssBoard-B_Silkscreen.gbr, gnssBoard-Edge_Cuts.gbr, gnssBoard-F_Cu.gbr, gnssBoard-F_Mask.gbr, gnssBoard-F_Paste.gbr]
2024-12-23 fixed soldermask for edge connector
2024-12-23 changed TPs to exempt from BOM
    [cellularBoard.kicad_sch, gnssBoard.kicad_sch]
2024-12-23 cleaned up board and added fiducials
    [cellularBoard.kicad_pcb, gnssBoard.kicad_pcb]
2024-12-23 gerbers and BOM
2024-12-29 convert gnss i2c app to uart
2025-01-01 fixed silkscreen for soldermask expansion
2025-01-01 added note for antenna feedline tracewidth
    [cellularBoard.kicad_sch, gnssBoard.kicad_sch]
2025-01-01 fixed pcb constraints
    [gnssBoard.kicad_pcb]
2025-01-01 fixed PCB constraints and moved vreg for fiducials
    [powerSupplyBoard.kicad_pcb]
2025-01-01 moved components for fiducials
    [cellularBoard.kicad_pcb]
2025-01-01 moved around vreg caps to center around notch
    [cellularBoard.kicad_pcb]
2025-01-01 fixed soldermask bridging
2025-01-14 changes from design review
    [battery-manager.kicad_sch, battery_charger.kicad_sch, cellularBoard.kicad_sch, gnssBoard.kicad_pcb, gnssBoard.kicad_sch, powerSupplyBoard.kicad_sch, voltage-regulator.kicad_sch]
2025-01-15 fixed RF microstrip width
    [cellularBoard.kicad_pcb]
2025-01-15 fixed RF trace width, fixed OE, and added decoupling caps to levelshifter
    [gnssBoard.kicad_pcb, gnssBoard.kicad_sch]
2025-01-15 fixed power nets
    [battery-manager.kicad_sch, battery_charger.kicad_sch, powerSupplyBoard.kicad_pcb, powerSupplyBoard.kicad_sch, voltage-regulator.kicad_sch]
2025-01-22 fixed RF trace width
    [cellularBoard.kicad_pcb]
2025-01-22 netclass and power flags
    [cellularBoard.kicad_sch]
2025-01-22 cell board fp
2025-01-22 cell board symb
2025-01-22 schematic export
2025-01-22 exported and zipped gerbers
    [cellularBoard-B_Cu.gbr, cellularBoard-B_Mask.gbr, cellularBoard-B_Paste.gbr, cellularBoard-B_Silkscreen.gbr, cellularBoard-Edge_Cuts.gbr, cellularBoard-F_Cu.gbr, cellularBoard-F_Mask.gbr, cellularBoard-F_Paste.gbr]
2025-01-22 fixed rf/usb trace width
    [gnssBoard.kicad_pcb]
2025-01-22 export and zip gerbers
    [gnssBoard-B_Cu.gbr, gnssBoard-B_Mask.gbr, gnssBoard-B_Paste.gbr, gnssBoard-B_Silkscreen.gbr, gnssBoard-Edge_Cuts.gbr, gnssBoard-F_Cu.gbr, gnssBoard-F_Mask.gbr, gnssBoard-F_Paste.gbr]
2025-01-22 fixed design review changes (power nets)
    [battery-manager.kicad_sch, battery_charger.kicad_sch, powerSupplyBoard.kicad_sch, voltage-regulator.kicad_sch]
2025-01-22 fixed power nets and labels
    [powerSupplyBoard.kicad_pcb]
2025-01-22 export BOM
2025-01-30 change drill size
2025-01-30 added castellated pad property
    [gnssBoard.kicad_pcb]
2025-01-30 updated screw footprint
    [cellularBoard.kicad_pcb]
2025-01-30 updated screw fp
2025-01-30 BOM for battery pack
    [batteryPack_bom.csv]
2025-02-03 added board dimensions
    [mainBoard.kicad_pcb]
2025-02-04 added datasheet for USB-C connector
2025-02-04 footprint for USB-C connector
2025-02-04 model for USB-C connector
2025-02-04 created connectors FP lib
2025-02-04 added datasheets for connectors
2025-02-04 removed datasheet for old USB connector
2025-02-04 removed old USB connector
2025-02-05 added models for connectors
2025-02-05 added resources for cables
    [8AP-02AMMM-SL7AXX-STP.stp, 8P-04AMMM-SL7AXX-STP.stp]
2025-02-05 added datasheet for temp/humd sensor
2025-02-11 added datasheet for humidity sensor connector
2025-02-11 fp for solar panel connector
2025-02-11 fp for humidity sensor connector
2025-02-11 fp for RJ45 connector
2025-02-11 fp for USB-C connector
2025-02-11 changed stackup and constraints to OSHPark 4-layer
    [mainBoard.kicad_pcb]
2025-02-19 added connector model
2025-02-19 added connector models
2025-02-19 added STM32H745 footprint
2025-02-19 small changes
    [mainBoard.kicad_sch, microcontroller.kicad_sch]
2025-02-21 app note for STM32H7
2025-02-21 nucleo dev board files
2025-02-21 added power symbol lib
2025-02-21 working on microcontroller schematic
    [microcontroller.kicad_sch]
2025-02-21 added power lib
2025-02-24 app notes and example schematics for STM32H745
2025-02-24 removed nucleo cad files
2025-02-24 created schematic pages
    [clocks.kicad_sch, stm32h745_power_supplies.kicad_sch, usb.kicad_sch]
2025-02-24 renamed schematic page
    [microcontroller.kicad_sch]
2025-02-24 added busses for uC
    [stm32h745_io.kicad_sch]
2025-02-24 added child pages
    [mainBoard.kicad_sch]
2025-02-25 generated screenshots of battery pack
2025-02-25 added sheets
    [auxillaryCard.kicad_sch, eps.kicad_sch, gnss.kicad_sch, lte.kicad_sch, rfInterface.kicad_sch]
2025-02-25 added ethernet oscillator
    [clocks.kicad_sch]
2025-02-25 added ethernet controller and 8P8C jack
    [ethernet.kicad_sch]
2025-02-25 renamed USB net
    [stm32h745_io.kicad_sch]
2025-02-25 added USB PD and Hub circuitry
    [usb.kicad_sch]
2025-02-25 upgraded to KiCad v9
    [battery-manager.kicad_sch, battery_charger.kicad_sch, powerSupplyBoard.kicad_sch, voltage-regulator.kicad_sch]
2025-02-27 exported new schematic rev
2025-02-27 updated revision number
    [battery-manager.kicad_sch, battery_charger.kicad_sch, voltage-regulator.kicad_sch]
2025-02-27 switched uC with K8U6 variant (more flash)
    [powerSupplyBoard.kicad_sch]
2025-02-27 renamed EPS board schematic
    [eps.kicad_sch, epsController.kicad_sch]
2025-02-27 added sheet
    [auxillaryCard.kicad_sch]
2025-02-27 added battery charger sheets from powerSupply project
    [batteryCharger.kicad_sch, batteryManager.kicad_sch]
2025-02-27 added clocks for STM32 and Ethernet
    [clocks.kicad_sch]
2025-02-27 added Ethernet and transceiver
    [ethernet.kicad_sch]
2025-02-27 added GNSS card circuitry
    [gnss.kicad_sch]
2025-02-27 added LTE card circuitry
    [lte.kicad_sch]
2025-02-27 added IO
    [stm32h745_io.kicad_sch]
2025-02-27 added sub sheets
    [mainBoard.kicad_sch]
2025-02-27 power supplies for H745
    [stm32h745_power_supplies.kicad_sch]
2025-02-27 usb PD and hub
    [usb.kicad_sch]
2025-02-27 3x regs for system voltage
    [voltageRegulators.kicad_sch]
2025-02-27 replaced uC with 64KB var. upgraded to KiCad v9
    [powerSupplyBoard.kicad_pcb]
2025-03-03 added app notes for BMS stuff
2025-03-03 upgraded to v9
    [cellularBoard.kicad_pcb, gnssBoard.kicad_pcb, gnssBoard.kicad_sch]
2025-03-03 renamed sheet
    [auxillaryCard.kicad_sch]
2025-03-03 added jumpers
    [batteryCharger.kicad_sch]
2025-03-03 replaced balancer IC
    [batteryManager.kicad_sch]
2025-03-03 updated date
    [clocks.kicad_sch]
2025-03-03 fixed child sheet pins
    [epsController.kicad_sch]
2025-03-03 organized schematic
    [ethernet.kicad_sch]
2025-03-03 updated date. fixed sheet size
    [rfInterface.kicad_sch]
2025-03-03 fixed inductor
    [stm32h745_power_supplies.kicad_sch]
2025-03-03 replaced PD IC
    [usb.kicad_sch]
2025-03-03 fixed vreg from WEBENCH results
    [voltageRegulators.kicad_sch]
2025-03-04 imported new pins from vreg
    [epsController.kicad_sch]
2025-03-04 finished(?) USB PD
    [usb.kicad_sch]
2025-03-04 added new 4-channel vreg
    [voltageRegulators.kicad_sch]
2025-03-07 added buck converter efficiency app note
2025-03-07 updated to v9
    [cellularBoard.kicad_sch]
2025-03-07 pspice stuff
    [TPS543B22RYS_TRANS.OLB, TPS543B22_TRANS.DSN, tps543b22_trans.opj]
2025-03-07 added aux card hardware
    [auxillaryCard.kicad_sch]
2025-03-07 heiarchical sheet pins
    [batteryCharger.kicad_sch]
2025-03-07 replaced manager. sheet pins
    [batteryManager.kicad_sch]
2025-03-07 updated sheet number
    [clocks.kicad_sch]
2025-03-07 sheet pins and CAN transceiver
    [epsController.kicad_sch]
2025-03-07 bus pins and sheet number
    [ethernet.kicad_sch]
2025-03-07 added signal level switch for level shifter
    [gnss.kicad_sch, lte.kicad_sch]
2025-03-07 added GPIO for AUX card, EPS controller
    [mainBoard.kicad_sch]
2025-03-07 added GPIO
    [stm32h745_io.kicad_sch]
2025-03-07 updated sheet number and date
    [stm32h745_power_supplies.kicad_sch]
2025-03-07 moved to EPS
    [usb_pd.kicad_sch]
2025-03-07 moved PD to EPS
    [usb.kicad_sch]
2025-03-07 added regulators for 5V, 3V3, 1V8, and 1V1
    [voltageRegulators.kicad_sch]
2025-03-07 added test programs for power board
2025-03-07 power board hello world
2025-03-12 resistor divider calc
2025-03-12 added components for aux card
    [auxillaryCard.kicad_sch]
2025-03-12 fixed schematic
    [batteryCharger.kicad_sch]
2025-03-12 added new battery manager
    [batteryManager.kicad_sch]
2025-03-12 added clocks
    [clocks.kicad_sch]
2025-03-12 added schematic
    [environmentalSensors.kicad_sch]
2025-03-12 fixed pinouts
    [epsController.kicad_sch]
2025-03-12 fixed nets
    [ethernet.kicad_sch]
2025-03-12 added hw for GNSS card
    [gnss.kicad_sch]
2025-03-12 added hw for LTE card
    [lte.kicad_sch]
2025-03-12 added nets to sheets
    [mainBoard.kicad_sch]
2025-03-12 added external memory sch
    [memory.kicad_sch]
2025-03-12 added rf interface sch
    [rfInterface.kicad_sch]
2025-03-12 added part numbers
    [stm32h745_power_supplies.kicad_sch]
2025-03-12 replaced capacitors with tants
    [usb_pd.kicad_sch]
2025-03-12 moved PD to new sheet
    [usb.kicad_sch]
2025-03-12 added part numbers and stuff
    [voltageRegulators.kicad_sch]
2025-03-12 removed usb hub circuitry
    [usb.kicad_sch]
2025-03-12 removed USB PD
    [usb_pd.kicad_sch]
2025-03-14 renamed schematics
    [auxillaryCard.kicad_sch, environmentalSensors.kicad_sch, stm32h745_io.kicad_sch]
2025-03-14 removed schematics
    [power.kicad_sch, stm32h745_power_supplies.kicad_sch, usb.kicad_sch]
2025-03-14 added power symbols
2025-03-14 removed USB clock
    [clocks.kicad_sch]
2025-03-14 moved power to this schematic
    [stm32h745.kicad_sch]
2025-03-14 got rid of 5V and 1V1 regs
    [voltageRegulators.kicad_sch]
2025-03-14 fixed net names and power flags
    [ethernet.kicad_sch]
2025-03-14 fixed power flags
    [gnss.kicad_sch, lte.kicad_sch, memory.kicad_sch, rfInterface.kicad_sch]
2025-03-14 reorganized sheet
    [mainBoard.kicad_sch]
2025-03-14 added capacitor datasheets
2025-03-14 updated capacitors
    [auxillary.kicad_sch, batteryCharger.kicad_sch, batteryManager.kicad_sch, clocks.kicad_sch, epsController.kicad_sch, ethernet.kicad_sch, gnss.kicad_sch, lte.kicad_sch]
2025-03-15 added testpoints and fixed AGND
    [batteryCharger.kicad_sch, batteryManager.kicad_sch]
2025-03-15 replaced 3V3 reg with more efficient one
    [voltageRegulators.kicad_sch]
2025-03-15 exported schematic to pdf
2025-03-16 updated symbol refs
    [auxillary.kicad_sch, batteryCharger.kicad_sch, batteryManager.kicad_sch, clocks.kicad_sch, epsController.kicad_sch, ethernet.kicad_sch, gnss.kicad_sch, lte.kicad_sch]
2025-03-16 added usr LED
    [stm32h745.kicad_sch]
2025-03-16 added comments for vregs
    [voltageRegulators.kicad_sch]
2025-03-16 3v3 reg sim
    [LM5148_LM25148_quickstart_calculator_A4.xlsm]
2025-03-16 moved CAN transceivers to their own page
    [canTransceivers.kicad_sch, epsController.kicad_sch, mainBoard.kicad_sch, stm32h745.kicad_sch]
2025-03-16 added ground strap
2025-03-16 fixed STEMMA QT SCL pin
2025-03-16 fixed RXD/TXD
    [gnssBoard.kicad_pcb, gnssBoard.kicad_sch]
2025-03-18 assigned FPs
    [auxillary.kicad_sch, batteryCharger.kicad_sch, batteryManager.kicad_sch, canTransceivers.kicad_sch, clocks.kicad_sch, epsController.kicad_sch, ethernet.kicad_sch, gnss.kicad_sch]
2025-03-19 replaced Zener diode
2025-03-19 redid diode pin numbers to be correct
2025-03-19 added footprints to symbols
    [auxillary.kicad_sch, batteryManager.kicad_sch, epsController.kicad_sch, lte.kicad_sch, memory.kicad_sch, stm32h745.kicad_sch, voltageRegulators.kicad_sch]
2025-03-20 added footprints and assigned models
2025-03-20 assigned footprints
    [auxillary.kicad_sch, batteryCharger.kicad_sch, batteryManager.kicad_sch, canTransceivers.kicad_sch, clocks.kicad_sch, epsController.kicad_sch, ethernet.kicad_sch, gnss.kicad_sch]
2025-03-22 assigned 3D models to footprints
2025-03-22 updated ref designators
    [batteryCharger.kicad_sch, batteryManager.kicad_sch, clocks.kicad_sch, epsController.kicad_sch, memory.kicad_sch, sensors.kicad_sch, voltageRegulators.kicad_sch]
2025-03-22 added UART RX/TX fixer pads for 0R resistors
    [auxillary.kicad_sch, gnss.kicad_sch, lte.kicad_sch]
2025-03-22 assigned net classes
    [ethernet.kicad_sch, rfInterface.kicad_sch, stm32h745.kicad_sch]
2025-03-22 added board-edge keepout for enclosure rails and repositioned IO/RF connectors
    [mainBoard.kicad_pcb]
2025-03-22 fixed solder paste layer
2025-03-25 added datasheet for current shunt
2025-03-25 fixed sch
    [auxillary.kicad_sch, batteryCharger.kicad_sch, batteryManager.kicad_sch, canTransceivers.kicad_sch, gnss.kicad_sch, lte.kicad_sch, mainBoard.kicad_pcb, rfInterface.kicad_sch]
2025-03-29 updated footprints
2025-03-29 PCBWay stackups
2025-03-29 minor changes
    [batteryCharger.kicad_sch, batteryManager.kicad_sch, canTransceivers.kicad_sch, mainBoard.kicad_pcb, stm32h745.kicad_sch, voltageRegulators.kicad_sch]
2025-03-31 exported schematic
2025-03-31 created I2C scanner for M.2 card shield
2025-03-31 fixed VBIAS net
    [auxillary.kicad_sch, gnss.kicad_sch, lte.kicad_sch]
2025-03-31 updated sheet date
    [batteryCharger.kicad_sch, batteryManager.kicad_sch, canTransceivers.kicad_sch, clocks.kicad_sch, epsController.kicad_sch, ethernet.kicad_sch, mainBoard.kicad_sch, memory.kicad_sch]
2025-03-31 worked on polygons and 3V3 reg routing
    [mainBoard.kicad_pcb]
2025-04-01 redefined symbol refs
    [auxillary.kicad_sch, batteryCharger.kicad_sch, batteryManager.kicad_sch, canTransceivers.kicad_sch, epsController.kicad_sch, gnss.kicad_sch, lte.kicad_sch, rfInterface.kicad_sch]
2025-04-01 added program to test antenna supervisor
2025-04-02 added debugger stuff
    [canTransceivers.kicad_sch, clocks.kicad_sch, debugger_h7.kicad_sch, debugger_l0.kicad_sch, epsController.kicad_sch]
2025-04-02 added debugger sheet
    [mainBoard.kicad_sch]
2025-04-02 moved STEMA QT connectors to debugger sheets
    [sensors.kicad_sch]
2025-04-02 fixed jumper sim flag
    [voltageRegulators.kicad_sch]
2025-04-04 debugger stuff
    [batteryManager.kicad_sch, canTransceivers.kicad_sch, debugger_l0.kicad_sch, epsController.kicad_sch, stm32h745.kicad_sch]
2025-04-07 stm32cubeide project creation
2025-04-07 nucleo design files
    [Connectors.SchDoc, Ethernet.SchDoc, MB1137.PcbLib, MB1137.PrjPCB, MB1137.SCHLIB, MB1137.SchDoc, MCU_144.SchDoc, ST_LINK_V2-1.SCHDOC]
2025-04-07 broke board with on-board debuggers off into new project
    [LM5148_LM25148_quickstart_calculator_A4.xlsm, TPS543B22RYS_TRANS.OLB, TPS543B22_TRANS.DSN, auxillary.kicad_sch, batteryCharger.kicad_sch, batteryManager.kicad_sch, canTransceivers.kicad_sch, clocks.kicad_sch]
2025-04-07 fixed rx/tx
    [auxillary.kicad_sch, lte.kicad_sch]
2025-04-07 removed debugger sheets
    [canTransceivers.kicad_sch, debugger_h7.kicad_sch, debugger_l0.kicad_sch]
2025-04-07 removed debugger clocks
    [clocks.kicad_sch]
2025-04-07 replaced uC
    [epsController.kicad_sch]
2025-04-07 fixed net names
    [ethernet.kicad_sch]
2025-04-07 heiarchical sheets
    [mainBoard.kicad_sch]
2025-04-07 synced board
2025-04-08 moved USB port to USB hub page
    [batteryCharger.kicad_sch]
2025-04-08 fixed net names and added notes
    [auxillary.kicad_sch, gnss.kicad_sch, lte.kicad_sch]
2025-04-08 added 24MHz clock for USB Hub
    [clocks.kicad_sch]
2025-04-08 fixed nets, added NeoPixel, and added EEPROM
    [epsController.kicad_sch]
2025-04-08 fixed power and net names
    [mainBoard.kicad_sch]
2025-04-08 added USB hub for STM32L0/STM32H7 DFU
    [usb_hub.kicad_sch]
2025-04-08 added STEMMA-QT connector
    [auxillary.kicad_sch, gnss.kicad_sch, lte.kicad_sch, memory.kicad_sch]
2025-04-08 renumber references
    [batteryCharger.kicad_sch, batteryManager.kicad_sch, canTransceivers.kicad_sch, clocks.kicad_sch, epsController.kicad_sch, ethernet.kicad_sch, rfInterface.kicad_sch, sensors.kicad_sch]
2025-04-08 sync board to schematic
2025-04-13 removed pin highlights
2025-04-13 updated sheet size
    [auxillary.kicad_sch, batteryCharger.kicad_sch, batteryManager.kicad_sch, canTransceivers.kicad_sch, gnss.kicad_sch, lte.kicad_sch, memory.kicad_sch, rfInterface.kicad_sch]
2025-04-13 page size
    [clocks.kicad_sch, epsController.kicad_sch, ethernet.kicad_sch, mainBoard.kicad_sch, usb_hub.kicad_sch, voltageRegulators.kicad_sch]
2025-04-13 reorganized and fixed power supplies
2025-04-13 power supplies and organization
    [stm32h745.kicad_sch]
2025-04-14 removed old sims
    [LM5148_LM25148_quickstart_calculator_A4.xlsm]
2025-04-14 removed spice stuff
    [TPS543B22RYS_TRANS.OLB, TPS543B22_TRANS.DSN, tps543b22_trans.opj]
2025-04-14 organized pages. added notes and net flags
    [auxillary.kicad_sch, batteryCharger.kicad_sch, batteryManager.kicad_sch, canTransceivers.kicad_sch, gnss.kicad_sch, lte.kicad_sch, memory.kicad_sch, sensors.kicad_sch]
2025-04-14 removed redundant clocks. added termination resistors
    [clocks.kicad_sch]
2025-04-14 added SPI and other signals. organized page
    [epsController.kicad_sch]
2025-04-14 added pulse transformer, organized page, and added notes
    [ethernet.kicad_sch]
2025-04-14 organized heiarchical sheet pins
    [mainBoard.kicad_sch]
2025-04-14 added test points for GNSS LNA/splitter
    [rfInterface.kicad_sch]
2025-04-14 organized page. Added SPI and other nets
    [stm32h745.kicad_sch]
2025-04-14 replaced 3V3 reg with simpler design. Added 4V5 SMPS and 4V0 LDO for GNSS LNA
    [voltageRegulators.kicad_sch]
2025-04-15 added NAND flash
    [memory.kicad_sch]
2025-04-15 added mounting hole FP
2025-04-15 added M3 mounting holes
    [mainBoard.kicad_sch]
2025-04-15 added mounting holes
2025-04-15 upaed sheet date
    [auxillary.kicad_sch, batteryCharger.kicad_sch, batteryManager.kicad_sch, canTransceivers.kicad_sch, clocks.kicad_sch, epsController.kicad_sch, ethernet.kicad_sch, gnss.kicad_sch]
2025-04-15 moved to OneDrive
    [LM5148_LM25148_quickstart_calculator_A4.xlsm, TPS543B22RYS_TRANS.OLB, TPS543B22_TRANS.DSN, auxillary.kicad_sch, batteryCharger.kicad_sch, batteryManager.kicad_sch, canTransceivers.kicad_sch, clocks.kicad_sch]
2025-04-16 prototype to test RF LNA+splitter independently
    [rfSplitterPrototype.kicad_pcb, rfSplitterPrototype.kicad_sch]
2025-04-21 added TVS diodes
    [ethernet.kicad_sch]
2025-04-21 swapped main connector with 4pin M8
    [batteryCharger.kicad_sch]
2025-04-21 replaced MiniCircuits LNA with Infineon one. Added bias-tee to input and output
    [rfInterface.kicad_sch]
2025-04-21 worked on RF splitter
    [rfSplitterPrototype.kicad_pcb, rfSplitterPrototype.kicad_sch]
2025-04-21 added 4pin M8 connector for power in. Nudged TNC connector
2025-04-21 rough model of battery
    [battery-Body.step, battery.FCStd]
2025-04-21 renamed file
    [1457N1602.STEP]
2025-04-26 fully integrated mechanical model
    [Unnamed1.FCStd]
2025-04-26 added datasheet for new SMA connector
2025-04-26 new SMA connector model
2025-04-26 footprint cache
2025-04-26 footprint for new SMA connector
2025-04-26 app note for integrating LPS28 sensor
2025-04-26 nudged connectors around to fit in enclosure better
2025-04-26 FPC connector datasheet
2025-04-26 created breakout board for LPS28 sensor
    [lps28dfwBreakoutBoard.kicad_pcb, lps28dfwBreakoutBoard.kicad_sch]
2025-04-30 updated with new LNA
    [rfSplitterPrototype.kicad_pcb, rfSplitterPrototype.kicad_sch]
2025-04-30 fixed EN/PG pins for updated regs
    [epsController.kicad_sch]
2025-04-30 removed boost
    [voltageRegulators.kicad_sch]
2025-04-30 added LNA pins
    [stm32h745.kicad_sch]
2025-04-30 added LNA control pins
    [mainBoard.kicad_sch]
2025-04-30 silkscreen stuff
2025-04-30 fixed board edge by TNC
2025-05-02 added datasheets
    [auxillary.kicad_sch, batteryCharger.kicad_sch, batteryManager.kicad_sch, canTransceivers.kicad_sch, clocks.kicad_sch, epsController.kicad_sch, ethernet.kicad_sch, gnss.kicad_sch]
2025-05-02 increased silkscreen linewidth
2025-05-02 changed UART5 to UART5
    [gnss.kicad_sch, mainBoard.kicad_sch, stm32h745.kicad_sch]
2025-05-02 replotted schematic
2025-05-14 back panel for enclosure
    [backPanel.kicad_pcb, backPanel.kicad_sch]
2025-05-14 front panel for enclosure
    [frontPanel.kicad_pcb, frontPanel.kicad_sch]
2025-05-14 FFC breakout board for pressure sensor
    [LPS28_assembly.FCStd, LPS28_breakoutBoard_Mount.FCStd, lps28_breakoutBoard.FCStd]
2025-05-14 changes from routing
    [auxillary.kicad_sch, batteryCharger.kicad_sch, batteryManager.kicad_sch, canTransceivers.kicad_sch, clocks.kicad_sch, epsController.kicad_sch, ethernet.kicad_sch, gnss.kicad_sch]
2025-05-14 export stencil files for pricing
    [mainBoard-B_Paste.gbr, mainBoard-Edge_Cuts.gbr, mainBoard-F_Paste.gbr, mainBoard-job.gbrjob]
2025-05-14 test fitting things
    [assembly.FCStd, enclosure.FCStd, frontPanel.FCStd]
2025-05-14 fixes for DRC
    [auxillary.kicad_sch, canTransceivers.kicad_sch, ethernet.kicad_sch, gnss.kicad_sch, lte.kicad_sch, memory.kicad_sch, usb_hub.kicad_sch]
2025-05-17 removed unused footprints and models
2025-05-17 front/back enclosure panels
    [backPanel.kicad_pcb, frontPanel.kicad_pcb]
2025-05-17 updated board and exports
    [lps28dfwBreakoutBoard-F_Paste.gbr]
2025-05-17 updated symbols, refs, and date
    [auxillary.kicad_sch, batteryCharger.kicad_sch, batteryManager.kicad_sch, canTransceivers.kicad_sch, ethernet.kicad_sch, gnss.kicad_sch, lte.kicad_sch, mainBoard.kicad_sch]
2025-05-17 removed screw
2025-05-17 saved screw version here
    [7793.STEP]
2025-05-17 export of DigiKey BOM
    [Awohali_Mainboard_BOM_DigiKey.xlsx]
2025-05-17 gerber exports
2025-05-17 re-exported gerbers
    [mainBoard-B_Courtyard.gbr, mainBoard-B_Cu.gbr, mainBoard-B_Fab.gbr, mainBoard-B_Mask.gbr, mainBoard-B_Paste.gbr, mainBoard-Edge_Cuts.gbr, mainBoard-F_Courtyard.gbr, mainBoard-F_Cu.gbr]
2025-05-17 re-exported schematics
2025-05-17 Added Awohali in Cherokee on the back silkscreen
2025-05-19 created backup slots for SHT41 cutout
2025-05-21 retextured 3D models
    [cellularBoard.kicad_pcb, cellularBoard.kicad_sch]
2025-05-22 moved files to OneDrive
    [Connectors.SchDoc, Ethernet.SchDoc, MB1137.PcbLib, MB1137.PrjPCB, MB1137.SCHLIB, MB1137.SchDoc, MCU_144.SchDoc, ST_LINK_V2-1.SCHDOC]
2025-05-22 updated datasheet refs
    [cellularBoard.kicad_pcb, cellularBoard.kicad_sch, gnssBoard.kicad_pcb, gnssBoard.kicad_sch]
2025-05-22 moved to mechanical folder
    [LPS28_assembly.FCStd, LPS28_breakoutBoard_Mount.FCStd, lps28_breakoutBoard.FCStd]
2025-05-22 moved from electronics folder
    [LPS28_assembly.FCStd, LPS28_breakoutBoard_Mount.FCStd, lps28_breakoutBoard.FCStd]
2025-05-25 changed label from NOR flash to NAND flash
    [memory.kicad_sch]
2025-05-31 3d models for mounting stuff to the tripod
    [endCapHood-Body.3mf, endCapHood.3mf, endCapHood.FCStd, endCapHoodClamp.3mf, endCapHoodClamp.FCStd, lteAntennaMount.3mf, lteAntennaMount.FCStd, tripodFootCover.3mf]
2025-07-01 fixed diodes
    [auxillary.kicad_sch, batteryCharger.kicad_sch, batteryManager.kicad_sch, canTransceivers.kicad_sch, clocks.kicad_sch, epsController.kicad_sch, ethernet.kicad_sch, gnss.kicad_sch]
2025-07-01 moved out of repository
    [cellularBoard-B_Cu.gbr, cellularBoard-B_Mask.gbr, cellularBoard-B_Paste.gbr, cellularBoard-B_Silkscreen.gbr, cellularBoard-Edge_Cuts.gbr, cellularBoard-F_Cu.gbr, cellularBoard-F_Mask.gbr, cellularBoard-F_Paste.gbr]
2025-07-01 added prototype drivers
2025-07-14 test files for bat charger driver
2025-07-14 driver for LPS28. Arduino support so far
2025-07-14 sht4x driver. Arduino support so far
2025-07-21 renamed files
    [endCapHood-Body.3mf, endCapHood.3mf, endCapHood.FCStd, endCapHoodClamp.FCStd]
2025-07-21 driver test for BQ25798
2025-07-27 started writing driver for BQ76905
2025-08-04 wrote driver for external humd/temp sensor
2025-08-04 Driver for USB2422 USB Hub
2025-08-04 fixed neopixel driver and added examples
    [example_stm32.c, example_zephyr.c, main.cpp, neopixel_platform.h, neopixel_platform_arduino.cpp, neopixel_platform_stm32.c, neopixel_platform_zephyr.c]
2025-08-06 example sketch for NeoPixel driver
2025-08-06 reset boot and reset pins on both uCs
    [02_set_pins.ioc, main.c, main.h]
2025-08-06 created sketch to scan for i2c devices
2025-08-06 recreated driver files
2025-08-06 fixed USB2422 driver
2025-08-06 Requirements to program Feather and get serial print
2025-08-06 example for USB2422 driver
2025-08-07 i2c debug sketch
2025-08-07 i2c scanner stuff
2025-08-07 Revert "added more SMBus stuff"
    This reverts commit fe2ea378ec2bcaab5c0dc0f1be594bf969603cd9.
    [i2c_register_interface.ino]
2025-08-08 fixed? Full stop/start cycles
    [i2c_register_interface.ino]
2025-08-08 previous one broke it again. maybe this will fix it
    [i2c_register_interface.ino]
2025-08-08 fixed I2C read/write formatting.
    Needed block read/write
    [main.cpp, usb2422_platform_arduino.cpp]
2025-08-08 fixed code and added stuff to lock the settings
    Does work
    [main.cpp, usb2422_platform_arduino.cpp]
2025-08-11 added missing charger statuses
    [main.cpp]
2025-08-11 enable the ADC before collecting measurements. it likes to turn off
2025-08-11 created CLI for batt charger
2025-08-11 added BQ25798 CE pin
2025-08-13 added short delay to make sure ADC is enabled before making measurements
2025-08-13 added step to set ADC to continuous mode
2025-08-13 raised vsysmin to 7.0V
2025-08-13 replaced with corrected version from basic_usage
    [bq25798.c]
2025-08-15 added generic i2c write function
2025-08-15 added generic i2c read function
2025-08-18 rewriting GNSS driver
2025-08-18 removed basic I2C init. need to do in main code
2025-08-18 set init flag to false at beginning of init stage
2025-08-18 removed unneeded wire instance
2025-08-18 init i2c stuff
2025-08-18 init uart stuff
2025-08-18 gnss driver stuff
2025-08-19 rewrote GNSS driver
2025-09-10 updated driver to better handle UBX commands. added layer param to config functions.
2025-09-10 fixed typedefs and rearanged stuff
    [main.cpp]
2025-09-11 fixed driver
2025-09-11 testing parsing UBX data file
    [rawx.csv]
2025-09-11 switched data message type
2025-09-14 fixed driver i think. added script to record data
    [main.cpp, zedf9p_platform_arduino.cpp]
2025-09-15 changes ig
    [GNSS011.csv]
2025-09-18 finally got GPS logging working
    [GNSS001.csv, GNSS001_hpposllh.csv, GNSS001_rawx.csv, GNSS002_hpposllh.csv, GNSS002_rawx.csv, GNSS004.csv, GNSS006_hpposllh.csv, GNSS006_rawx.csv]
2025-09-18 new data files
    [GNSS002_hpposllh.csv, GNSS002_rawx.csv, GNSS003_hpposllh.csv, GNSS003_rawx.csv, GNSS004.csv, GNSS006_hpposllh.csv, GNSS006_rawx.csv]
2025-09-18 fixed timing and disabled galileo and glonass
    [main.c]
2025-09-18 new data
    [GNSS007_hpposllh.csv, GNSS007_rawx.csv]
2025-09-19 new data!
    [GNSS004_hpposllh.csv, GNSS004_pvt.csv, GNSS004_rawx.csv, GNSS008_hpposllh.csv, GNSS008_rawx.csv, GNSS009_hpposllh.csv, GNSS009_pvt.csv, GNSS009_rawx.csv]
2025-09-19 moved data
    [GNSS001_hpposllh.csv, GNSS001_rawx.csv, GNSS002_hpposllh.csv, GNSS002_rawx.csv, GNSS003_hpposllh.csv, GNSS003_rawx.csv, GNSS004_hpposllh.csv, GNSS004_pvt.csv]
2025-09-19 added Galileo sats and reverted message rate back to 1Hz
    [main.c]
2025-09-23 more data
    [GNSS001_hpposllh.csv, GNSS001_pvt.csv, GNSS001_rawx.csv]
2025-09-23 setup gnss logging stm32 projects for both cores
2025-09-28 trying to fix RAWX nav rate
    [main.c]
2025-09-28 finally, some good data
    [GNSS002_hpposllh.csv, GNSS002_pvt.csv, GNSS002_rawx.csv]
2025-09-29 fixed for logging more messages
    [main.c, zedf9p.c, zedf9p.h]
2025-09-29 copied latest driver to src folder
2025-10-03 processed new data
    [GNSS001_NAV_CLOCK.csv, GNSS001_NAV_HPPOSECEF.csv, GNSS001_NAV_HPPOSLLH.csv, GNSS001_NAV_TIMEUTC.csv, GNSS002_NAV_CLOCK.csv, GNSS002_NAV_HPPOSECEF.csv, GNSS002_NAV_HPPOSLLH.csv, GNSS002_NAV_TIMEUTC.csv]
2025-10-05 fixing code to log on mainboard
    [main.c, main.h, usb2422.c, usb2422.h, zedf9p.c, zedf9p.h]
2025-10-08 test to init usb hub with STM32H745
2025-10-08 moved to new temp dir until other system stuff is fixed
    [main.c, main.h, usb2422.c, usb2422.h, usb2422_configuration.c, usb2422_platform.h, usb2422_platform_stm32cube.c, zedf9p.c]
2025-10-15 fixed blink code location
    [main.c]
2025-11-13 exported cad
    [Awohali_End_Caps.3mf, Unnamed1.FCStd, assembly.FCStd, backPanel.FCStd, backPanel.step, endCapHood-Body.3mf, endCapHoodClamp-Body.3mf, frontPanel.FCStd]
2025-11-14 moved to data folder
    [GNSS001.csv, GNSS001_NAV_CLOCK.csv, GNSS001_NAV_HPPOSECEF.csv, GNSS001_NAV_HPPOSLLH.csv, GNSS001_NAV_TIMEUTC.csv, GNSS001_RXM_RAWX.csv, GNSS001_hpposllh.csv, GNSS001_pvt.csv]
2025-11-18 exported model for LPS28 mount
    [LPS28_breakoutBoard_Mount.3mf, LPS28_breakoutBoard_Mount.stl]
2025-11-21 fixed mount profiles
    [LPS28_breakoutBoard_Mount.3mf, LPS28_breakoutBoard_Mount.FCStd]
2025-11-24 Working on fixing timing issues
    [2025-10-3_175741_serial-COM4_NAV_CLOCK.csv, 2025-10-3_175741_serial-COM4_NAV_HPPOSECEF.csv, 2025-10-3_175741_serial-COM4_NAV_HPPOSLLH.csv, 2025-10-3_175741_serial-COM4_NAV_TIMEUTC.csv, 2025-10-3_175741_serial-COM4_RXM_RAWX.csv, 2025-10-3_175741_serial-COM4_RXM_SFRBX.csv]
2025-11-25 fixed printf type formatting and temporarily disabled coordinate logging
    [main.c]
2025-11-25 removed CSVs
    [2025-11-25_93138_serial-COM3_NAV_CLOCK.csv, 2025-11-25_93138_serial-COM3_NAV_TIMEUTC.csv]
2025-11-26 without utc timestamp
    [GNSS001_NAV_CLOCK_wo_timestamp.csv, GNSS001_RXM_RAWX_wo_timestamp.csv]
2025-11-30 fixes to code to process all data
    [RINEXNavParser.py, RINEXObsParser.py]
2025-11-30 ormond beach data
    [ormd3290_GPS_excerpt.csv, ormd3290_Galileo_excerpt.csv]
2025-11-30 sample data
    [cat20010.csv]
2025-11-30 parsed ubx data
    [2025-11-25_93138_serial-COM3_NAV_CLOCK.csv, 2025-11-25_93138_serial-COM3_NAV_TIMEUTC.csv]
2025-12-03 csv output from db
    [G01_L1 C.csv]
2025-12-20 simplified code and added more message types in driver
2025-12-20 updated driver
2025-12-27 trying to port datalogger code to Pico-SDK
2025-12-27 Pico SDK version of gnss datalogger
2025-12-27 added UART DMA control
2025-12-27 re-plotted schematics and layout files
2026-02-17 fixed page name spelling
    [auxillary.kicad_sch]
2026-02-26 fixed file names
    [canTransceivers.kicad_sch, ethernet.kicad_sch, usb_hub.kicad_sch]
2026-02-27 define all pins for H7 part of board
2026-02-27 fixed pin directions
    [mainBoard.kicad_sch, stm32h745.kicad_sch]
2026-02-27 board defs for H7 microcontroller
2026-03-02 added i2c scanner app
2026-03-02 added i2c scan app
2026-03-02 added lps2xdf sample app
2026-03-02 added sht4x sample app
2026-03-02 renames and add devicetree bindings for ICs
2026-03-03 renamed board
2026-03-03 devicetree bindings for ICs
2026-03-12 added board varients
2026-03-12 fixed board defs for the L433 uC
2026-03-12 started to fix board defs for the H745 uC
2026-03-12 added more board defs
2026-03-12 changed print
2026-03-13 fixed Galileo ephemeris code
    [SFRBXParser_galileo_new.py]
2026-03-17 correct el az plots
2026-03-17 trying to fix UBX data
    [2025-11-25_pwv_epoch.csv, 2025-11-25_pwv_testing_epoch.csv, RINEX_pwv_epoch.csv, RINEX_pwv_test_epoch.csv]
2026-03-21 parsed more data
    [2025-9-30_103727_serial-COM4_MON_COMMS.csv, 2025-9-30_103727_serial-COM4_MON_RF.csv, 2025-9-30_103727_serial-COM4_NAV_CLOCK.csv, 2025-9-30_103727_serial-COM4_NAV_HPPOSECEF.csv, 2025-9-30_103727_serial-COM4_NAV_HPPOSLLH.csv, 2025-9-30_103727_serial-COM4_NAV_PVT.csv, 2025-9-30_103727_serial-COM4_NAV_SAT.csv, 2025-9-30_103727_serial-COM4_NAV_SIG.csv]
2026-03-21 added Kalman filter
2026-03-27 re-tracking drivers
2026-03-27 offload files to NAS
    [2025-10-3_175741_serial-COM4_NAV_CLOCK.csv, 2025-10-3_175741_serial-COM4_NAV_HPPOSECEF.csv, 2025-10-3_175741_serial-COM4_NAV_HPPOSLLH.csv, 2025-10-3_175741_serial-COM4_NAV_TIMEUTC.csv, 2025-10-3_175741_serial-COM4_RXM_RAWX.csv, 2025-10-3_175741_serial-COM4_RXM_SFRBX.csv, 2025-11-25_93138_serial-COM3_NAV_CLOCK.csv, 2025-11-25_93138_serial-COM3_NAV_TIMEUTC.csv]
2026-04-10 removed old files
    [pwv_calc.ods]
